FotisRousogiannis/Master-s-Thesis/README.md

# Master-s-Thesis
DEVELOPMENT OF ROBOTIC ARM AND INDEGRATION OF COMPUTER VISION METHODS
