FotisRousogiannis/Master-s-Thesis/docs/decisions/0015-power-architecture-v1.md

# ADR-0015: Αρχιτεκτονική τροφοδοσίας v1 — δύο εξωτερικές γραμμές (7.4 V servo, 5.1 V λογική)

- **Κατάσταση:** Αποδεκτή
- **Ημερομηνία:** 2026-11-08

## Πλαίσιο
Κάθε πλακέτα τμήματος (ADR-0013) τροφοδοτεί έως 9 servo (0.4–0.8 A το καθένα, 2–3 A σε κόλλημα), το Raspberry Pi
(έως 3 A στα 5.1 V), το ESP32 και τους αισθητήρες. Διαθέσιμα: τροφοδοτικό 30 V / 10 A και δύο buck XY5008E (5 A).
Η λογική δεν πρέπει να επηρεάζεται από τις πτώσεις τάσης των servo.

## Εναλλακτικές
1. **Δύο εξωτερικές γραμμές** (7.4 V servo + 5.1 V λογική) προς κάθε πλακέτα· 3.3 V με buck πάνω στην πλακέτα.
2. **Μία γραμμή 7.4 V**, με 5.1 V / 3.3 V στην πλακέτα — λιγότερα καλώδια, αλλά το Pi/ESP32 κινδυνεύουν με reset
   όταν τα servo ρίχνουν την τάση.
3. **Μία γραμμή 24 V** με όλες τις τάσεις στην πλακέτα (buck ~10 A) — η πρακτική των βιομηχανικών βραχιόνων:
   ~3× μικρότερο ρεύμα στα καλώδια, ανεξάρτητα τμήματα· αλλά δύσκολο και θερμό κύκλωμα σε πλακέτα 10 × 10 cm.

## Απόφαση
**Επιλογή 1 για το v1.** Η επιλογή 3 καταγράφεται ως κατεύθυνση για το v2.

## Αιτιολόγηση
Πλήρης διαχωρισμός ισχύος servo και λογικής (καμία επίδραση των servo στο Pi/ESP32/αισθητήρες)· το θερμό,
υψηλού ρεύματος κύκλωμα μένει εκτός της πυκνής πλακέτας· αξιοποιούνται τα υπάρχοντα buck. Πτώση τάσης στο καλώδιο
προς τον καρπό (18 AWG, ~1 m, 5 A): ~0.2 V — αποδεκτή.

## Συνέπειες
- Buck servo ρυθμισμένο στα **7.2–7.4 V** (προδιαγραφή servo: 5.0–7.4 V)· όχι 7.8 V.
- Καλώδια 7.4 V **≥ 18 AWG** μέχρι τον καρπό.
- **E-stop κεντρικά** στη γραμμή 7.4 V (στη βάση, πριν από τις πλακέτες) + E-stop σε κάθε πλακέτα ως δεύτερο επίπεδο.
- Το USB-C του ESP32 τροφοδοτεί μόνο το ESP32 (προγραμματισμός), με δίοδο ώστε να μην τροφοδοτεί την υπόλοιπη πλακέτα.
- Οι connectors τροφοδοσίας πρέπει να **μην ταιριάζουν** με τους connectors σημάτων (αποφυγή λάθους σύνδεσης).

## Συμπλήρωμα (2026-11-08): προστασίες εισόδων
- **eFuse** σε κάθε είσοδο: **TPS259827** στα 7.4 V (όριο ~10 A, soft-start για την αιχμή φόρτισης των πυκνωτών,
  pin EN ώστε το ESP32/Pi να κόβει με υλικό την τροφοδοσία των servo σε σφάλμα ή απώλεια επικοινωνίας) και **TPS25947**
  στα 5.1 V (όριο ~4 A, αποκλεισμός ανάστροφου ρεύματος — αντικαθιστά ασφάλεια + ιδανική δίοδο για το Pi).
- Παραμένουν: P-MOSFET προστασίας πολικότητας (το eFuse δεν την καλύπτει), TVS (ταχύτερο για στιγμιαίες αιχμές),
  εφεδρική ασφάλεια 15 A στα 7.4 V, E-stop υλικού σε σειρά που απενεργοποιεί και το eFuse.
- eFuse ανά κανάλι: εκτός v1.

## Συμπλήρωμα (2026-11-08): έξοδος τροφοδοσίας προς την επόμενη πλακέτα
- Κάθε πλακέτα έχει **έξοδο 7.4 V** (XT30UPB-F, θηλυκό, κάθετο) και **έξοδο 5.1 V** (MSTB 2 pins) για την επόμενη
  πλακέτα (πλάτη → καρπός), ώστε να αρκεί ένα ζεύγος τροφοδοτικών για όλο τον βραχίονα.
- Σημείο λήψης: **πριν από το eFuse** της πλακέτας (μετά την ασφάλεια 15 A, την προστασία πολικότητας και το TVS στα
  7.4 V· μετά το TVS στα 5.1 V). Επιλογή του Φώτη (εναλλακτική: μετά το eFuse, με κοινό όριο ρεύματος για όλα).
  - Κάθε πλακέτα κρατά **δικό της** όριο ρεύματος (10 A servo / 4.4 A λογική) και δική της αποκοπή servo (EN).
  - Η ασφάλεια 15 A, το XT30 και το P-MOSFET της πρώτης πλακέτας φέρουν το ρεύμα **όλου** του βραχίονα (στόχος ≤ 8 A
    συνεχώς)· οι διαδρομές `VS_*` στο PCB διαστασιολογούνται για 15 A.
  - **E-stop:** κουμπί με **2 επαφές NC** (μία στο connector E-STOP κάθε πλακέτας) ή γέφυρα (jumper) σε πλακέτα χωρίς
    E-stop· το κεντρικό E-stop στη γραμμή 7.4 V (παραπάνω) παραμένει.
