FotisRousogiannis/Master-s-Thesis/docs/decisions/0009-provisional-kinematic-model.md

# ADR-0009: Προσωρινό κινηματικό μοντέλο μέχρι το export από Fusion 360

- **Κατάσταση:** Αποδεκτή
- **Ημερομηνία:** 2026-10-20

## Πλαίσιο
Το CAD του βραχίονα βρίσκεται στο Fusion 360 και δεν έχει εξαχθεί ακόμα. Για να
προχωρήσει η ανάπτυξη (URDF, RViz, Gazebo, ros2_control, CI) χρειάζεται ένα μοντέλο τώρα.

## Απόφαση
- Προσωρινό URDF (`arm_description/urdf/arm.urdf.xacro`) με 6 περιστροφικές
  **λογικές** αρθρώσεις `joint_1` … `joint_6`, κυλινδρικούς συνδέσμους και
  ενδεικτικές διαστάσεις/μάζες (σύνολο ~4.6 kg, ύψος ~1.1 m).
- Όρια ταχύτητας από το BOM: 300°/s ÷ 36 ≈ 8.3°/s ≈ 0.145 rad/s.
- Όλες οι προσωρινές τιμές συγκεντρώνονται ως `xacro:property` στην αρχή του αρχείου.
- Το URDF περιγράφει **λογικές** αρθρώσεις· η μίξη των διαφορικών γίνεται στο firmware (ADR-0005).

## Συνέπειες
- Όταν έρθει το export (URDF + STL ανά σύνδεσμο), αντικαθίστανται γεωμετρία,
  μάζες, αδράνειες και η διάταξη/ονόματα αρθρώσεων· το ADR αυτό σημειώνεται ως αντικατασταθέν.
- Τα tests του `arm_description` ελέγχουν δομή (6 αρθρώσεις, ενιαία αλυσίδα,
  έγκυρα όρια, θετικές μάζες) και πρέπει να συνεχίσουν να περνούν.
