FotisRousogiannis/Master-s-Thesis/hardware/pcb/segment_board/SPEC.md

# Πλακέτα τμήματος (segment board) — προδιαγραφή v1

Μία κοινή πλακέτα για **κάθε τμήμα** του βραχίονα (link 1, καρπός). Ίδιο PCB παντού·
διαφορετικά εξαρτήματα κουμπώνονται ανάλογα με τη θέση. Απόφαση: ADR-0013.
Κατάσταση: **εγκεκριμένη** (2026-11-07) — 4 στρώσεις, 5 τεμάχια, SMD με συναρμολόγηση από το εργοστάσιο.

## 1. Βασικές απαιτήσεις
| # | Απαίτηση |
|---|---|
| R1 | Διαστάσεις **100 × 100 mm**, **4 στρώσεις** (Σήμα / GND / Τροφοδοσία / Σήμα), **4 οπές M3 περιμετρικά (γωνίες)** — η θήκη σχεδιάζεται από τον φοιτητή γύρω από την πλακέτα. Παραγγελία **5 τεμαχίων**. |
| R2 | **ESP32-S3-WROOM-1** (SMD module με πιστοποιημένη κεραία) πάνω στην πλακέτα — ο τοπικός ελεγκτής κάθε τμήματος· **USB-C** για προγραμματισμό/debug. |
| R3 | **Υποδοχή για Raspberry Pi 4 από πάνω, ανάποδα (εξαρτήματα προς την πλακέτα):** ψηλό female header 2×20 στην πάνω πλευρά + 4 οπές M2.5 (58 × 49 mm) για αποστάτες ~20 mm. Η πλακέτα βιδώνει πρώτα στα mounts· το Pi μπαίνει/βγαίνει από πάνω. Επειδή το Pi είναι ανάποδα, η διάταξη του header είναι **κατοπτρική** ως προς το πρότυπο HAT. Κάτω από το περίγραμμα του Pi μόνο χαμηλά SMD (ελεύθερο ύψος ≥ 18 mm για USB/Ethernet του Pi). |
| R3α | **Τροφοδοσία του Pi από τα pins 5V του GPIO** (pins 2, 4· GND 6, 9, 14, 20, 25, 30, 34, 39), από τη γραμμή λογικής 5.1 V της πλακέτας, με ασφάλεια, TVS και **ιδανική δίοδο** ώστε να μην υπάρχει σύγκρουση αν συνδεθεί ταυτόχρονα και το USB-C του Pi. |
| R4 | **Κάθε πλακέτα αυτόνομα λειτουργική για ολόκληρο τον βραχίονα:** υποδοχές για **9 servo, 6 AS5600, 2 ZD10**, ανεξάρτητα από το πόσα χρησιμοποιούνται σε κάθε θέση. Τα επιπλέον κανάλια (PCA9685 9–15, mux 6–7, ADS A2–A3) σε header επέκτασης. |
| R5 | Λειτουργία **ESP32 ως master I²C** (στόχος) ή **Pi ως master I²C** (σημερινός πάγκος, χωρίς ESP32), με jumpers. Ποτέ και οι δύο μαζί. |
| R6 | **Pi ↔ ESP32** ίδιας πλακέτας: UART0 (GPIO14/15) + έλεγχος EN/BOOT από 2 GPIO του Pi. **Προς την άλλη πλακέτα:** RS-485 full-duplex στο connector LINK, που συνδέεται με jumper στο UART5 του Pi (GPIO12/13) ή στο UART του ESP32 (ADR-0014). |
| R7 | Τροφοδοσία servo έως **~8 A** συνεχώς. **eFuse** στις εισόδους 7.4 V (TPS259827: όριο ~10 A, soft-start, **αποκοπή τροφοδοσίας servo από ESP32/Pi**) και 5.1 V (TPS25947: όριο ~4 A, αποκλεισμός ανάστροφου ρεύματος). E-stop υλικού σε σειρά (ανεξάρτητο από ηλεκτρονικά), προστασία πολικότητας, TVS, εφεδρική ασφάλεια 15 A, μεγάλοι πυκνωτές. **Έξοδοι 7.4 V (XT30) και 5.1 V (MSTB) προς την επόμενη πλακέτα**, πριν από το eFuse (ADR-0015). |
| R8 | **SMD** εξαρτήματα, συναρμολόγηση από το εργοστάσιο (JLCPCB PCBA, μία πλευρά). Διαμπερή (THT) μόνο για connectors, κλέμες, header HAT και ηλεκτρολυτικούς. |

## 2. Μπλοκ διάγραμμα
```
 7.4 V servo (XT30) ─► [ασφάλεια 15 A] ─► [P-MOSFET πολικότητας] ─► [TVS] ─► [E-STOP] ─► [eFuse TPS259827, ~10 A,
                       soft-start, EN ← ESP32/Pi] ─► [πυκνωτές] ─► [INA219 shunt] ─► servo (σήματα από PCA9685)
 5.1 V λογική (MSTB) ─► [TVS] ─► [eFuse TPS25947, ~4 A, αποκλεισμός ανάστροφου ρεύματος] ─┬─► 5V pins Pi (GPIO)
                                                                                         └─► buck 3.3 V ─► ESP32, PCA9685,
                                                                                             TCA9548A, ADS1115, INA219, TCA9535, AS5600, ZD10
 USB-C ESP32 ─► [ιδανική δίοδος LM66100] ─► (τροφοδοσία μόνο για προγραμματισμό)

          ESP32 SDA/SCL ──┐  jumper «I²C master»
          Pi GPIO2/3   ───┴──► κύριο bus I²C ─┬─ PCA9685 (0x40)
                                              ├─ ADS1115 (0x48)
                                              ├─ INA219  (0x44)
                                              └─ TCA9548A (0x70) ─► AS5600 ×6 (κανάλια 0–5),
                                                                     κανάλια 6–7: εφεδρικά
          ESP32 UART ◄── jumpers ──► Pi UART (GPIO14/15)
          ESP32 UART2 ◄────────────► connector «LINK» (UART / RS-485) προς την άλλη πλακέτα
```

## 3. Υποδοχές (connectors)
| Λειτουργία | Πλήθος | Τύπος (πρόταση) | Σημείωση |
|---|---|---|---|
| Servo | 9 | MCV 1,5/3-G-3,5 — **1 GND · 2 V+ · 3 σήμα** (ίδια σειρά με το καλώδιο servo: καφέ, κόκκινο, πορτοκαλί) | V+ και GND από επιφάνειες χαλκού· κανάλια 9–15 σε header επέκτασης |
| AS5600 | 6 | MCV 1,5/4-G-3,5 — **1 GND · 2 VCC (3.3 V) · 3 SCL · 4 SDA** (όπως η υπάρχουσα καλωδίωση) | κανάλια 0–5 του TCA9548A· 6–7 σε header επέκτασης |
| Αισθητήρες αφής ZD10 | 2 | MCV 1,5/2-G-3,5 (3.3 V, σήμα) | διαιρέτης 6.8 kΩ πάνω στην πλακέτα (A0, A1) |
| Αναλογικές εφεδρικές | 2 | pin header | A2, A3 του ADS1115 |
| Τροφοδοσία servo 7.4 V | 1 | MCV 1,5/4-G-3,5 (2 × V+, 2 × GND) | 2 pins παράλληλα ανά πόλο (8 A/pin) |
| Τροφοδοσία λογικής 5.1 V | 1 | MCV 1,5/2-G-3,5 | Pi έως 3 A + ESP32 + λογική |
| E-STOP | 1 | MCV 1,5/2-G-3,5 — επαφή NC **σε σειρά με τη γραμμή EN του eFuse servo** (χαμηλό ρεύμα· η κεντρική E-stop κόβει τα 7.4 V στη βάση) | jumper γέφυρας όταν δεν συνδέεται κουμπί |
| LINK προς άλλη πλακέτα | 1 | MCV 1,5/5-G-3,5 (Y, Z, A, B, GND) — RS-485 full-duplex | καλώδιο 2 συνεστραμμένων ζευγών (π.χ. Ethernet) |
| Θύρα I²C επέκτασης | 1 | JST-SH 4 pin (Qwiic) | για μελλοντικούς αισθητήρες |

## 3α. Κύρια εξαρτήματα (SMD) — πρόταση
| Λειτουργία | Εξάρτημα | Συσκευασία | Σημείωση |
|---|---|---|---|
| Ελεγκτής | **ESP32-S3-WROOM-1-N8R8** | module SMD | ενσωματωμένη κεραία, στην άκρη της πλακέτας με keep-out χαλκού (ADR-0014) |
| RS-485 | **THVD1451** full-duplex 3.3 V, χωρίς pins ενεργοποίησης | VSON-8 | + 120 Ω τερματισμός με jumper |
| USB | USB-C 16-pin + USBLC6-2SC6 (ESD) + 2 × 5.1 kΩ (CC) | SMD | εγγενές USB του S3: προγραμματισμός χωρίς επιπλέον chip |
| Οδηγός servo | **PCA9685PW** | TSSOP-28 | |
| Mux I²C | **TCA9548APWR** | TSSOP-24 | + pull-ups σε κάθε κανάλι |
| ADC αφής | **ADS1115IDGS** | VSSOP-10 | |
| Ρεύμα servo | **INA219AIDCN** + shunt **5 mΩ, 2512, ≥ 1 W** | SOT-23-8 | εύρος έως ~±64 A, ανάλυση ~0.2 mA· 8 A → 0.32 W στο shunt |
| 3.3 V | buck 2 A από τα 5.1 V (π.χ. AP63203) | SOT-23-6 | το ESP32 τραβά αιχμές ~0.5 A στο WiFi· γραμμικός θα ζεσταινόταν |
| Προστασία πολικότητας 7.4 V | P-MOSFET ≥ 12 A (π.χ. AO4407A) | SO-8 | χαμηλές απώλειες σε σύγκριση με δίοδο |
| eFuse 7.4 V | **TPS259827** | VQFN-24 | όριο ~10 A, soft-start, EN |
| eFuse 5.1 V | **TPS25947** | VQFN-10 | όριο ~4 A, αποκλεισμός ανάστροφου ρεύματος |
| Εφεδρική ασφάλεια 7.4 V | 15 A (blade ή SMD 2410) | — | τελευταία γραμμή άμυνας |
| TVS εισόδων | SMBJ9.0A (7.4 V), SMBJ5.0A (5.1 V) | SMB | προστασία από υπερτάσεις |
| Πυκνωτές servo | 2 × 1000 µF / 16 V + κεραμικοί | THT + SMD | αιχμές ρεύματος |
| Κουμπιά | BOOT, RESET | SMD | |
| Ενδείξεις τροφοδοσίας | 4 LED: 7.4 V (μετά από ασφάλεια/E-stop), 5.1 V, 3.3 V, «Pi αναμμένο» (από τα 3V3 του Pi) | 0603 | χωρίς λογισμικό |
| LED σύνδεσης | 17 LED + 5 × **LM339** + αντιστάσεις μέτρησης | 0603 + SOIC-14 | βλ. §3γ |
| LED κατάστασης ESP32 | 1 LED σε GPIO (κόκκινο) | 0603 | |
| Χρώματα LED | κιτρινοπράσινο AlInGaP (Everlight 19-217/G7C, C2986030) για τροφοδοσία + σύνδεση, κίτρινο για «Pi αναμμένο», κόκκινο για κατάσταση — όλα Vf ≈ 2 V, ώστε να φωτίζουν από 3.3 V (μπλε/πράσινο InGaN ≈ 3 V θα ήταν σχεδόν σβηστά· `sim/`) | 0603 | |

## 3γ. LED σύνδεσης ανά connector (v1: με υλικό)
Ένα LED δίπλα σε **κάθε** connector (9 servo + 6 encoders + 2 αφής = **17 LED**): **αναμμένο = συνδεδεμένο**,
**σβηστό = όχι**, χωρίς λογισμικό και χωρίς επιπλέον pins. Ανίχνευση ρεύματος στην **επιστροφή γείωσης** κάθε connector
και συγκριτής **LM339** (open collector → LED):
- **Encoder:** αντίσταση μέτρησης 10 Ω (6.5 mA → 65 mV), αναφορά ~33 mV.
- **Αισθητήρας αφής:** σύγκριση της τάσης του διαιρέτη (0 V χωρίς αισθητήρα, ~0.9 V με αισθητήρα) με 0.3 V.
- **Servo:** αντίσταση μέτρησης **10 Ω** + Schottky **SS54** (5 A, SMA, basic C22452) παράλληλα (περιορισμός πτώσης ~0.33 V στα 0.8 A, ~0.45 V στο μπλοκάρισμα 4 A), αναφορά ~10 mV
  → ανίχνευση στα 0.5–1.5 mA (με το offset του LM339). QY3240MG: ρεύμα ηρεμίας ~5–10 mA, μπλοκάρισμα ~2.5–4 A (στοιχεία από το διαδίκτυο,
  όχι datasheet· παρόμοια servo 4–20 mA) → περιθώριο ≥ ×3. Το SS34 (3 A) δεν άντεχε το μπλοκάρισμα → SS54.
  Παρατεταμένο μπλοκάρισμα (1.8 W στη δίοδο) πρέπει να κόβεται από το firmware (INA219 / encoder). Επιβεβαίωση με μέτρηση.
  Ίδια τιμή με τον encoder (λιγότερες γραμμές BOM). Προσομοίωση: `sim/`.
5 × LM339 (20 συγκριτές, 17 σε χρήση).

## 3β. Οικογένεια connectors
Ο υπόλοιπος βραχίονας χρησιμοποιεί **Phoenix Contact MC 1,5/n-ST-3,5** (φις κλέμας, βήμα 3.5 mm, έως 8 A/pin).
Στην πλακέτα: υποδοχές **MC 1,5/n-G-3,5** (οριζόντιες) ή **MCV 1,5/n-G-3,5** (κάθετες) — footprints
`Connector_Phoenix_MC:PhoenixContact_MC(V)_1,5_n-G-3.5_1x0n_P3.50mm_*`. Τα ρεύματα > 4 A περνούν από
δύο pins παράλληλα.

Υπάρχουσα καλωδίωση βραχίονα (φωτογραφίες 2026-11-07):
- **Servo:** ένα φις 3 pins ανά servo, σειρά **1 GND · 2 V+ · 3 σήμα** (πρόταση, ίδια με το καλώδιο servo).
- **Encoder AS5600:** ένα φις 4 pins ανά encoder, σειρά **1 GND · 2 VCC (3.3 V) · 3 SCL · 4 SDA**.
- **Βάση:** connector 8 pins = 2 encoders (4 + 4).
- **Πάνελ πλάτης (link):** 4 φις servo (3 pins) + 2 φις encoder (4 pins).

Θέσεις πλακετών: **μία στην πλάτη** (κάτω μέρος, με το Pi) και **μία στον καρπό**. Τα πάνελ του βραχίονα
συνδέονται με τις πλακέτες με καλώδια ένα-προς-ένα (ίδια σειρά pins). Connectors πλακέτας **κάθετοι (MCV)**.
Καλώδια I²C (encoders) πάνελ → πλακέτα: < ~30 cm.

## 4. Jumpers
| Jumper | Θέσεις | Χρήση |
|---|---|---|
| JP_I2C | ESP32 / Pi | ποιος οδηγεί το κύριο bus I²C |
| JP_UART | ανοιχτό / κλειστό | σύνδεση UART0 Pi ↔ ESP32 της ίδιας πλακέτας (+ EN/BOOT) |
| JP_LINK | Pi / ESP32 | το RS-485 του LINK πάει στο UART5 του Pi (link 1) ή στο ESP32 (καρπός) |
| JP_TERM | ανοιχτό / κλειστό | τερματισμός 120 Ω στο άκρο λήψης του RS-485 |
| JP_ESTOP | γέφυρα | όταν δεν υπάρχει κουμπί E-stop |

## 5. Διευθύνσεις I²C (κάθε πλακέτα έχει δικό της bus)
| Συσκευή | Διεύθυνση | Ρύθμιση |
|---|---|---|
| PCA9685 | 0x40 | προεπιλογή |
| INA219 | **0x44** | A1 → VS (η 0x40 συγκρούεται με τον PCA9685) |
| ADS1115 | 0x48 | ADDR → GND· A0/A1 = ZD10, A2 εφεδρική, **A3 = μέτρηση 3.3 V** (διόρθωση ratiometric) |
| TCA9548A | 0x70 | προεπιλογή |
| AS5600 | 0x36 | πίσω από τον mux, ένας ανά κανάλι |

## 6. Χρήση ανά θέση
| | Κάτω μέρος (link 1) | Πάνω μέρος (καρπός) |
|---|---|---|
| ESP32 | ✅ | ✅ |
| Raspberry Pi (HAT) | ✅ | — |
| Servo | **4** | **5** |
| AS5600 | **3** | **3** |
| ZD10 | — | **2** |
| LINK | προς καρπό | προς link 1 |

Σύνολο: 9 servo, 6 encoders, 2 αισθητήρες αφής. **Κάθε πλακέτα** έχει υποδοχές για **όλα** (9 / 6 / 2) και μπορεί να οδηγήσει μόνη της ολόκληρο τον βραχίονα· επέκταση έως 16 servo / 8 encoders μέσω header.

## 7. Ανοιχτά σημεία
- Διαθεσιμότητα εξαρτημάτων στη βιβλιοθήκη της JLCPCB (basic/extended) — οριστικοποίηση στο BOM.
- Τροφοδοσία Pi μέσω των 5V pins του HAT (παρακάμπτει την ασφάλεια του Pi) — απαιτεί ασφάλεια στην πλακέτα.

## 8. Εκτός v1 — ιδέες για επόμενη έκδοση
- Ανίχνευση σύνδεσης **με υλικό** (συγκριτές ρεύματος ανά connector).
- **Επαναφερόμενη ασφάλεια (PTC) ανά κανάλι** servo/encoder.
- **«Έξυπνοι διακόπτες»** τροφοδοσίας ανά servo (open-load, προστασία, ανοιγοκλείσιμο ανά servo).
- **Οθόνη OLED** 0.96" (I²C) για κατάσταση/διάγνωση.
- Υποδοχή **USB-C** για τροφοδοσία του Pi (εναλλακτικά των pins του GPIO).

## 9. Σχηματικό
Παράγεται από κώδικα: `gen/build.py` (μοναδική πηγή του κυκλώματος) → `segment_board.kicad_sch` + 5 φύλλα,
`lib/segment_board.kicad_sym` (σύμβολα που λείπουν από το KiCad: TPS259827, TPS259472A, LM66100, AO4407A, από τα datasheets).
PDF: `output/segment_board_schematic.pdf`. Έλεγχος: `gen/check_netlist.py` (+ ERC στο KiCad 9).
Εκκρεμότητες: footprints των eFuse (TI RGE0024 με 2 EP, RPW0010A) και κατοπτρικό footprint του header του Pi — στο layout.
