FotisRousogiannis/Master-s-Thesis/NOTES.md

# Σημειώσεις εργασίας — Διπλωματική

Αυτό το αρχείο κρατά τις αποφάσεις και την κατάσταση της διπλωματικής, ώστε
κάθε νέα συνεδρία να συνεχίζει από εκεί που μείναμε. **Διάβασέ το πρώτο και
ενημέρωσέ το** όταν αλλάζει κάτι (δομή, αποφάσεις, πρόοδος).

## Στοιχεία εργασίας
- **Τίτλος (EL):** ΑΝΑΠΤΥΞΗ ΚΑΙ ΣΧΕΔΙΑΣΜΟΣ ΡΟΜΠΟΤΙΚΟΥ ΒΡΑΧΙΟΝΑ 6 ΑΞΟΝΩΝ ΕΛΕΥΘΕΡΙΑΣ ΚΑΙ ΕΦΑΡΜΟΓΗ ΜΕΘΟΔΩΝ ΤΕΧΝΗΤΗΣ ΟΡΑΣΗΣ
- **Τίτλος (EN):** DESIGN AND DEVELOPMENT OF A 6-DOF ROBOTIC ARM AND IMPLEMENTATION OF COMPUTER VISION METHODS
- **Φοιτητής:** Φώτης Ρουσογιάννης
- **Επιβλέποντες:** Γεράσιμος Ποταμιάνος – Κατερίνα Παπαδημητρίου
- **Τμήμα:** Ηλεκτρολόγων Μηχανικών και Μηχανικών Υπολογιστών, Πανεπιστήμιο Θεσσαλίας
- **Ημερομηνία (εξώφυλλο):** 10/2026

## Δομή repository (ADR-0003)
- `thesis/Syggrafi_Diplomatikis_Ergasias_Word_PPS_Ypodeigma_July_2021.docx` — **το
  κείμενο της διπλωματικής** (υπόδειγμα ΠΠΣ).
- `software/` — `docker/` (περιβάλλον), `ros2_ws/` (ROS 2 packages), `firmware/` (ESP32),
  `cad_export/` (export από Fusion 360).
- `docs/architecture.md` — η τρέχουσα αρχιτεκτονική με μια ματιά.
- `docs/decisions/` — ADR: κάθε απόφαση με εναλλακτικές και αιτιολόγηση.
- `docs/devlog.md` — ημερολόγιο ανάπτυξης.
- `docs/testing/` — πρωτόκολλα και αποτελέσματα δοκιμών στον βραχίονα.
- `test.txt` — παλιό αρχείο δοκιμής, άσχετο με την εργασία.

## Branches
`draft` (ανάπτυξη) → `testing` (επαληθευμένο σε sim, προς δοκιμή στο υλικό)
→ `main` (μόνο εγκεκριμένα). Προώθηση με Pull Request. Commits στο όνομα του
Φώτη, χωρίς αναφορές σε εργαλεία AI.

## Αρχιτεκτονική λογισμικού (σύνοψη — λεπτομέρειες στο docs/architecture.md)
- Λογισμικό από την αρχή (fresh start)· ο παλιός κώδικας του Robotic-Arm/software δεν χρησιμοποιείται.
- Υπολογιστής = μοναδικός ROS 2 host (ROS 2 Jazzy σε Docker): ros2_control,
  micro-ROS Agent, MoveIt 2, όραση, RViz/Gazebo. **Χωρίς Raspberry Pi.**
- 2 PCB με ESP32 (link 1, wrist): τοπικός βρόχος θέσης στα AS5600, μίξη
  διαφορικών, watchdog. Ένα node ανά ESP32, ίδιο firmware, micro-ROS.
- I²C μόνο μέσα στην πλακέτα· WiFi (micro-ROS/UDP) προς υπολογιστή· USB για debugging.
- RealSense D435if σταθερή (eye-to-hand), USB 3 στον υπολογιστή.

## Πηγή τεχνικής τεκμηρίωσης
Repo `FotisRousogiannis/Robotic-Arm`, branch `claude/connected-repository-d8u6hw`
(δημόσιο, μόνο ανάγνωση από εδώ — clone στο `/home/user/fotisrousogiannis/robotic-arm`):
- `docs/BOM.md` — εξαρτήματα, servo QY3240MG + πλανητικός 1:36, έδρανα, επιδόσεις
- `docs/MECHANICAL_STANDARDS.md` — κοχλίες, ανοχές, γρανάζια, DIN 5480, I²C map
- `docs/MECHANICAL_ANALYSIS.md` — ροπές, φόρτιση δοντιών, διαφορικά (5 kg)
- `docs/ARCHITECTURE.md`, `docs/SYSTEM_ARCHITECTURE.md` — διαφορικοί σύνδεσμοι,
  ESP32 ανά τμήμα + micro-ROS, κατανεμημένο ROS 2 + UI
- `docs/BENCH_TESTING.md` — δοκιμές ταχύτητας/ρεύματος (Pi + PCA9685)
- Επίσης: `Papers/`, `Reports/`, και οι επίσημες οδηγίες ΠΠΣ
  (`ΟΔΗΓΙΕΣ ΕΚΠΟΝΗΣΗΣ ΔΙΠΛΩΜΑΤΙΚΩΝ ΕΡΓΑΣΙΩΝ (ΠΠΣ) July 30 2021.pdf`).

Τα τεχνικά στοιχεία (αριθμοί, εξαρτήματα) **παίρνονται από εκεί** — δεν
επινοούνται. Αν κάτι λείπει ή είναι ❓ στα docs, ρωτάμε τον Φώτη.

## Δομή κεφαλαίων (συμφωνημένη, όπως στην §1.2)
1. **Εισαγωγή** — πλαίσιο, αντικείμενο, συνεισφορά, οργάνωση τόμου
2. **Θεωρητικό υπόβαθρο** — βασικές έννοιες ρομποτικής (κινηματική κ.λπ.), τεχνητή όραση
3. **Μηχανικός σχεδιασμός** — κινηματική διαμόρφωση, αρθρώσεις, μηχανισμοί μετάδοσης
4. **Ηλεκτρονική σχεδίαση** — τροφοδοσία, έλεγχος ενεργοποιητών, αισθητήρες
5. **Λογισμικό & αρχιτεκτονική ελέγχου (ROS 2)**
6. **Τεχνητή όραση & τρισδιάστατη αντίληψη** — κάμερα RGB-D, εκτίμηση θέσης/προσανατολισμού
7. **Ολοκλήρωση υποσυστημάτων** — αυτόνομος χειρισμός αντικειμένων
8. **Πειραματική αξιολόγηση & συμπεράσματα** — αποτελέσματα, περιορισμοί, μελλοντικές επεκτάσεις

## Κατάσταση
- [x] Εξώφυλλα (EL/EN) — τίτλος, όνομα, επιβλέποντες, ημερομηνία
- [x] Κεφ. 1: Εισαγωγή, 1.1 Αντικείμενο, 1.1.1 Συνεισφορά, 1.2 Οργάνωση τόμου
- [ ] Καθάρισμα Κεφ. 1: διπλή ενότητα «Οργάνωση του τόμου» (η πρώτη είναι του
      υποδείγματος, με σπασμένη παραπομπή), οδηγίες υποδείγματος σε [...]
- [ ] Επιτροπή εξέτασης, υπεύθυνες δηλώσεις (ονόματα), ευχαριστίες
- [ ] Περίληψη / Abstract + λέξεις-κλειδιά (τώρα είναι του υποδείγματος)
- [ ] Κεφ. 2–8 (τα Κεφ. 2–6 του αρχείου είναι ακόμα περιεχόμενο υποδείγματος)
- [ ] Βιβλιογραφία, Συντομογραφίες, Παραρτήματα
- [ ] Ενημέρωση πινάκων περιεχομένων / εικόνων / πινάκων (στο Word: F9)

## Κατάσταση λογισμικού / υλικού (2026-11-08)
- **Περιβάλλον ανάπτυξης** λειτουργικό (Docker, ROS 2 Jazzy) — `docs/setup/ubuntu.md`, tag `v0.1-dev-env` στο `testing`.
- **URDF:** προσωρινό (ADR-0009). Export από Fusion: δικό μας script `software/tools/fusion_export/` (ADR-0011) — δεν έχει τρέξει ακόμα στον βραχίονα.
- **Πάγκος καρπού** (Raspberry Pi, ADR-0012): `software/tools/wrist_bench/` + πρωτόκολλο `docs/testing/wrist_bench.md`.
  PCA9685 στο mux κανάλι 0, AS5600 στα κανάλια 1/6/7, servo νεκρό σημείο 1600 µs (500–2500),
  διαφορικό στα κανάλια 9/10 με ανεστραμμένο Β. Τα servo κινούνται με `jog`· εκκρεμεί πλήρης αντιστοίχιση καναλιών (T3/T4) και T5.
- **Αισθητήρες αφής:** 2 × ZD10 + ADS1115 (0x48, mux κανάλι 2), διαιρέτης με **6.8 kΩ** — επαληθευμένο (2.5 V σε μέγιστη πίεση). `docs/hardware/wiring.md`.
- **PCB segment board** (`hardware/pcb/segment_board/`, ADR-0013/14/15): σχηματικό από κώδικα (`gen/build.py`),
  ERC KiCad 9 χωρίς σφάλματα, προσομοίωση SPICE των αναλογικών (`sim/`), footprints project (eFuse, Pi ανάποδα, πηνίο),
  LCSC για όλα τα SMD, **αρχικό PCB** (`gen/pcb.py`, μία φορά) με κανόνες JLC/net classes (`gen/rules.py`).
- **Επόμενο:** layout στο KiCad από τον Φώτη με καθοδήγηση (τοποθέτηση → τροφοδοσίες → σήματα → DRC στο CI).
  Εκκρεμεί: μέτρηση ρεύματος ηρεμίας servo (επιβεβαίωση 10 Ω), ρύθμιση buck servo στα 7.2–7.4 V.

## Συνέχεια σε νέα συνεδρία
Πρώτα: ανάγνωση αυτού του αρχείου, του `docs/decisions/README.md`, του `docs/architecture.md` και του `docs/devlog.md`.
Commits στο όνομα του Φώτη, **χωρίς** `Co-Authored-By` ή άλλες αναφορές σε εργαλεία AI.

## Κανόνες γραφής
- Γλώσσα: ελληνικά, ακαδημαϊκό ύφος, απρόσωπη σύνταξη / παθητική φωνή
  («σχεδιάστηκε», «παρουσιάζεται»). Αγγλικοί όροι σε παρένθεση στην πρώτη
  εμφάνιση, π.χ. «βαθμοί ελευθερίας (Degrees of Freedom, DOF)».
- Συντομογραφίες που εμφανίζονται μπαίνουν και στη λίστα «Συντομογραφίες».
- Χρήση των styles του υποδείγματος: `Heading 1/2/3` για τίτλους, `Normal` για
  κείμενο, `Caption` για λεζάντες, `List Paragraph` για λίστες. Όχι χειροκίνητη μορφοποίηση.
- Λεζάντες: «Εικόνα X.Y:», «Σχήμα X.Y:», «Πίνακας X.Y:» όπως στο υπόδειγμα.
- Βιβλιογραφικές αναφορές με αριθμό σε αγκύλες [n], με τη μορφή της λίστας
  «Βιβλιογραφία» του υποδείγματος.
- Για οτιδήποτε δεν έχει ακόμα υλοποιηθεί/μετρηθεί: διατύπωση σε μέλλοντα
  ή «προβλέπεται», ποτέ ψευδή αποτελέσματα.

## Τρόπος δουλειάς
- Η επεξεργασία γίνεται και εκτός του τοπικού υπολογιστή.
  Αν ο Φώτης αλλάξει το .docx τοπικά, κάνει push πριν ζητήσει νέα αλλαγή
  (και γίνεται `git pull` πριν από κάθε αλλαγή), αλλιώς οι αλλαγές συγκρούονται.
- Επεξεργασία του .docx με `python-docx`, διατηρώντας styles και μορφοποίηση.
  Μετά από κάθε αλλαγή: commit + push στο `main`.
- Ενημέρωση της ενότητας «Κατάσταση» και «Αποφάσεις» σε αυτό το αρχείο.

## Αποφάσεις / σημειώσεις
- 2026-10-20: Αυτό το chat ορίζεται ως το επίσημο chat για τη διπλωματική.
- 2026-10-20: Κλείδωσε η αρχιτεκτονική συστήματος (ADR-0001 έως 0009).
- 2026-10-20: Περιβάλλον ανάπτυξης λειτουργικό στον υπολογιστή (Ubuntu 26.04, repo στο
  `~/Desktop/Master-s-Thesis`) — οδηγός: `docs/setup/ubuntu.md`, ADR-0010.
- Το LaTeX template εγκαταλείφθηκε — η εργασία γράφεται σε Word (υπόδειγμα ΠΠΣ).
