FotisRousogiannis/Master-s-Thesis/docs/decisions/0013-segment-board-esp32-with-pi-hat.md

# ADR-0013: Κοινή πλακέτα τμήματος με ESP32 και υποδοχή HAT για Raspberry Pi

- **Κατάσταση:** Αποδεκτή
- **Ημερομηνία:** 2026-11-07
- **Τροποποιεί:** ADR-0004 (ρόλος του Raspberry Pi)

## Πλαίσιο
- Υπάρχει διαθέσιμος χώρος **10 × 10 cm** τόσο στο link 1 όσο και στον καρπό.
- Ο βραχίονας έχει **9 servo, 6 encoders AS5600, 2 αισθητήρες αφής ZD10**.
- Διαθέσιμο σήμερα: Raspberry Pi 4 (ο πάγκος δοκιμών λειτουργεί με αυτό)· ESP32 δεν υπάρχει ακόμα.
- ADR-0005: κάθε τμήμα χρειάζεται τοπικό ελεγκτή ώστε το I²C να μη διασχίζει αρθρώσεις.
- Ο φοιτητής θέλει το Pi να μπορεί να τοποθετείται στο link 1 και να αφαιρείται.

## Εναλλακτικές
1. **Δύο διαφορετικά PCB** (ένα με Pi, ένα με ESP32) — δύο σχεδιάσεις, δύο παραγγελίες.
2. **Ένα PCB για όλο τον βραχίονα με το Pi** — I²C σε καλώδιο μέσα από τις αρθρώσεις (απορρίφθηκε στο ADR-0005).
3. **Κοινό PCB τμήματος με ESP32 και υποδοχή HAT**, ίδιο σε κάθε τμήμα, με υποδοχές για όλα τα εξαρτήματα.

## Απόφαση
**Επιλογή 3** (προδιαγραφή: `hardware/pcb/segment_board/SPEC.md`).
- Κάθε πλακέτα: ESP32-S3-WROOM-1, PCA9685, TCA9548A (6 AS5600), ADS1115 (2 ZD10 + 2 εφεδρικές), INA219, τροφοδοσία με ασφάλειες και E-stop.
- **SMD με συναρμολόγηση από το εργοστάσιο** (αντί για πλακέτα-φορέα με modules): μικρότερη, πιο αξιόπιστη
  (χωρίς headers/καλώδια ανάμεσα σε modules), επαναλήψιμη κατασκευή· κόστος: μεγαλύτερο χρόνο
  παράδοσης και δυσκολότερη διόρθωση λαθών στο υλικό.
- Υποδοχή για το Pi **από πάνω, ανάποδα**, με ψηλό header 2×20 και αποστάτες (~20 mm): η πλακέτα βιδώνει στα mounts και το Pi
  προστίθεται/αφαιρείται από πάνω. Εναλλακτικές που εξετάστηκαν: Pi από κάτω (κλασικό HAT — δεν βολεύει, η πλακέτα βιδώνει πρώτη),
  Pi κανονικά από πάνω με καλωδιοταινία (καλύτερη ψύξη, ένα καλώδιο επιπλέον). Επιλέχθηκε η απευθείας σύνδεση· η ψύξη του Pi
  δεν είναι κρίσιμη για τη χρήση του.
- Το Pi τροφοδοτείται **από τα pins 5V του GPIO** μέσω της πλακέτας (ασφάλεια, TVS, ιδανική δίοδος).
- Jumper επιλογής master I²C: **ESP32** (στόχος) ή **Pi** (σημερινός πάγκος).
- Pi ↔ ESP32 με UART· πλακέτα ↔ πλακέτα με σειριακό καλώδιο (UART, προαιρετικά RS-485).

- **4 στρώσεις**, **5 τεμάχια**. Κατανομή: κάτω μέρος (link 1) 4 servo + 3 AS5600 + Pi·
  πάνω μέρος (καρπός) 5 servo + 3 AS5600 + 2 ZD10.

## Αιτιολόγηση
Μία σχεδίαση, μία παραγγελία, εναλλάξιμες πλακέτες (και ανταλλακτικό)· συμβατή με τον σημερινό
πάγκο (Pi ως master) και με την αρχιτεκτονική-στόχο (ESP32 ανά τμήμα)· το I²C μένει τοπικό σε κάθε τμήμα.

## Συνέπειες
- Ο ρόλος του Pi γίνεται **προαιρετικός ενσωματωμένος υπολογιστής** στο link 1 (π.χ. micro-ROS Agent,
  επικοινωνία με τα ESP32), ενώ ο υπολογιστής παραμένει για MoveIt/όραση — τροποποίηση του ADR-0004.
- Ποτέ δύο masters στο ίδιο I²C: ο jumper και το firmware/λογισμικό πρέπει να το εξασφαλίζουν.
- Η διεύθυνση του INA219 μετακινείται στο 0x44 (σύγκρουση με PCA9685 στο 0x40).
- Το ESP32 ενσωματώνεται στην πλακέτα (WROOM-1)· δεν χρειάζεται ξεχωριστό DevKit.
- Ο σημερινός πάγκος (modules + Pi) παραμένει για δοκιμές μέχρι να έρθουν οι πλακέτες.
