FotisRousogiannis/Master-s-Thesis/docs/decisions/0004-compute-distribution-no-pi.md

# ADR-0004: Κατανομή υπολογισμού — υπολογιστής + ESP32, χωρίς Raspberry Pi

- **Κατάσταση:** Αποδεκτή — **τροποποιήθηκε από ADR-0013**
- **Ημερομηνία:** 2026-10-20

## Πλαίσιο
Τα ESP32 (~520 KB RAM, χωρίς Linux) δεν μπορούν να τρέξουν ros2_control,
MoveIt, όραση ή τον micro-ROS Agent. Χρειάζεται τουλάχιστον ένας υπολογιστής
με Linux/ROS 2. Το ερώτημα είναι αν αυτός θα είναι ο υπολογιστής ανάπτυξης ή
ένα ενσωματωμένο μηχάνημα πάνω στον βραχίονα.

## Εναλλακτικές
1. **Υπολογιστής ως μοναδικός host** — όλα τα «βαριά» (ros2_control, Agent,
   MoveIt, όραση, UI, Gazebo) στον υπολογιστή· τα ESP32 συνδέονται απευθείας.
2. **Raspberry Pi 4 πάνω στον βραχίονα** — ros2_control + Agent στο Pi,
   MoveIt/όραση στον υπολογιστή. Υπέρ: ενσύρματη σύνδεση με τα ESP32,
   ελεγχόμενη στάση αν χαθεί ο υπολογιστής, δρόμος προς αυτονομία. Κατά: ένα
   μηχάνημα και ένα δίκτυο ακόμα, ρύθμιση, πιθανές βλάβες· το Pi 4 δεν σηκώνει όραση.
3. **Jetson Orin onboard** — πλήρης αυτονομία με όραση onboard· κόστος και
   πολυπλοκότητα εκτός εύρους της εργασίας.

## Απόφαση
**Επιλογή 1.** Ο υπολογιστής είναι ο μοναδικός ROS 2 host. Το Raspberry Pi
αφαιρείται από την αρχιτεκτονική.

## Αιτιολόγηση
- Ο υπολογιστής βρίσκεται δίπλα στον βραχίονα στο εργαστήριο· τα πλεονεκτήματα
  του Pi (ενσύρματη σύνδεση σε απόσταση) δεν ισχύουν.
- Η όραση και το MoveIt χρειάζονται τον υπολογιστή ούτως ή άλλως, άρα το Pi
  δεν δίνει αυτονομία.
- Η ασφαλής στάση σε απώλεια σύνδεσης εξασφαλίζεται από watchdog στα ESP32 (ADR-0005).
- Λιγότερα μηχανήματα → λιγότερη ρύθμιση και λιγότερα σημεία αποτυχίας.

## Συνέπειες
- Το PCB του link 1 **δεν χρειάζεται** να είναι HAT του Pi.
- Το λογισμικό δεν αλλάζει αν αργότερα προστεθεί Pi/Jetson: μεταφέρεται εκεί
  το ros2_control και ο Agent. Καταγράφεται στις «Μελλοντικές επεκτάσεις».
