FotisRousogiannis/Master-s-Thesis/docs/decisions/0006-communication-buses.md

# ADR-0006: Δίαυλοι επικοινωνίας — I²C τοπικά, WiFi προς τον υπολογιστή

- **Κατάσταση:** Αποδεκτή — **τροποποιήθηκε από ADR-0014**
- **Ημερομηνία:** 2026-10-20

## Πλαίσιο
Χρειάζονται τρεις συνδέσεις: (α) ESP32 ↔ αισθητήρες/οδηγός servo στην ίδια
πλακέτα, (β) ESP32 ↔ υπολογιστής (στόχοι προς, θέσεις από), (γ) υπολογιστής ↔ δίκτυο.

Σύγκριση διαθέσιμων πρωτοκόλλων:

| | I²C | UART | RS-485 | CAN | WiFi |
|---|---|---|---|---|---|
| Συσκευές | πολλές (διευθύνσεις) | 2 | πολλές | πολλές | πολλές |
| Απόσταση | cm (≤ ~30 cm) | ~1–2 m | έως 1200 m | 40 m+ | δεκάδες m |
| Θόρυβος | ευαίσθητο | μέτριο | ανθεκτικό (διαφορικό) | ανθεκτικό (διαφορικό) | παρεμβολές 2.4 GHz |
| Έλεγχος λαθών | σχεδόν κανένας | λογισμικό | λογισμικό | υλικό (CRC, ACK, retry) | πρωτόκολλο |
| Καθυστέρηση | σταθερή | σταθερή | σταθερή | σταθερή, με προτεραιότητες | **μεταβλητή** (ms–100+ ms) |
| Καλώδια στις αρθρώσεις | — | 2–3 | 2 | 2 | **κανένα** |
| micro-ROS transport | όχι | ναι (serial) | ναι (serial) | όχι επίσημα | ναι (UDP) |

## Εναλλακτικές για τη σύνδεση (β) ESP32 ↔ υπολογιστής
1. **I²C ανάμεσα στις πλακέτες** — απορρίπτεται: σχεδιασμένο για εκατοστά πάνω
   σε μία πλακέτα· σε καλώδιο ~1 m δίπλα σε servo δίνει λάθη και «κολλήματα»·
   δεν υποστηρίζεται από το micro-ROS.
2. **UART / USB** — απλό και επίσημο micro-ROS transport, αλλά μόνο 2 συσκευές
   και καλώδιο μέσα από τις αρθρώσεις μέχρι τον καρπό.
3. **RS-485** — ανθεκτικό σε θόρυβο, αλλά καλώδιο στις αρθρώσεις και επιπλέον transceiver.
4. **CAN** — η βιομηχανική λύση (ενσωματωμένο TWAI στο ESP32 + transceiver),
   αλλά χωρίς επίσημο micro-ROS transport → θα απαιτούσε δικό μας πρωτόκολλο (βλ. ADR-0007).
5. **EtherCAT** — απορρίπτεται: βιομηχανικό fieldbus που απαιτεί ειδικά chip (ESC)
   σε κάθε κόμβο· δεν αφορά αυτή την κλίμακα.
6. **WiFi (micro-ROS over UDP)** — κανένα καλώδιο δεδομένων στις αρθρώσεις,
   επίσημο transport, αλλά μεταβλητή καθυστέρηση και πιθανές απώλειες.

## Απόφαση

| Σύνδεση | Πρωτόκολλο |
|---|---|
| ESP32 ↔ PCA9685, TCA9548A, AS5600 (ίδιο τμήμα) | **I²C** |
| ESP32 ↔ υπολογιστής — κανονική λειτουργία | **WiFi**, micro-ROS over UDP |
| ESP32 ↔ υπολογιστής — bring-up / debugging | **USB σειριακό** (micro-ROS serial) |
| Υπολογιστής ↔ router | **Ethernet** |

Το transport του micro-ROS (UDP ή serial) επιλέγεται με ρύθμιση στο ίδιο firmware.

## Αιτιολόγηση
- Το I²C χρησιμοποιείται μόνο για ό,τι σχεδιάστηκε: chips στην ίδια πλακέτα.
- Ο βρόχος θέσης τρέχει τοπικά (ADR-0005), άρα το WiFi μεταφέρει μόνο στόχους
  και μετρήσεις (~50–100 Hz)· μια καθυστέρηση 20 ms ισοδυναμεί με ~0.16° στα ~8°/s του βραχίονα.
- Το WiFi εξαλείφει τα καλώδια δεδομένων μέσα από τις αρθρώσεις και κάνει τα δύο PCB ανεξάρτητα.

## Συνέπειες / μέτρα
- **Χρονοσφραγίδες και ομαλή παρεμβολή** στόχων στο ESP32, ώστε οι αιχμές καθυστέρησης να μη φαίνονται στην κίνηση.
- **Watchdog** στο ESP32: χωρίς εντολή για ~200 ms → κράτημα θέσης.
- **Δικό μας router 2.4 GHz** δίπλα στον βραχίονα (όχι eduroam), υπολογιστής σε αυτό με Ethernet.
- **Χωριστή τροφοδοσία λογικής** και πυκνωτές κοντά στο ESP32 (αιχμές ρεύματος WiFi + servo).
- **E-stop υλικού** που κόβει την τροφοδοσία των servo ανεξάρτητα από το λογισμικό.
- Η καθυστέρηση και οι απώλειες του WiFi θα **μετρηθούν** στο κεφάλαιο αξιολόγησης.
- Αν το WiFi αποδειχθεί ανεπαρκές, η εναλλακτική είναι CAN (επιλογή 4) με νέο ADR.
