FotisRousogiannis/Master-s-Thesis/docs/decisions/0014-controller-links-uart-rs485.md

# ADR-0014: Σύνδεση ελεγκτών — UART στην πλακέτα, RS-485 ανάμεσα στις πλακέτες

- **Κατάσταση:** Αποδεκτή
- **Ημερομηνία:** 2026-11-07
- **Τροποποιεί:** ADR-0006 (κύρια σύνδεση ESP32 ↔ host)

## Πλαίσιο
Με την πλακέτα τμήματος (ADR-0013) το Raspberry Pi βρίσκεται πάνω στον βραχίονα (link 1).
Πρέπει να επικοινωνεί με το ESP32 της ίδιας πλακέτας και με το ESP32 του καρπού, μέσα από
αρθρώσεις και δίπλα σε servo. Επίσης πρέπει να επιλεγεί μοντέλο ESP32 και μορφή (module ή chip).

## Εναλλακτικές
**Pi ↔ ESP32 ίδιας πλακέτας:** UART (απλό, 3.3 V και τα δύο, transport του micro-ROS) · USB (θέλει καλώδιο) · I²C/SPI (το I²C ανήκει ήδη στα περιφερειακά, master μόνο ένας).
**Pi ↔ ESP32 καρπού:** WiFi (ADR-0006· μεταβλητή καθυστέρηση) · UART σε καλώδιο (ευαίσθητο σε θόρυβο) · **RS-485** (διαφορικό, ανθεκτικό, μεγάλες αποστάσεις) · CAN (χωρίς επίσημο transport micro-ROS).
**Μοντέλο ESP32:** ESP32-S3 (2 πυρήνες, εγγενές USB) · ESP32 κλασικό (χωρίς εγγενές USB) · ESP32-C3/C6 (1 πυρήνας).
**Μορφή:** module (πιστοποιημένο, με κεραία) · γυμνό chip (απαιτεί σχεδίαση RF, κεραίας, κρυστάλλου, flash).

## Απόφαση
- **Pi ↔ ESP32 ίδιας πλακέτας:** UART0 του Pi (GPIO14/15) ↔ UART του ESP32, με αντιστάσεις σειράς·
  επιπλέον 2 GPIO του Pi → **EN** και **BOOT (IO0)** του ESP32, ώστε το Pi να επανεκκινεί και να προγραμματίζει το ESP32.
- **Pi ↔ ESP32 καρπού:** δεύτερο UART του Pi (UART5, GPIO12/13) → **RS-485 full-duplex** (χωρίς εναλλαγή κατεύθυνσης)
  → connector **LINK** → καλώδιο 2 συνεστραμμένων ζευγών + GND → RS-485 → UART του ESP32 του καρπού.
  Jumper στην πλακέτα: το LINK συνδέεται στο **Pi** (link 1) ή στο **ESP32** (καρπός). Τερματισμός 120 Ω με jumper.
- **ESP32-S3-WROOM-1-N8R8** (module, ενσωματωμένη κεραία), στην **άκρη** της πλακέτας με keep-out χαλκού κάτω από την κεραία.
- Το **WiFi παραμένει** για ενημέρωση firmware χωρίς καλώδιο (OTA), debugging και ως εφεδρική σύνδεση.

## Αιτιολόγηση
Ενσύρματη, ντετερμινιστική επικοινωνία στον έλεγχο· το RS-485 είναι ανθεκτικό στον θόρυβο των servo
και στις αποστάσεις μέσα από τις αρθρώσεις· το full-duplex αποφεύγει τον έλεγχο κατεύθυνσης στο
σειριακό transport του micro-ROS. Το module απαλλάσσει από σχεδίαση RF και πιστοποίηση.

## Συνέπειες
- Το καλώδιο LINK μεταφέρει 5 σύρματα (2 ζεύγη + GND)· κατάλληλο ένα καλώδιο τύπου Ethernet.
- Στο Pi ενεργοποιείται το UART5 (`dtoverlay=uart5`) και απενεργοποιείται η κονσόλα στο UART0.
- micro-ROS στα ESP32 με **serial transport**· ο micro-ROS Agent τρέχει στο Pi.
- Η αρχική λύση WiFi του ADR-0006 μένει διαθέσιμη ως εναλλακτική.
