FotisRousogiannis/Master-s-Thesis/docs/decisions/0012-bench-rig-raspberry-pi.md

# ADR-0012: Πάγκος δοκιμών καρπού με Raspberry Pi (προσωρινός)

- **Κατάσταση:** Αποδεκτή
- **Ημερομηνία:** 2026-11-01

## Πλαίσιο
Το PCB με ESP32 δεν είναι έτοιμο. Διαθέσιμο είναι ένα Raspberry Pi συνδεδεμένο με
TCA9548A και PCA9685. Ο καρπός (4 servo, 3 AS5600) πρέπει να ελεγχθεί πριν από την
ανάπτυξη firmware και ROS: συνδέσεις, encoders, νεκρά σημεία, φορές, διαφορικό.

## Εναλλακτικές
1. **Αναμονή για το PCB/ESP32** — καθυστέρηση, και τα σφάλματα υλικού ανακαλύπτονται αργότερα.
2. **ESP32 dev board σε breadboard** — πιο κοντά στον τελικό στόχο, αλλά δεν είναι διαθέσιμο τώρα.
3. **Raspberry Pi ως πάγκος δοκιμών** με εργαλείο Python, χωρίς ROS.

## Απόφαση
**Επιλογή 3**, με το `software/tools/wrist_bench/` (Python, `smbus2`, δικοί μας οδηγοί
PCA9685/TCA9548A/AS5600) και το πρωτόκολλο `docs/testing/wrist_bench.md` (T0–T5).

## Αιτιολόγηση
Άμεση επαλήθευση του υλικού με ό,τι υπάρχει· ελάχιστες εξαρτήσεις· οι οδηγοί
ελέγχονται με προσομοιωμένο bus. Τα αποτελέσματα (κανάλια, νεκρά σημεία, πρόσημα,
μίξη διαφορικού) μεταφέρονται αυτούσια στη ρύθμιση του firmware του ESP32.

## Συνέπειες
- **Δεν αλλάζει η τελική αρχιτεκτονική** (ADR-0004): το Pi είναι εργαλείο δοκιμών.
- Ασφάλεια σε κάθε κίνηση: όριο απόκλισης παλμού, όριο διάρκειας, όριο διαδρομής
  από τους encoders, έξοδοι off στο τέλος και σε κάθε διακοπή.
- Οι δοκιμές κλειστού βρόχου (T6–T7) θα γίνουν στο ESP32, όπου θα τρέχει ο τελικός βρόχος.
