FotisRousogiannis/Master-s-Thesis/ΔΙΠΛΩΜΑΤΙΚΗ_ΕΡΓΑΣΙΑ_ΣΥΓΓΡΑΦΗ/chapter1.tex

\chapter{Εισαγωγή}
\label{chap1}

Εδώ αυτή κάνουμε μια γενική περιγραφή του χώρου εφαρμογής της διπλωματικής. Αναφέρουμε τα χαρακτηριστικά του χώρου και καταλήγουμε στα γενικότερα προβλήματα που αντιμετωπίζει ο χώρος. Η συζήτηση των προβλημάτων θα πρέπει να προϊδεάζει τον αναγνώστη για το τι θα προσπαθήσει να αντιμετωπίσει η διπλωματική, χωρίς ακόμα να αναφερόμαστε συγκεκριμένα στο αντικείμενο της διπλωματικής.

\section{Αντικείμενο της διπλωματικής}

Εδώ αναφερόμαστε συγκεκριμένα στο τί θα κάνει η διπλωματική. Αναφέρουμε λεπτομερώς α) τα προβλήματα που θα λύσει (και που ήδη έχουν περιγραφεί γενικά στην προηγούμενη ενότητα), και β) πώς σκοπεύει να τα λύσει. 
Είναι σημαντικό κάποιος που θα διαβάσει την ενότητα αυτή να καταλάβει σε σημαντικό βαθμό τον σκοπό της διπλωματικής σας και τις τεχνικές δυσκολίες της, χωρίς να είναι αναγκαίο να δει όλα τα άλλα κεφάλαια. Η ενότητα αυτή θέλει πολύ προσοχή και καλύτερα να τη γράψετε αφού έχετε γράψει όλα τα υπόλοιπα κεφάλαια.

\subsection{Συνεισφορά}
Εδώ παραθέτουμε αριθμητικά συγκεκριμένες ενέργειες/λύσεις/μεθοδολογίες που παρουσιάζει η διπλωματική και λύνουν τα προβλήματα που υποσχεθήκαμε στην προηγούμενη ενότητα ότι θα λύσει η διπλωματική. Συνήθως η υποενότητα αυτή έχει την παρακάτω μορφή:

Η συνεισφορά της διπλωματικής συνοψίζεται ως εξής:
\begin{enumerate}
\item Μελετήθηκαν συστήματα κ.λ.π.
\item Υλοποιήθηκαν τρεις αλγόριθμοι υπολογισμού κ.λ.π.
\item Αξιολογήθηκε η επίδοση των αλγορίθμων και βρέθηκε ότι κ.λ.π.
\item Ενσωματώθηκαν οι αλγόριθμοι σε πρότυπο σύστημα κ.λ.π.
\item ...
\end{enumerate}

\section{Οργάνωση του τόμου}

Εδώ περιγράφουμε τα κεφάλαια της διπλωματικής: μία πρόταση για το τί θα έχει  κάθε κεφάλαιο.Συνήθως η ενότητα αυτή έχει την παρακάτω μορφή (δεν θα σας πάρει πάνω από μία μεγάλη παράγραφο):

Εργασίες σχετικές με το αντικείμενο της διπλωματικής παρουσιάζονται στο Κεφάλαιο \ref{chap2}. Το Κεφάλαιο ... συζητά θέματα μοντελοποίησης. Στο Κεφάλαιο ... αναπτύσσουμε κ.λ.π. 

Για την τελική οργάνωση του κειμένου σας, συμβουλευθείτε τον επιβλέποντα της εργασίας.
