FotisRousogiannis/Master-s-Thesis/ΔΙΠΛΩΜΑΤΙΚΗ_ΕΡΓΑΣΙΑ_ΣΥΓΓΡΑΦΗ/main.tex

%%
% Είδος: διπλωματική στα αγγλικά
\documentclass{uthece-thesis} 

% Πακέτα και ορισμοί που τυχόν χρειάζονται, ανάλογα με το κείμενο της διπλωματικής
\usepackage{algorithm}
\usepackage{algorithmic}

\usepackage[hyphens]{url}
\usepackage{multicol}
\usepackage{multirow}
\usepackage[table]{xcolor}
\usepackage{caption} 
\captionsetup[table]{skip=10pt}
\usepackage{tikz}
\usepackage{datetime}
\usepackage{ifthen}
\usepackage{hyperref} % Για ενεργά URLs

% Πρόσθετοι ορισμοί, ανάλογα με το κείμενο της διπλωματικής
% typeset source code
\newcommand{\src}[1]{{\tt#1}}

% typeset a backslash
\newcommand{\bkslash}{\symbol{92}}

% Κύρια γλώσσα της διπλωματικής
% μην την τροποποιείτε
\ifgrthesisoption 
    \setlanguage{greek}
\else
    \setlanguage{american} 
\fi

%%%%%%%%%%%%%%%%%%%%%%%%%%%%%%%%%%%%%%%%%%%%%%%%%%%%%
%% THESIS INFO / ΠΛΗΡΟΦΟΡΙΕΣ ΔΙΠΛΩΜΑΤΙΚΗΣ
%%
% Τίτλος Διπλωματικής Εργασίας στα ελληνικά
	\title{ΣΧΕΔΙΑΣΗ ΚΑΙ ΑΝΑΠΤΥΞΗ ΡΟΜΠΟΤΙΚΟΥ ΒΡΑΧΙΟΝΑ ΚΑΙ ΕΝΤΑΞΗ ΜΕΘΟΔΩΝ ΤΕΧΝΙΤΗΣ ΟΡΑΣΗΣ ΥΠΟΛΟΓΙΣΤΩΝ }
% Τίτλος Διπλωματικής Εργασίας στα αγγλικά
	\titleEng{ΤITLE OF THESIS IN SMALL OR CAPITAL LETTERS, CENTERED}
% Ονοματεπώνυμο φοιτητή στα ελληνικά
	\edef\authorname{Ον/μο Φοιτητή}
	\edef\secauthorname{Ον/μο 2ου Φοιτητή} % κενό αν η εργασία έγινε από έναν φοιτητή
% Ονοματεπώνυμο φοιτητή στα αγγλικά 
	\edef\authornameEng{Name Surname of student}
	\edef\secauthornameEng{Name Surname of 2nd student} % κενό αν η εργασία έγινε από έναν φοιτητή
% Ονοματεπώνυμο Επιβλέποντα Καθηγητή στα ελληνικά
	\supervisor{Ονοματεπώνυμο Επιβλέποντα}
% Ονοματεπώνυμο Επιβλέποντα Καθηγητή στα αγγλικά
	\supervisorEng{Name Surname of Supervisor}
% Φύλλο επιβλέποντα στα ελληνικά 
% Μην το τροποποιείτε για διπλωματική στα αγγλικά
	\edef\supervisorMaleFemale{Επιβλέπων/πουσα}
% Στοιχεία επιτροπής στα αγγλικά
    \edef\supervisortitle{Rank/position of Supervisor}
    \edef\supervisoraffiliation{Department of Electrical and Computer Engineering, University of Thessaly}
    \edef\memberonename{Name Surname of Member 1}
    \edef\memberonetitle{Rank/position of Member 1}
    \edef\memberoneaffiation{Department/Institution of Member 1}
    \edef\membertwoname{Name Surname of Member 2}
    \edef\membertwotitle{Rank/position of Member 2}
    \edef\membertwoaffiation{Department/Institution of Member 2}    
% Ημερομηνία υποβολής διπλωματικής
    \newdate{docdate}{04}{02}{2022}
% Ημερομηνία έγκρισης διπλωματικής
    \newdate{docapprovedate}{24}{02}{2022}
% format ημερομηνίας - μην το τροποποιείτε
    \newdateformat{mydate}{\THEDAY-\THEMONTH-\THEYEAR} \mydate
% Τόπος και έτος διπλωματικής στα ελληνικά
	\edef\thesisPlaceDate{Μήνας \getdateyear{docdate}}
% Τόπος και έτος διπλωματικής στα αγγλικά
	\edef\thesisPlaceDateEng{Month \getdateyear{docdate}}
%
%%%%%%%%%%%%%%%%%%%%%%%%%%%%%%%%%%%%%%%%%%%%%%%%%%%%

\begin{document}

\frontmatter
\maketitle

%%%%%%%%%%%%%%%%%%%%%%%%%%%%%%%%%%%%%%%%%%%%%%%%%%%%%
%% OPTIONAL MATERIAL / ΠΡΟΑΙΡΕΤΙΚΕΣ ΕΝΟΤΗΤΕΣ
%%
% Κατάλογος Σχημάτων προαιρετικά
	\listoffigures % σε σχόλια για μη εμφάνιση
% Κατάλογος Πινάκων προαιρετικά
	\listoftables % σε σχόλια για μη εμφάνιση
% Συντομογραφίες - Αρκτικόλεξα - Ακρωνύμια προαιρετικά
	\include{abbreviations} % σε σχόλια για μη εμφάνιση 
%
%%%%%%%%%%%%%%%%%%%%%%%%%%%%%%%%%%%%%%%%%%%%%%%%%%%%

\mainmatter
%%%%%%%%%%%%%%%%%%%%%%%%%%%%%%%%%%%%%%%%%%%%%%%%%%%%%
%% CHAPTERS / ΚΕΦΑΛΑΙΑ 
%%
    \include{chapter1}
    \include{chapter2}
    %\include{chapter...} % προσθέστε όσα χρειάζεται
    \include{chapter_last}
%
%%%%%%%%%%%%%%%%%%%%%%%%%%%%%%%%%%%%%%%%%%%%%%%%%%%%

%\backmatter % μην ενεργοποιείτε την εντολή
% Βιβλιογραφία - Αναφορές
	\bibliography{references}

%%%%%%%%%%%%%%%%%%%%%%%%%%%%%%%%%%%%%%%%%%%%%%%%%%%%%
%% APPENDICES (optional) / ΠΑΡΑΡΤΗΜΑΤΑ (ΠΡΟΑΙΡΕΤΙΚΑ)
%%

% Εάν υπάρχουν περισσότερα από ένα Παραρτήματα
% είναι ενεργή η ακόλουθη εντολή
% και ανενεργή για μεμονωμένο Παράρτημα
    \include{appendices}

% Μην τροποποιήσετε τις ακόλουθες εντολές
\ifgrthesisoption
    \renewcommand{\chaptername}{Παράρτημα}
\else
    \renewcommand{\chaptername}{Appendix}
\fi

% Πριν το κάθε Παράρτημα (για περισσότερα από ένα), 
% ρυθμίζεται η κατάλληλη αλφαβητική αρίθμηση
    \renewcommand{\thechapter}{A} 
  	\include{appA}	
% %	
    \renewcommand{\thechapter}{B}
    \include{appB}

% Εάν υπάρχει μόνο ένα Παράρτημα,
% μπαίνουν σε σχόλια οι παραπάνω γραμμές 
% και ρυθμίζεται αρίθμηση χωρίς γράμμα
%   \renewcommand{\thechapter}{} 
%   \renewcommand{\thesection}{\arabic{section}}
%
% Ακολουθεί αρχείο μεμονωμένου Παραρτήματος
% (διαφορετική δομή από appA/appΒ)
%   \include{single_app} 

%
%%%%%%%%%%%%%%%%%%%%%%%%%%%%%%%%%%%%%%%%%%%%%%%%%%%%

\end{document}
