FotisRousogiannis/Master-s-Thesis/docs/decisions/0003-repo-structure-and-branching.md

# ADR-0003: Δομή repository και ροή branches

- **Κατάσταση:** Αποδεκτή
- **Ημερομηνία:** 2026-10-20

## Πλαίσιο
Κείμενο διπλωματικής, λογισμικό, firmware και τεκμηρίωση πρέπει να
οργανωθούν ώστε να υπάρχει ιχνηλασιμότητα και καθαρός διαχωρισμός ανάμεσα
σε δουλειά σε εξέλιξη, δοκιμή και οριστικό αποτέλεσμα.

## Εναλλακτικές
1. **Ένα repo** (`master-s-thesis`) για κείμενο + λογισμικό + τεκμηρίωση.
2. Χωριστά repos για κείμενο και λογισμικό — καθαρότερος διαχωρισμός, αλλά
   διπλή διαχείριση και κατακερματισμένη τεκμηρίωση.

## Απόφαση
Ένα repo με δομή `thesis/`, `software/` (docker, ros2_ws, firmware,
cad_export), `docs/` (decisions, devlog, testing).

Ροή branches: **`draft` → `testing` → `main`**
- `draft`: ανάπτυξη· κάθε αλλαγή πρέπει να χτίζεται και να περνά τα tests.
- `testing`: επαληθευμένο σε προσομοίωση, προς δοκιμή στον πραγματικό βραχίονα.
- `main`: μόνο εγκεκριμένα αποτελέσματα.
- Η προώθηση γίνεται **μόνο με ρητή έγκριση του φοιτητή**, με merge commit
  (`git merge --no-ff`), ώστε κάθε προώθηση να φαίνεται ως ξεχωριστό σημείο στο ιστορικό.
- Τα ορόσημα σημαίνονται με **annotated tags** στο commit της προώθησης
  (π.χ. `v0.1-dev-env`, `v0.2-sim-control`).

Συμβάσεις: commits στα αγγλικά (Conventional Commits: `feat`, `fix`, `docs`,
`test`, `chore`), ADR και devlog στα ελληνικά.

## Αιτιολόγηση
Ενιαία ιστορία εργασίας, εύκολη αναφορά του κώδικα από το κείμενο, και
ελεγχόμενη προώθηση από ανάπτυξη σε οριστικό.

## Συνέπειες
- Το CI τρέχει σε κάθε push στα τρία branches και σε κάθε PR.
