FotisRousogiannis/Master-s-Thesis/Syggrafi_Diplomatikis_Ergasias_Word_PPS_Ypodeigma_July_2021.docx

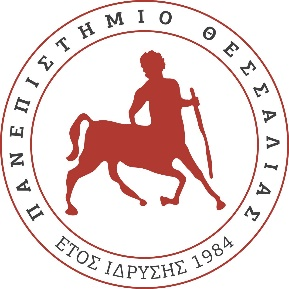
[picture p1: figure]

# ΠΑΝΕΠΙΣΤΗΜΙΟ ΘΕΣΣΑΛΙΑΣ

# ΠΟΛΥΤΕΧΝΙΚΗ ΣΧΟΛΗ

# ΤΜΗΜΑ ΗΛΕΚΤΡΟΛΟΓΩΝ ΜΗΧΑΝΙΚΩΝ ΚΑΙ ΜΗΧΑΝΙΚΩΝ ΥΠΟΛΟΓΙΣΤΩΝ

# Τίτλος διπλωματικής εργασίας στα Ελληνικά

# στοιχισμένος στο κέντρο

# Διπλωματική Εργασία

# Ονοματεπώνυμο φοιτητή

# Επιβλέπων: Ονοματεπώνυμο επιβλέποντος

# Μήνας έτος

# ΠΑΝΕΠΙΣΤΗΜΙΟ ΘΕΣΣΑΛΙΑΣ

# ΠΟΛΥΤΕΧΝΙΚΗ ΣΧΟΛΗ

# ΤΜΗΜΑ ΗΛΕΚΤΡΟΛΟΓΩΝ ΜΗΧΑΝΙΚΩΝ ΚΑΙ ΜΗΧΑΝΙΚΩΝ ΥΠΟΛΟΓΙΣΤΩΝ

# ΑΝΑΠΤΥΞΗ ΚΑΙ ΣΧΕΔΙΑΣΜΟΣ ΡΟΜΠΟΤΙΚΟΥ ΒΡΑΧΙΟΝΑ 6 ΑΞΟΝΩΝ ΕΛΕΥΘΕΡΙΑΣ ΚΑΙ ΕΦΑΡΜΟΓΗ ΜΕΘΟΔΩΝ ΤΕΧΝΙΤΗΣ ΟΡΑΣΗΣ

# Διπλωματική Εργασία

# ΦΩΤΗΣ ΡΟΥΣΟΓΙΑΝΝΗΣ

# Επιβλέπων: ΠΟΤΑΜΙΑΝΟΣ ΓΕΡΑΣΙΜΟΣ – ΚΑΤΕΡΙΝΑ ΠΑΠΑΔΗΜΗΤΡΙΟΥ

# Μήνας έτος: 10/2026

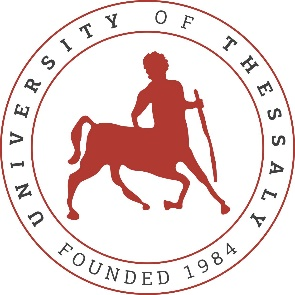
[picture p2: figure]

# UNIVERSITY OF THESSALY

# SCHOOL OF ENGINEERING

# DEPARTMENT OF ELECTRICAL AND COMPUTER ENGINEERING

# Title of the Diploma Thesis in English

# centered

# DESIGN AND DEVELOPMENT OF A 6-DOF ROBOTIC ARM AND IMPLEMENTATION OF COMPUTER VISION METHODS

# FOTIS ROUSOGIANNIS

# Supervisor: POTAMIANOS GERASIMOS – KATERINA PAPADIMITRIOU

Month year: 10/2026

Εγκρίνεται από την Επιτροπή Εξέτασης:

Επιβλέπων/πουσα Ονοματεπώνυμο Επιβλέποντα

Βαθμίδα/ιδιότητα επιβλέποντα, Τμήμα Ηλεκτρολόγων Μηχανικών και Μηχανικών Υπολογιστών, Πανεπιστήμιο Θεσσαλίας

Μέλος Ονοματεπώνυμο Μέλους 1

Βαθμίδα/ιδιότητα μέλους 1, Τμήμα/Ίδρυμα μέλους 1

Μέλος Ονοματεπώνυμο Μέλους 2

Βαθμίδα/ιδιότητα μέλους 2, Τμήμα/Ίδρυμα μέλους 2

ΥΠΕΥΘΥΝΗ ΔΗΛΩΣΗ ΠΕΡΙ ΑΚΑΔΗΜΑΪΚΗΣ ΔΕΟΝΤΟΛΟΓΙΑΣ ΚΑΙ ΠΝΕΥΜΑΤΙΚΩΝ ΔΙΚΑΙΩΜΑΤΩΝ

Με πλήρη επίγνωση των συνεπειών του νόμου περί πνευματικών δικαιωμάτων, δηλώνω ρητά ότι η παρούσα διπλωματική εργασία, καθώς και τα ηλεκτρονικά αρχεία και πηγαίοι κώδικες που αναπτύχθηκαν ή τροποποιήθηκαν στα πλαίσια αυτής της εργασίας, αποτελούν αποκλειστικά προϊόν προσωπικής μου εργασίας, δεν προσβάλλουν οποιασδήποτε μορφής δικαιώματα διανοητικής ιδιοκτησίας, προσωπικότητας και προσωπικών δεδομένων τρίτων, δεν περιέχουν έργα/εισφορές τρίτων για τα οποία απαιτείται άδεια των δημιουργών/δικαιούχων και δεν είναι προϊόν μερικής ή ολικής αντιγραφής, οι πηγές δε που χρησιμοποιήθηκαν περιορίζονται στις βιβλιογραφικές αναφορές και μόνον και πληρούν τους κανόνες της επιστημονικής παράθεσης. Τα σημεία όπου έχω χρησιμοποιήσει ιδέες, κείμενο, αρχεία ή/και πηγές άλλων συγγραφέων αναφέρονται ευδιάκριτα στο κείμενο με την κατάλληλη παραπομπή και η σχετική αναφορά περιλαμβάνεται στο τμήμα των βιβλιογραφικών αναφορών με πλήρη περιγραφή. Δηλώνω επίσης ότι τα αποτελέσματα της εργασίας δεν έχουν χρησιμοποιηθεί για την απόκτηση άλλου πτυχίου. Αναλαμβάνω πλήρως, ατομικά και προσωπικά, όλες τις νομικές και διοικητικές συνέπειες που δύναται να προκύψουν στην περίπτωση κατά την οποία αποδειχθεί, διαχρονικά, ότι η εργασία αυτή ή τμήμα της δεν μου ανήκει διότι είναι προϊόν λογοκλοπής.

Ο/Η Δηλών/ούσα

Ονοματεπώνυμο Φοιτητή/ήτριας

DISCLAIMER ON ACADEMIC ETHICS AND INTELLECTUAL PROPERTY RIGHTS

Being fully aware of the implications of copyright laws, I expressly state that this diploma thesis, as well as the electronic files and source codes developed or modified in the course of this thesis, are solely the product of my personal work and do not infringe any rights of intellectual property, personality and personal data of third parties, do not contain work / contributions of third parties for which the permission of the authors / beneficiaries is required and are not a product of partial or complete plagiarism, while the sources used are limited to the bibliographic references only and meet the rules of scientific citing. The points where I have used ideas, text, files and / or sources of other authors are clearly mentioned in the text with the appropriate citation and the relevant complete reference is included in the bibliographic references section. I also declare that the results of the work have not been used to obtain another degree. I fully, individually and personally undertake all legal and administrative consequences that may arise in the event that it is proven, in the course of time, that this thesis or part of it does not belong to me because it is a product of plagiarism.

The Declarant

Name of Student

# Ευχαριστίες ή Σχόλια

Σελίδα με ευχαριστίες ή σχόλια του συγγραφέα (προαιρετικό)

# Διπλωματική Εργασία

# Τίτλος διπλωματικής εργασίας

# (όπως στο εξώφυλλο)

# Ονοματεπώνυμο φοιτητή

# Περίληψη

# Εδώ ξεκινάει η περίληψη ……………. (Συνήθως μικρότερη μίας σελίδας)

Λέξεις-κλειδιά:

# Ευελιξία ηλεκτροπαραγωγικού συστήματος, χονδρεμπορικές αγορές ηλεκτρισμού, σύζευξη αγορών, διείσδυση των ΑΠΕ, μοντέλο προσομοίωσης των αγορών ηλεκτρισμού, μοντέλο επέκτασης του ηλεκτροπαραγωγικού συστήματος, μονάδες αποθήκευσης

# Diploma Thesis

# Title of Diploma thesis

# (as in cover page)

# Name of student

# Abstract

(Usually less than a page)

Keywords:

Stand-alone hybrid system; HOMER Pro; simulation-optimization; techno-economic

analysis; excess electricity percentage; Net Present Cost (NPC); Levelizez Cost of Energy (LCoE)

# Πίνακας περιεχομένων

# Κατάλογος εικόνων

# Κατάλογος σχημάτων

# Κατάλογος πινάκων

# Συντομογραφίες

βλπ βλέπε

κ.λπ. και λοιπά

κ.ο.κ και ούτω καθεξής

ΤΕΙ Τεχνολογικό Εκπαιδευτικό Ίδρυμα

BPF Band Pass Filter

# Κεφάλαιο 1 Εισαγωγή

# Κεφάλαιο 1 Κεφάλαιο 1: Εισαγωγή

[Εδώ αυτή κάνουμε μια γενική περιγραφή του χώρου εφαρμογής της διπλωματικής. Αναφέρουμε τα χαρακτηριστικά του χώρου και καταλήγουμε στα γενικότερα προβλήματα που αντιμετωπίζει ο χώρος. Η συζήτηση των προβλημάτων θα πρέπει να προϊδεάζει τον αναγνώστη για το τι θα προσπαθήσει να αντιμετωπίσει η διπλωματική, χωρίς ακόμα να αναφερόμαστε συγκεκριμένα στο αντικείμενο της διπλωματικής.]

Η ρομποτική αποτελεί ένα από τα σημαντικότερα πεδία της σύγχρονης μηχανικής, καθώς συνδυάζει γνώσεις από την ηλεκτρολογία, τη μηχανολογία, την επιστήμη των υπολογιστών και τα συστήματα αυτομάτου ελέγχου. Η εξέλιξή της έχει συμβάλει στην ανάπτυξη συστημάτων που μπορούν να εκτελούν επαναλαμβανόμενες, απαιτητικές ή σύνθετες εργασίες με περιορισμένη ανθρώπινη παρέμβαση. Οι εφαρμογές της εκτείνονται από τη βιομηχανική παραγωγή και τη συναρμολόγηση έως την ιατρική, την εφοδιαστική αλυσίδα, την έρευνα και την εκπαίδευση.

Ιδιαίτερο ενδιαφέρον παρουσιάζουν οι ρομποτικοί βραχίονες, οι οποίοι αποτελούν μηχανικά συστήματα σχεδιασμένα για την εκτέλεση κινήσεων και τον χειρισμό αντικειμένων στον τρισδιάστατο χώρο. Μέσω της κίνησης των αρθρώσεών τους, μπορούν να μεταβάλλουν τη θέση και τον προσανατολισμό του τελικού τους εργαλείου, επιτρέποντας την εκτέλεση εργασιών όπως η μεταφορά, η τοποθέτηση και η σύλληψη αντικειμένων. Οι δυνατότητες ενός ρομποτικού βραχίονα εξαρτώνται από τη μηχανική του διαμόρφωση, τον αριθμό των βαθμών ελευθερίας, τα χαρακτηριστικά των ενεργοποιητών, την ακρίβεια του συστήματος ελέγχου και τις μεθόδους που χρησιμοποιούνται για τον υπολογισμό και την εκτέλεση των κινήσεών του.

Παρά την πρόοδο στον σχεδιασμό και την κατασκευή ρομποτικών συστημάτων, η ανάπτυξη μιας ολοκληρωμένης λύσης που να συνδυάζει χαμηλό κόστος, επαρκή ακρίβεια, ευελιξία και δυνατότητα επέκτασης εξακολουθεί να παρουσιάζει σημαντικές τεχνικές προκλήσεις. Η κατασκευή ενός μηχανισμού ικανού να εκτελεί ελεγχόμενες κινήσεις αποτελεί μόνο ένα μέρος του συνολικού προβλήματος. Για να μπορέσει ένα ρομποτικό σύστημα να λειτουργήσει αυτόνομα, απαιτείται επίσης να αντιλαμβάνεται το περιβάλλον του, να επεξεργάζεται τις πληροφορίες που λαμβάνει από τους αισθητήρες του, να υπολογίζει τις κατάλληλες κινήσεις και να προσαρμόζει τη συμπεριφορά του ανάλογα με τις συνθήκες εκτέλεσης.

Στο πλαίσιο αυτό, η τεχνητή όραση διαδραματίζει καθοριστικό ρόλο στην ανάπτυξη αυτόνομων ρομποτικών εφαρμογών. Μέσω της επεξεργασίας εικόνων και δεδομένων βάθους, ένα ρομποτικό σύστημα μπορεί να αποκτήσει πληροφορίες σχετικά με τη γεωμετρία και τη χωρική διάταξη των αντικειμένων που βρίσκονται στο περιβάλλον του. Ωστόσο, η αναγνώριση ενός αντικειμένου δεν αρκεί από μόνη της για την επιτυχή σύλληψή του. Απαιτείται επιπλέον η εκτίμηση της θέσης και, ανάλογα με την εφαρμογή, του προσανατολισμού του στον τρισδιάστατο χώρο, ώστε να προσδιοριστεί μια κατάλληλη στάση προσέγγισης και σύλληψης.

Η αξιοποίηση των παραπάνω πληροφοριών προϋποθέτει τη συνεργασία επιμέρους υποσυστημάτων, όπως οι αισθητήρες, οι ενεργοποιητές, οι μονάδες υπολογισμού και το λογισμικό ελέγχου. Ειδικότερα, η εκτίμηση της θέσης ενός αντικειμένου από μια κάμερα πρέπει να συνδυάζεται με τη γνώση της κινηματικής του βραχίονα και με τους μετασχηματισμούς μεταξύ των διαφορετικών συστημάτων συντεταγμένων. Στη συνέχεια, πρέπει να υπολογίζεται μια εφικτή τροχιά, η οποία επιτρέπει στο τελικό εργαλείο να προσεγγίσει το αντικείμενο και να εκτελέσει τη σύλληψη, λαμβάνοντας υπόψη τους μηχανικούς περιορισμούς του συστήματος.

Μία ακόμη σημαντική πρόκληση είναι η ολοκλήρωση όλων αυτών των λειτουργιών σε μια ενιαία και επεκτάσιμη αρχιτεκτονική λογισμικού. Η ανάπτυξη ξεχωριστών προγραμμάτων για την ανάγνωση των αισθητήρων, τον έλεγχο των κινητήρων, την επεξεργασία των δεδομένων όρασης και τον σχεδιασμό κίνησης δεν εξασφαλίζει από μόνη της την ομαλή συνεργασία τους. Αντίθετα, απαιτείται ένας οργανωμένος τρόπος επικοινωνίας και συντονισμού των επιμέρους λειτουργιών, ώστε το σύστημα να μπορεί να εκτελεί σύνθετες εργασίες με συνεπή και ελεγχόμενο τρόπο.

Οι παραπάνω απαιτήσεις αναδεικνύουν την ανάγκη ανάπτυξης ολοκληρωμένων ρομποτικών συστημάτων στα οποία ο μηχανικός σχεδιασμός, τα ηλεκτρονικά, η αισθητηριακή ανάδραση, η τεχνητή όραση και ο σχεδιασμός κίνησης αντιμετωπίζονται ως αλληλένδετα μέρη του ίδιου προβλήματος. Η διερεύνηση αυτής της ολοκλήρωσης αποτελεί το γενικό πλαίσιο της παρούσας διπλωματικής εργασίας.

## 1.1 Αντικείμενο της διπλωματικής

[Εδώ αναφερόμαστε συγκεκριμένα στο τί θα κάνει η διπλωματική. Αναφέρουμε λεπτομερώς α) τα προβλήματα που θα λύσει (και που ήδη έχουν περιγραφεί γενικά στην προηγούμενη ενότητα), και β) πώς σκοπεύει να τα λύσει. Είναι σημαντικό κάποιος που θα διαβάσει την ενότητα αυτή να καταλάβει σε σημαντικό βαθμό τον σκοπό της διπλωματικής σας και τις τεχνικές δυσκολίες της, χωρίς να είναι αναγκαίο να δει όλα τα άλλα κεφάλαια. Η ενότητα αυτή θέλει πολύ προσοχή και καλύτερα να τη γράψετε αφού έχετε γράψει όλα τα υπόλοιπα κεφάλαια.]

Αντικείμενο της παρούσας διπλωματικής εργασίας είναι ο σχεδιασμός και η ανάπτυξη ενός ολοκληρωμένου ρομποτικού συστήματος έξι βαθμών ελευθερίας (6-DOF), με κύριο στόχο τη διερεύνηση μεθόδων τεχνητής όρασης και αυτόνομου χειρισμού αντικειμένων. Η εργασία περιλαμβάνει τη μηχανική σχεδίαση και κατασκευή του ρομποτικού βραχίονα, την ανάπτυξη της ηλεκτρονικής υποδομής του, καθώς και την υλοποίηση λογισμικού που θα επιτρέπει τη συνεργασία των επιμέρους υποσυστημάτων.

Ο ρομποτικός βραχίονας σχεδιάζεται ως μια οικονομική, αρθρωτή και επεκτάσιμη πειραματική πλατφόρμα, με αξιοποίηση τεχνολογιών τρισδιάστατης εκτύπωσης και εμπορικά διαθέσιμων ηλεκτρονικών εξαρτημάτων. Η μηχανική του διαμόρφωση αποσκοπεί στην επίτευξη κίνησης στον τρισδιάστατο χώρο, παρέχοντας τη δυνατότητα ελέγχου τόσο της θέσης όσο και του προσανατολισμού του τελικού εργαλείου. Παράλληλα, η ενσωμάτωση αισθητήρων θέσης στις αρθρώσεις αποσκοπεί στην παροχή πληροφοριών ανάδρασης, οι οποίες μπορούν να αξιοποιηθούν για τη βελτίωση του ελέγχου της κίνησης.

Ιδιαίτερη έμφαση δίνεται στην ανάπτυξη του λογισμικού και στην αξιοποίηση τεχνικών τεχνητής όρασης. Για τον σκοπό αυτό, προβλέπεται η ενσωμάτωση κάμερας RGB-D, η οποία παρέχει πληροφορίες τόσο για την οπτική εμφάνιση των αντικειμένων όσο και για την απόστασή τους από την κάμερα. Μέσω της επεξεργασίας αυτών των δεδομένων επιδιώκεται η αναγνώριση αντικειμένων και η εκτίμηση της χωρικής τους κατάστασης, συμπεριλαμβανομένης της θέσης και του προσανατολισμού τους, όταν αυτό είναι εφικτό με τις επιλεγμένες μεθόδους.

Η εκτίμηση της χωρικής κατάστασης των αντικειμένων αποτελεί βασικό στάδιο για την εκτέλεση εργασιών αυτόνομου χειρισμού. Οι πληροφορίες που προκύπτουν από την κάμερα πρέπει να μετασχηματίζονται στο σύστημα συντεταγμένων της βάσης του ρομποτικού βραχίονα, ώστε να μπορούν να χρησιμοποιηθούν για τον υπολογισμό κατάλληλων κινήσεων. Στη συνέχεια, επιδιώκεται ο προσδιορισμός κατάλληλης στάσης σύλληψης και ο σχεδιασμός τροχιάς που επιτρέπει στο τελικό εργαλείο να προσεγγίσει το επιθυμητό σημείο, λαμβάνοντας υπόψη τους κινηματικούς περιορισμούς του μηχανισμού.

Για την οργάνωση και τον συντονισμό των παραπάνω λειτουργιών προβλέπεται η αξιοποίηση του Robot Operating System 2 (ROS 2), ενός πλαισίου λογισμικού που υποστηρίζει την ανάπτυξη αρθρωτών ρομποτικών εφαρμογών. Μέσω της κατάλληλης αρχιτεκτονικής λογισμικού επιδιώκεται η επικοινωνία μεταξύ των μονάδων αντίληψης, υπολογισμού κίνησης και ελέγχου των αρθρώσεων, με τρόπο που να διευκολύνει τη συντήρηση, τη δοκιμή και τη μελλοντική επέκταση του συστήματος.

Τελικός στόχος της εργασίας είναι η ανάπτυξη και πειραματική αξιολόγηση μιας διαδικασίας κατά την οποία ο ρομποτικός βραχίονας θα μπορεί να εντοπίζει αντικείμενα στο περιβάλλον του, να εκτιμά τη χωρική τους κατάσταση και να εκτελεί τις απαραίτητες κινήσεις για τη σύλληψή τους με όσο το δυνατόν μικρότερη ανθρώπινη παρέμβαση. Ιδιαίτερο ενδιαφέρον παρουσιάζει η διερεύνηση της δυνατότητας εκτέλεσης σύλληψης για διαφορετικές θέσεις και προσανατολισμούς αντικειμένων, καθώς και η αξιολόγηση των περιορισμών που προκύπτουν από την ακρίβεια των αισθητήρων, τη μηχανική κατασκευή, την εκτίμηση της στάσης και τον σχεδιασμό κίνησης.

Η αξιολόγηση θα βασιστεί σε κατάλληλα πειράματα, τα οποία θα επιτρέψουν την εξέταση παραμέτρων όπως η ακρίβεια εκτίμησης της θέσης, η επιτυχία της σύλληψης, η επαναληψιμότητα των κινήσεων και η αξιοπιστία της συνολικής διαδικασίας. Με αυτόν τον τρόπο, η εργασία αποσκοπεί όχι μόνο στην κατασκευή ενός λειτουργικού ρομποτικού συστήματος, αλλά και στη μελέτη της πρακτικής εφαρμογής και της συνεργασίας των τεχνολογιών που απαιτούνται για τον αυτόνομο ρομποτικό χειρισμό αντικειμένων.

### 1.1.1 Συνεισφορά

[Εδώ παραθέτουμε αριθμητικά συγκεκριμένες ενέργειες/λύσεις/μεθοδολογίες που παρουσιάζει η διπλωματική και λύνουν τα προβλήματα που υποσχεθήκαμε στην προηγούμενη ενότητα ότι θα λύσει η διπλωματική. Συνήθως η υποενότητα αυτή έχει την παρακάτω μορφή:

1. Μελετήθηκαν συστήματα κ.λπ..
2. Υλοποιήθηκαν τρεις αλγόριθμοι υπολογισμού κ.λπ..
3. Αξιολογήθηκε η επίδοση των αλγορίθμων και βρέθηκε ότι κ.λπ..
4. Ενσωματώθηκαν οι αλγόριθμοι σε πρότυπο σύστημα κ.λπ..
5. …]

Η συνεισφορά της παρούσας διπλωματικής εργασίας αφορά τον σχεδιασμό, την ανάπτυξη και τη διερεύνηση μιας ολοκληρωμένης πειραματικής πλατφόρμας για αυτόνομο ρομποτικό χειρισμό αντικειμένων. Ειδικότερα, οι επιδιωκόμενες συνεισφορές της εργασίας συνοψίζονται στα ακόλουθα:

1. Μηχανικός σχεδιασμός και κατασκευή: Σχεδιασμός και κατασκευή ενός αρθρωτού ρομποτικού βραχίονα έξι βαθμών ελευθερίας, με αξιοποίηση τεχνολογιών τρισδιάστατης εκτύπωσης και οικονομικά προσιτών εξαρτημάτων.
2. Ηλεκτρονική ολοκλήρωση και αισθητηριακή ανάδραση: Ανάπτυξη της ηλεκτρονικής υποδομής για τον έλεγχο των ενεργοποιητών και την ενσωμάτωση αισθητήρων, με στόχο την απόκτηση πληροφοριών σχετικά με την κατάσταση των αρθρώσεων και τη λειτουργία της αρπάγης.
3. Ανάπτυξη λογισμικού ρομποτικού ελέγχου: Σχεδιασμός αρθρωτής αρχιτεκτονικής λογισμικού με χρήση του ROS 2, για την επικοινωνία και τον συντονισμό των επιμέρους λειτουργιών του συστήματος.
4. Εφαρμογή τεχνικών τεχνητής όρασης: Διερεύνηση και υλοποίηση μεθόδων αξιοποίησης δεδομένων εικόνας και βάθους για την αναγνώριση αντικειμένων και την εκτίμηση της θέσης και του προσανατολισμού τους στον τρισδιάστατο χώρο.
5. Ολοκλήρωση αντίληψης και κίνησης: Ανάπτυξη διαδικασίας που συνδέει την εκτίμηση της κατάστασης των αντικειμένων με τον υπολογισμό κατάλληλων στάσεων σύλληψης και τον σχεδιασμό κίνησης του ρομποτικού βραχίονα.
6. Πειραματική αξιολόγηση: Αξιολόγηση της λειτουργίας του συστήματος μέσω δοκιμών, με κριτήρια που περιλαμβάνουν την ακρίβεια, την επαναληψιμότητα και την επιτυχία εκτέλεσης εργασιών σύλληψης.

Οι παραπάνω συνεισφορές θα οριστικοποιηθούν με βάση τις τελικές επιλογές σχεδιασμού, τις μεθόδους που θα υλοποιηθούν και τα αποτελέσματα που θα προκύψουν από την πειραματική αξιολόγηση.

## 1.2 Οργάνωση του τόμου

Εδώ περιγράφουμε τα κεφάλαια της διπλωματικής: μία πρόταση για το τί θα έχει κάθε κεφάλαιο. Συνήθως η ενότητα αυτή έχει την παρακάτω μορφή:

Στο Σφάλμα! Το αρχείο προέλευσης της αναφοράς δεν βρέθηκε.γίνεται μια εισαγωγή στα συστήματα ηλεκτρικής ενέργειας και παρουσιάζονται οι λόγοι που οδηγούν στην ραγδαία ανάπτυξη της κατανεμημένης παραγωγής.

Στο Κεφάλαιο 3 αναφέρονται οι μονάδες παραγωγής και αποθήκευσης ηλεκτρικής ενέργειας που θα μπορούσαν να χρησιμοποιηθούν σε ένα μικροδίκτυο δίνοντας περισσότερη έμφαση στις πιο αποδοτικές (φωτοβολταϊκά, ανεμογεννήτριες, μπαταρίες).

Στο Κεφάλαιο 4 παρουσιάζεται η αρχιτεκτονική ελέγχου της τάσης και συχνότητας που απαιτείται για την ομαλή λειτουργία κάθε μικροδικτύου. Επίσης γίνεται διάκριση του ελέγχου σε κεντρικό (MGCC) και αποκεντρωμένο (ευφυείς πράκτορες).

Τέλος, στο Κεφάλαιο 6 παρουσιάζονται συγκεντρωτικά τα κυριότερα αποτελέσματα της παρούσας εργασίας, οι λόγοι πρωτοτυπίας της έρευνας και της προσέγγισης, η συμβολή της στη διερεύνηση του θέματος, οι δυσκολίες που υπήρξαν στην ανάπτυξή του και πιθανές προτάσεις για περαιτέρω διερεύνηση του θέματος στο μέλλον.

## 1.3 1.2 Οργάνωση του τόμου

Η παρούσα διπλωματική εργασία οργανώνεται σε οκτώ κεφάλαια, τα οποία παρουσιάζουν διαδοχικά το θεωρητικό υπόβαθρο, τον σχεδιασμό και την υλοποίηση του ρομποτικού συστήματος, καθώς και την αξιολόγηση των επιμέρους λειτουργιών του.

Στο Κεφάλαιο 1 παρουσιάζεται το γενικό πλαίσιο της εργασίας, προσδιορίζεται το αντικείμενό της, περιγράφονται οι επιδιωκόμενες συνεισφορές και συνοψίζεται η δομή του τόμου.

Στο Κεφάλαιο 2 παρουσιάζεται το θεωρητικό υπόβαθρο που απαιτείται για την κατανόηση του συστήματος. Εξετάζονται βασικές έννοιες της ρομποτικής, όπως οι βαθμοί ελευθερίας, η κινηματική των ρομποτικών βραχιόνων, ο έλεγχος κίνησης και οι βασικές αρχές της τεχνητής όρασης και της τρισδιάστατης αντίληψης.

Στο Κεφάλαιο 3 αναλύεται ο μηχανικός σχεδιασμός του ρομποτικού βραχίονα. Παρουσιάζονται η κινηματική διαμόρφωση, ο σχεδιασμός των αρθρώσεων και των μηχανισμών μετάδοσης κίνησης, η επιλογή των υλικών και των εξαρτημάτων, καθώς και οι διαδικασίες κατασκευής και συναρμολόγησης.

Στο Κεφάλαιο 4 περιγράφεται η ηλεκτρονική σχεδίαση και η ενσωμάτωση των επιμέρους εξαρτημάτων. Αναλύονται η αρχιτεκτονική τροφοδοσίας, ο έλεγχος των ενεργοποιητών, η διασύνδεση των αισθητήρων και οι επικοινωνιακές διεπαφές που χρησιμοποιούνται για τη συνεργασία των ηλεκτρονικών υποσυστημάτων.

Στο Κεφάλαιο 5 παρουσιάζεται η ανάπτυξη του λογισμικού και της αρχιτεκτονικής ελέγχου με χρήση του ROS 2. Περιγράφονται η οργάνωση των λειτουργιών σε επιμέρους μονάδες λογισμικού, η επικοινωνία μεταξύ τους, η ανάγνωση των αισθητήρων, ο έλεγχος των αρθρώσεων και οι μέθοδοι υπολογισμού και εκτέλεσης της κίνησης του βραχίονα.

Στο Κεφάλαιο 6 εξετάζεται το σύστημα τεχνητής όρασης και τρισδιάστατης αντίληψης. Παρουσιάζονται η αξιοποίηση της κάμερας βάθους, η επεξεργασία των δεδομένων εικόνας, η αναγνώριση αντικειμένων και οι μέθοδοι εκτίμησης της θέσης και του προσανατολισμού τους στον χώρο.

Στο Κεφάλαιο 7 παρουσιάζεται η ολοκλήρωση των επιμέρους υποσυστημάτων σε μια ενιαία διαδικασία αυτόνομου χειρισμού αντικειμένων. Αναλύεται η σύνδεση της οπτικής αντίληψης με την κινηματική του βραχίονα, ο προσδιορισμός κατάλληλων στάσεων σύλληψης, ο σχεδιασμός της κίνησης και η εκτέλεση των αντίστοιχων εργασιών.

Τέλος, στο Κεφάλαιο 8 παρουσιάζονται η πειραματική αξιολόγηση του συνολικού συστήματος, τα αποτελέσματα που προκύπτουν από τις δοκιμές, οι περιορισμοί της υλοποίησης και τα βασικά συμπεράσματα της εργασίας. Επιπλέον, προτείνονται κατευθύνσεις για μελλοντική βελτίωση και επέκταση του ρομποτικού συστήματος.

# Κεφάλαιο 2 Τίτλος κεφαλαίου

## 2.1 Εισαγωγή

Τα δυναμικά προγράμματα τιμολόγησης παρουσιάζουν όλο και μεγαλύτερο ενδιαφέρον από δημόσιες κρατικές επιτροπές και επιχειρήσεις κοινής ωφέλειας ενώ οι βιομηχανίες συνεχίζουν το σχεδιασμό για τη δημιουργία των έξυπνων δικτύων. Αυτό συμβαίνει γιατί οι επιχειρήσεις κοινής ωφέλειας ανά τον κόσμο δεν επιτρέπουν την αμφίδρομη σχέση με τον καταναλωτή ώστε να μπορεί να είναι ο ίδιος ρυθμιστής της κατανάλωσης ενέργειας ανάλογα με τις ανάγκες του.

Μελέτες διαφόρων ερευνητικών ομάδων έδειξαν ότι το κόστος δεν κατανέμεται ισομερώς. Οι καταναλωτές οι οποίοι βρίσκονται υπό καθεστώς <<επίπεδης>> τιμολόγησης κατανάλωσαν περισσότερη ενέργεια κατά τις ώρες αιχμής. Με τα δυναμικά προγράμματα τιμολόγησης υπάρχει η δυνατότητα να επιλυθεί αυτό το πρόβλημα με την ενίσχυση της οικονομικής αποδοτικότητας έχοντας σαν αποτέλεσμα την μείωση της ζήτησης σε ώρες αιχμής.

## 2.2 Ορισμός Δυναμικής Τιμολόγησης

Με τον όρο Δυναμική Τιμολόγηση (dynamic pricing) εννοούμε την δυνατότητα που δίνει ο πάροχος στον πελάτη του, να τιμολογείται με μία τιμή που διαφέρει από ώρα σε ώρα, ενώ για κάθε 24ωρο οι τιμές ανακοινώνονται, οι τιμές ανακοινώνονται από μια μέρα έως και λίγες ώρες πριν (Σχήμα 2.1). Για τον υπολογισμό αυτής λαμβάνεται υπόψη η τιμή στη χονδρική αγορά, το κόστος για την χρήση των δικτύων, το κέρδος του παρόχου και άλλες χρεώσεις. Με αυτό τον τρόπο οι καταναλωτές εκτίθενται στο ρίσκο της τιμής που διαμορφώνεται ανά ώρα αλλά γλιτώνουν τη χρέωση που θα τους επέβαλε ο πάροχός τους, εάν αναλάμβανε εκείνος να διαχειριστεί το ρίσκο αυτό. Με την μετάβαση σε δυναμικά τιμολόγια αναμένεται ότι κάποιοι καταναλωτές θα ωφεληθούν ενώ κάποιοι άλλοι θα χάσουν. Εκείνοι οι οποίοι θα χάσουν είναι αυτοί που πραγματοποιούν τη μεγαλύτερη κατανάλωση ενέργειας σε ώρες αιχμής. Αντίθετα, εκείνοι οι οποίοι θα κερδίσουν είναι αυτοί που παρουσιάζουν τη λεγόμενη "επίπεδη" κατανάλωση δηλαδή δεν καταναλώνουν μεγάλη ποσότητα ενέργειας σε ώρες αιχμής. Υπάρχουν και αυτοί οι οποίοι δεν έχουν ούτε όφελος ούτε ζημία γιατί το προφίλ κατανάλωσης ταυτίζεται με τη καμπύλη φορτίου (και κόστους) του συστήματος (υποθέτουμε ανασχεδιασμό τιμολογίων ουδέτερο ως προς τα συνολικά έσοδα του προμηθευτή) [1].

## 2.3 Μεταβαλλόμενη τιμή της ενέργειας

Επειδή υπάρχει μεγάλη αδυναμία των πελατών της λιανικής αγοράς και των φορτίων τους να συμμετέχουν στις αγορές, οι σύγχρονες ηλεκτρικής ενέργειας δεν είναι αρκετά αποτελεσματικές όσον αφορά τον ανταγωνισμό. Η τιμή της ηλεκτρικής ενέργειας στην αγορά μεταβάλλεται από ώρα σε ώρα συχνά ακόμα και κατά 30-50% μέσα σε μια μέρα. Οι λόγοι για τους οποίους η τιμή της ηλεκτρικής ενέργειας παρουσιάζει αυτή τη συμπεριφορά είναι οι εξής [2],[3]:

1. Το κόστος της ηλεκτρικής ενέργειας διαφέρει πολλές φορές ανάλογα με την τεχνολογία που χρησιμοποιείται.(Για παράδειγμα οι υδροηλεκτρικές μονάδες και εκείνες που χρησιμοποιούν την πυρηνική ενέργεια έχουν κόστος κάτω των 10$/ΜWh, ενώ το κόστος για μια συμβατική μονάδα ορυκτών καυσίμων ανέρχεται περίπου στα 100$/MWh).
2. Το φορτίο του συστήματος μεταβάλλεται από ώρα σε ώρα.
3. Η ηλεκτρική ενέργεια δεν μπορεί να αποθηκευτεί με οικονομικό τρόπο γι αυτό το λόγο πρέπει να καταναλώνεται τη στιγμή που παράγεται.
4. Πολύ συχνά προκαλούνται ανισορροπίες μεταξύ της προσφοράς και της ζήτησης εξαιτίας συμβάντων όπως ξαφνική απώλεια μονάδων, του δικτύου ή ακραία φαινόμενα.
5. Η λειτουργία των μονάδων διέπεται από τεχνικούς περιορισμούς. Κάποιες φορές όταν το φορτίο είναι πολύ χαμηλό, η τιμή στην αγορά μηδενίζεται ή γίνεται ακόμα και αρνητική. Αυτό συμβαίνει διότι είναι οικονομικότερο να μείνει μια μονάδα σε λειτουργία παρά να κλείσει και να επαναλειτουργήσει αργότερα.

Επειδή υπάρχει μεγάλη αδυναμία των πελατών της λιανικής αγοράς και των φορτίων τους να συμμετέχουν στις αγορές, οι σύγχρονες ηλεκτρικής ενέργειας δεν είναι αρκετά αποτελεσματικές όσον αφορά τον ανταγωνισμό. Η τιμή της ηλεκτρικής ενέργειας στην αγορά μεταβάλλεται από ώρα σε ώρα συχνά ακόμα και κατά 30-50% μέσα σε μια μέρα. Επειδή υπάρχει μεγάλη αδυναμία των πελατών της λιανικής αγοράς και των φορτίων τους να συμμετέχουν στις αγορές, οι σύγχρονες ηλεκτρικής ενέργειας δεν είναι αρκετά αποτελεσματικές όσον αφορά τον ανταγωνισμό. Η τιμή της ηλεκτρικής ενέργειας στην αγορά μεταβάλλεται από ώρα σε ώρα συχνά ακόμα και κατά 30-50% μέσα σε μια μέρα (Σχήμα 2.1) Στο που παρουσιάζεται η διακύμανση τις τιμής της ηλεκτρικής ενέργειας σε ένα σύστημα που διαχειρίζεται η εταιρεία PJM interconnection για λογαριασμό κάποιων πολιτειών των ΗΠΑ για μία βδομάδα του Ιουλίου ενώ o περιλαμβάνει τις τιμές της ηλεκτρικής ενέργειας ημερησίως (Πίνακας 2.1) [1],[3],[4],[5].

Σχήμα 2.1: Διακύμανση της τιμής της ηλεκτρικής ενέργειας

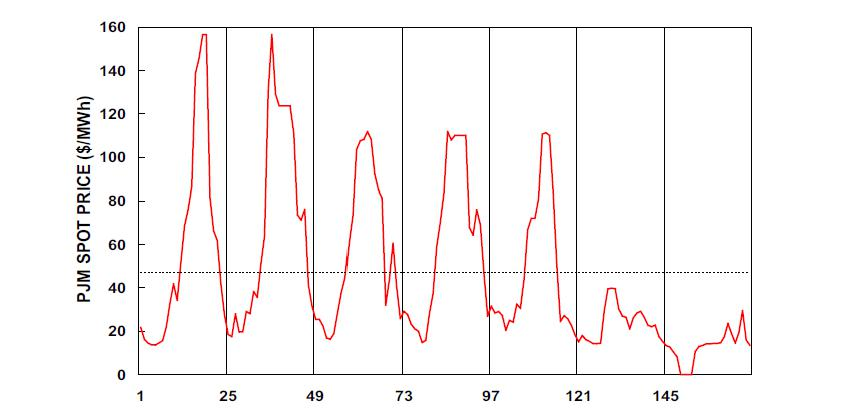
[picture p3: figure]

Πίνακας 2.1: Ημερήσιες τιμές ηλεκτρικής ενέργειας σε KW της εταιρείας PJM

Πελάτης | Δευτέρα | Τρίτη | Τετάρτη | Πέμπτη | Παρασκευή | Σάββατο | Κυριακή
1 | 23 | 3 | 23 | 7 | 3 | 56 | 7
2 | 25 | 6 | 5 | 9 | 5 | 34 | 45
3 | 12 | 26 | 7 | 12 | 8 | 5 | 34

### 2.3.1 Τίτλος Υπο-ενότητας

### 2.3.2 Τίτλος Υπο-ενότητας

### 2.3.3 Τίτλος Υπο-ενότητας

Κ.ΛΠ.

# Κεφάλαιο 3 Τίτλος κεφαλαίου

## 3.1 This us test

………………………………………

## 3.2 Τίτλος ενότητας

Άν θέλουμε να προσσεγγίσουμε περισσότερο τη μέθοδο του Εικονικού προπολογισμού θα δούμε ότι ο VB είναι στην ουσία το εσωτερικό γινόμενο μεταξύ μορφοποιημένου φορτίου και προβλεπόμενης τιμής, το άθροισμα δηλαδή από σημείο σε σημείο του πολλαπλασιασμού μεταξύ του προβλεπόμενου φορτίου και της προβλεπόμενης τιμή. Άν θέλουμε να προσσεγγίσουμε περισσότερο τη μέθοδο του Εικονικού προπολογισμού θα δούμε ότι ο VB είναι στην ουσία το εσωτερικό γινόμενο μεταξύ μορφοποιημένου φορτίου και προβλεπόμενης τιμής, το άθροισμα δηλαδή από σημείο σε σημείο του πολλαπλασιασμού μεταξύ του προβλεπόμενου φορτίου και της προβλεπόμενης τιμή

??????????????????????????????????

# Κεφάλαιο 4 Τίτλος κεφαλαίου

## 4.1 Λειτουργία του Virtual Budget

Στο δίκτυο της ηλεκτρικής ενέργειας η διαθεσιμότητα της ισχύς είναι προγραμματισμένη ώστε να ικανοποιείται η μέγιστη ζήτηση. Οι τιμές της ηλεκτρικής ενέργειας ποικίλλουν δυναμικά και με σημαντική μεταβλητότητα, με τρόπο που οι τιμές έχουν ανέβει καθώς η απόσταση μεταξύ διαθέσιμης ισχύς και μέγιστης ζήτησης έχουν μειωθεί. Η τιμή της ηλεκτρικής ενέργειας μπορεί να είναι ένας σημαντικός παράγοντας στη μορφοποίηση του φορτίου (Εικόνα 4.1). Έτσι η πρόβλεψη του φορτίου και πιο πρόσφατα η πρόβλεψη των τιμών είναι βασικές τεχνολογίες για τους συμμετέχοντες στην αγορά, καθώς βελτιστοποιεί τις αποφάσεις τους σχετικά με την απόκριση στη ζήτηση και συνεπώς μεγιστοποιεί τα κέρδη τους [2],[4].

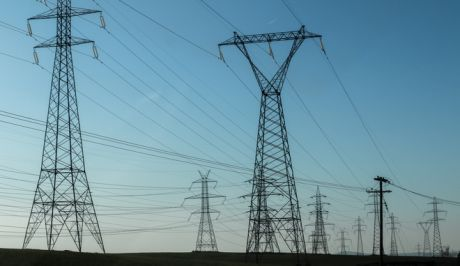
[picture p4: figure]
ΔΕΗ | News 24/7

Εικόνα 4.1: Γραμμές μεταφοράς

Για το λόγο αυτό έχει αναπτυχθεί μια προσέγγιση που ονομάζεται εικονικός προϋπολογισμός (Virtual Budget). H μέθοδος αυτή ταιριάζει την πρόβλεψη του φορτίου και την πρόβλεψη της τιμής και έτσι επιτρέπει μια αυτοματοποιημένη μορφοποίηση στην κατανάλωση της ηλεκτρικής ενέργειας του χρήστη. Αυτό το επιτυγχάνει μέσω έξυπνων προγραμματιστικών αλγορίθμων.

Πιο συγκεκριμένα η μέθοδος του εικονικού προϋπολογισμού ενσωματώνει το φορτίο και την τιμή της πρόβλεψης με τη δυναμική βελτιστοποίηση προκειμένου να τροποποιήσει το αρχικό σχέδιο του φορτίου [1],[5],[6],[7]. Το αναμενόμενο φορτίο ενσωματώνεται στο προγραμματισμένο φορτίο μέσω δύο παραμέτρων. Η μία παράμετρος είναι ουσιαστικά για το συνολικό φορτίο που ο χρήστης είναι πρόθυμος να ακυρώσει και η άλλη για την ομοιότητα του βελτιστοποιημένου φορτίου με την αναμενόμενη τιμή. Το φορτίο βελτιστοποιείται με βάση έναν προϋπολογισμό κατανάλωσης που ορίζεται από τον χρήστη με μια τρίτη παράμετρο.

Το Virtual Budget (Σχήμα 4.1) ενσωματώνεται σε έξυπνους μετρητές και στοχεύει κυρίως στην ελαχιστοποίηση της ανθρώπινης παρέμβασης στην αγορά ηλεκτρικής ενέργειας. Αυτόν το στόχο τον επιτυγχάνει καθώς επιτρέπει στους καταναλωτές να εισάγουν τρεις μεταβλητές που εκφράζουν τη στρατηγική της συναλλαγής και τη ζώνη της οικονομικής τους άνεσης και ακολουθεί έναν ανθρώπινο τρόπο σκέψης για να φτάσει όσο το δυνατόν πιο κοντά στο μέγιστο κόστος που ο καταναλωτής έχει εισάγει στην είσοδό του.

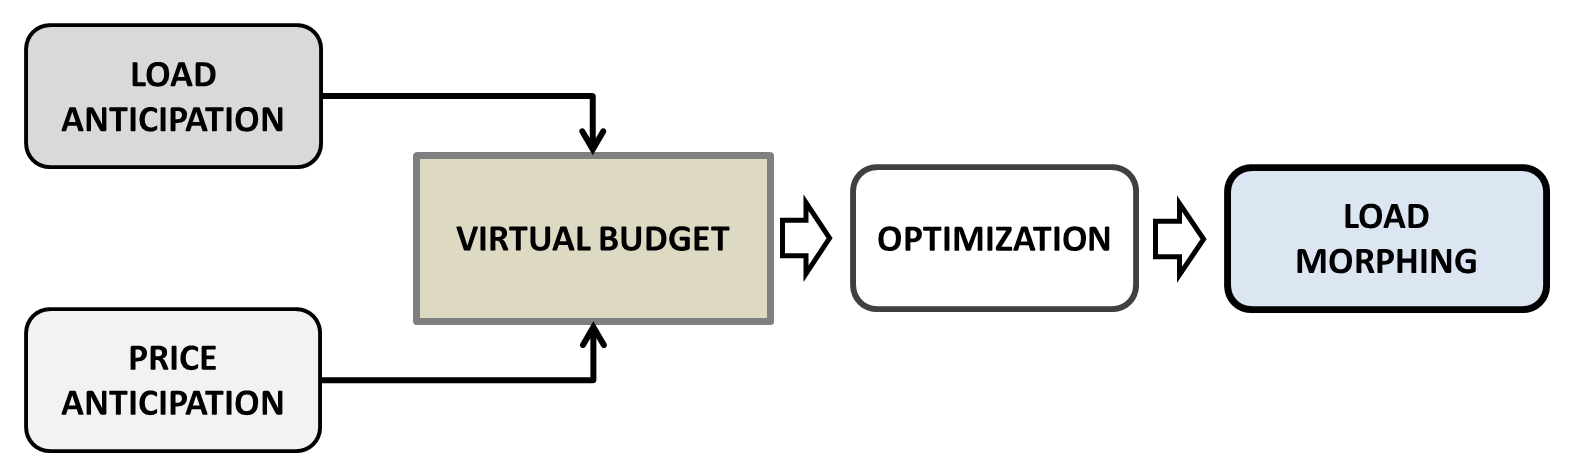
[picture p5: figure]

Σχήμα 4.1:-Απεικόνιση λειτουργίας του Virtual Budget [7]

### 4.1.1 Πρόβλεψη Φορτίου

Έχει εντοπιστεί ότι υπάρχουν τέσσερις τύποι πρόβλεψης φορτίου σε σχέση με τον ορίζοντα πρόβλεψης του χρόνου, δηλαδή πολύ-βραχυπρόθεσμα, βραχυπρόθεσμα, μεσοπρόθεσμα και μακροπρόθεσμα πρόβλεψη φορτίου. Σε ένα δίκτυο ηλεκτρικής ενέργειας οι συμμετέχοντες σε αυτό έχουν τη δυνατότητα να προβλέψουν το φορτίο για ένα συγκεκριμένο χρονικό διάστημα και συνεπώς να σχεδιάσουν μια συγκεκριμένη στρατηγική αγοράς ή πώλησης της ηλεκτρικής ενέργειας. Ο συμμετέχον σε ένα δίκτυο καλείται να προβλέψει την κατανάλωση του φορτίου του όταν ανακοινωθεί η λιανική τιμή αγοράς της ηλεκτρικής ενέργειας. Μορφοποίηση του αρχικού φορτίου θα γίνει ( αναλόγως περιστολή η μετατόπισή του) εάν η ανακοινωθείσα τιμή της ηλεκτρικής ενέργειας είναι έξω από τη ζώνη άνεσης που ο ίδιος ο συμμετέχον έχει ορίσει.

Η μέθοδος του εικονικού προϋπολογισμού είναι εφαρμόσιμη σε οποιοδήποτε μήκος ορίζοντα πρόβλεψης(πολύ-βραχυπρόθεσμα, βραχυπρόθεσμα, μεσοπρόθεσμα, μακροπρόθεσμα). Εδώ, θα χρησιμοποιηθεί περισσότερο η βραχυπρόθεσμη πρόβλεψη, καθώς οι τιμές ανακοινώνονται κάθε μία ώρα. Η έξοδος της μονάδας πρόβλεψης του φορτίου είναι ουσιαστικά η αναμενόμενη κατανάλωση ηλεκτρικής ενέργειας για την ώρα i. Άρα το συνολικό ποσό των αναμενόμενων κατά τη διάρκεια της μέρας είναι η άθροιση

TL=∑_(i=1)^I AL_i .

### 4.1.2 Πρόβλεψη της τιμής

Σε ένα δίκτυο ηλεκτρικής ενέργειας είναι ιδιαίτερα σημαντικό οι συμμετέχοντες σε αυτό να μπορούν να προβλέψουν εκτός από το φορτίο που αναφέραμε προηγουμένως και την τιμή. Χρησιμοποιώντας την πρόβλεψη της τιμής οι συμμετέχοντες μπορούν να ελαχιστοποιήσουν περισσότερο τα έξοδά τους στην αγορά της ηλεκτρικής ενέργειας. Η πρόβλεψη των τιμών της ηλεκτρικής ενέργειας παρέχει είκοσι τέσσερις τιμές, οι οποίες εκφράζονται ως APi, i = 1,. .., 24, με το APi να αντιπροσωπεύει την αναμενόμενη τιμή ηλεκτρικής ενέργειας την ώρα i της ημέρας. Από την άλλη, η ανακοίνωση της τιμής του ηλεκτρικού ρεύματος γίνεται στην αρχή και η τιμή παραμένει σταθερή για την επόμενη ώρα άρα συνολικά σε όλη την ημέρα υπάρχουν 24 ανακοινώσεις τιμών (Πίνακας 4.1).

Πίνακας 4.1: Τιμές ηλεκτρικής ενέργειας σε KW

Πελάτης | Δευτέρα | Τρίτη | Τετάρτη | Πέμπτη | Παρασκευή | Σάββατο | Κυριακή
1 | 23 | 3 | 23 | 7 | 3 | 56 | 7
2 | 25 | 6 | 5 | 9 | 5 | 34 | 45
3 | 12 | 26 | 7 | 12 | 8 | 5 | 34

## 4.2 Αναλυτική Προσέγγιση της Μεθόδου (VB)

Άν θέλουμε να προσσεγγίσουμε περισσότερο τη μέθοδο του Εικονικού προπολογισμού θα δούμε ότι ο VB είναι στην ουσία το εσωτερικό γινόμενο μεταξύ μορφοποιημένου φορτίου και προβλεπόμενης τιμής, το άθροισμα δηλαδή από σημείο σε σημείο του πολλαπλασιασμού μεταξύ του προβλεπόμενου φορτίου και της προβλεπόμενης τιμής.

Δηλαδή: AL_i =NR_i +AE_i .

Στη παραπάνω τώρα σχέση το προβλεπόμενο φορτίο μπορεί να αναλυθεί σε δύο συνιστώσες σε μια ανελαστική συνιστώσα NR_i και σε μια ελαστική συνιστώσα AE_i . Αξίζει να σημειωθεί ότι το ελαστικό τμήμα του φορτίου είναι δυνατόν να επαναπρογραμματιστεί με σκοπό τη μείωση του λογαριασμού του χρήστη. Αντίθετα, το ανελαστικό τμήμα αναφέρεται στην ελάχιστη υποχρεωτική κατανάλωση η οποία δεν μπορεί να ακυρωθεί ή να μεταβληθεί.

Η συνολική ποσότητα του ελαστικού φορτίου δίνεται από τη σχέση:

TE=∑_(i=1)^I AE_i =∑_(i=1)^I (AL_i -NR_i ).

Η ποσότητα E_i εισάγεται για να δεξει την ελαστική ποσότητα του φορτίου που έχει προγραμματιστεί.

Έιναι σημαντικό να τονιστεί οτι δύο είναι οι στόχοι της βελτιστοποίησης του ελαστικού φορτίου:

1. Ένα μεγάλο μέρος του ελαστικού φορτίου είναι προγραμματισμένο
2. Το βελτιστοποιημένο ελαστικό φορτίο διατηρεί την κατανομή του προβλεπόμενου ελαστικού φορτίου κατα τη διάρκεια του χρόνου.

Ειδικά για την επίτευξη του δεύτερου στόχου η σχέση που συνδέει τις παραμέτρους {AE_i }_(i=1)^I και {E_i }_(i=1)^I είναι η εξής ρ=(∑_(i=1)^I AE_i ⋅E_i)/(√(∑_(i=1)^I AE_i^2)⋅√(∑_(i=1)^I E_i^2))

Στη μέθοδο του εικονικού προυπολογισμού εισάγονται δύο νέες παράμετροι η β η οποία ορίζει το ποσό του φορτίου που θα ακυρωθεί και η γ η οποία χαρακτηρίζει την ομοιότητα του προγραμματισμένου φορτίου με το αναμενόμενο φορτίο, και με αυτό τον τρόπο επηρεάζει το ποσοστό του φορτίου που μπορεί να μετατοπιστεί……………………….

Ο VB επιβάλλει ένα ανώτατο όριο U_i για το συνολικό φορτίο σε κάθε θυρίδα χρόνου NR_i +E_i ≤U_i .

Στο Σχήμα 4.2 παρουσιάζονται τα επίπεδα της μορφοποίησης του φορτίου με τη μέθοδο VB και χρήση των παραμέτρων β,γ

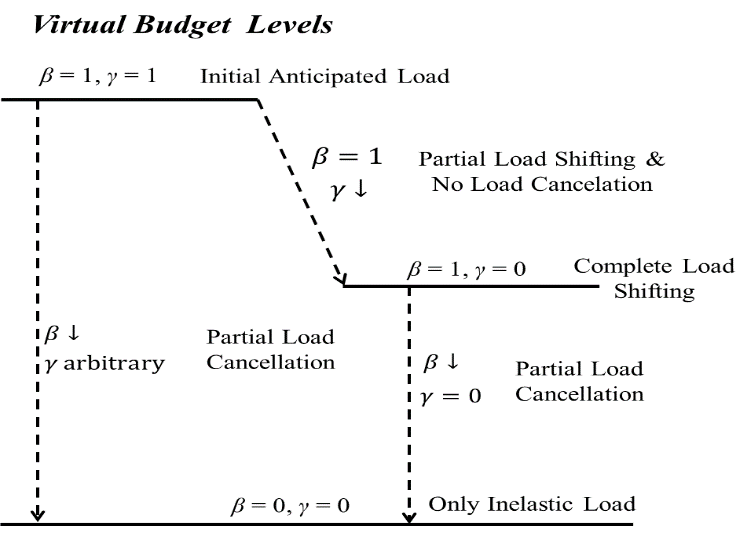
[picture p6: figure]
pic4

Σχήμα 4.2: Επίπεδα της μορφοποίησης του φορτίου με τη μέθοδο VB και χρήση των παραμέτρων β,γ

Είναι σημαντικό να τονίσουμε ότι στη μέθοδο του εικονικού προυπολογισμού ο χρήστης μαζί με τις μεταβλητές β και γ που εισάγει,είναι αυτός που θέτει ένα όριο της ημερήσιας κατανάλωσης που προτίθεται να έχει. Δηλαδή το πόσα χρήματα είναι διατεθειμένος να ξοδέψει την ημέρα. Αυτό το ανώτατο όριο τίθεται σαν περιορισμός στη μέθοδο του

## 4.3 Τίτλος ενότητας

Άν θέλουμε να προσσεγγίσουμε περισσότερο τη μέθοδο του Εικονικού προπολογισμού θα δούμε ότι ο VB είναι στην ουσία το εσωτερικό γινόμενο μεταξύ μορφοποιημένου φορτίου και προβλεπόμενης τιμής, το άθροισμα δηλαδή από σημείο σε σημείο του πολλαπλασιασμού μεταξύ του προβλεπόμενου φορτίου και της προβλεπόμενης τιμή. Άν θέλουμε να προσσεγγίσουμε περισσότερο τη μέθοδο του Εικονικού προπολογισμού θα δούμε ότι ο VB είναι στην ουσία το εσωτερικό γινόμενο μεταξύ μορφοποιημένου φορτίου και προβλεπόμενης τιμής, το άθροισμα δηλαδή από σημείο σε σημείο του πολλαπλασιασμού μεταξύ του προβλεπόμενου φορτίου και της προβλεπόμενης τιμή

# Κεφάλαιο 5 Κ.λπ.

## 5.1 Τίτλος ενότητας

Άν θέλουμε να προσσεγγίσουμε περισσότερο τη μέθοδο του Εικονικού προπολογισμού θα δούμε ότι ο VB είναι στην ουσία το εσωτερικό γινόμενο μεταξύ μορφοποιημένου φορτίου και προβλεπόμενης τιμής, το άθροισμα δηλαδή από σημείο σε σημείο του πολλαπλασιασμού μεταξύ του προβλεπόμενου φορτίου και της προβλεπόμενης τιμή. Άν θέλουμε να προσσεγγίσουμε περισσότερο τη μέθοδο του Εικονικού προπολογισμού θα δούμε ότι ο VB είναι στην ουσία το εσωτερικό γινόμενο μεταξύ μορφοποιημένου φορτίου και προβλεπόμενης τιμής, το άθροισμα δηλαδή από σημείο σε σημείο του πολλαπλασιασμού μεταξύ του προβλεπόμενου φορτίου και της προβλεπόμενης τιμή

# Κεφάλαιο 6 - Συμπεράσματα (ή κάτι παρόμοιο)

Εδώ εξηγούμε ότι θα συνοψίσουμε την μελέτη που εκπονήθηκε στα πλαίσια της διπλωματικής.

## 6.1 Σύνοψη και συμπεράσματα

Εδώ συνοψίζουμε τα αποτελέσματα της διπλωματικής και περιγράφουμε τα συμπεράσματα που προέκυψαν, αρνητικά και θετικά. Επιβεβαιώνουμε την συνεισφορά της διπλωματικής στα προβλήματα που αναφέραμε στην εισαγωγή.

## 6.2 Μελλοντικές επεκτάσεις

Εδώ μπορούμε (προαιρετικά) να δώσουμε ιδέες για μελλοντικές κατευθύνσεις επέκτασης της διπλωματικής.

# Βιβλιογραφία

[1] D.C. Mikulecky, R. Rosen. Why are organisms different from machines?”. In Proc. 1996 Artificial Neural Networks in Engineering, St. Louis, MO, 1996, pp. 193-198.
[2] R. Rosen. Anticipatory Systems Philosophical, Mathematical & Methodological Foundations. New York, NY: Pergamon Press, 1985.
[3] Gentry T.W. A comparison of traditional forecasting techniques and neural networks. In Proc. 1995 Artificial Neural Networks in Engineering, St. Louis, MO, 1995, pp. 765-770.
[4] L.H. Tsoukalas. Neurofuzzy Approaches to Anticipation: A New Paradigm for Intelligent Systems. In IEEE Transactions on Systems, Man, and Cybernetics – Part B, v 28, n 4, p 573-582, Aug 1998.
[5] D.C. Park, M.A. El-Sharkawi, R.J. Marks, L.E. Atlas, and M.J. Damborg. Electric Load Forecasting Using an Artificial Neural Network. In IEEE Trans. on Power Systems, vol. 6, no. 2, pp. 442-449, 1991.
[6] A. Ordys, A.W. Pike, M.A. Johnson, R.M. Katebi, and M.J. Grimble. Modeling and Simulation of Power Generation Plants, New York, NY: Springer-Verlag, 1994.
[7] X. Sun, Q. Wang, and D. Zhu. Function approximation and prediction: A comparative study with neural networks and regression models. In Proc. 1997 Artificial Neural Networks in Engineering, St. Louis, MO, 1997, pp. 79-84.
[8] L.H Tsoukalas and R. Uhrig. Fuzzy and Neural Approaches in Engineering, New York, NY: Wiley, 1997.
[9] H. Demircioglu. and E. Karau. Generalized predictive control. In IEEE Control Systems Magazine, October 2000, pp. 36-47.
[10] B.E. James. Analyzing time series data: A comparison of backpropagation and classical winters’ methods. In Proc. 1994 Artificial Neural Networks in Engineering, St. Louis, MO, 1994, pp. 213-218.

# ΠΑΡΑΡΤΗΜΑΤΑ

(Εάν υπάρχει μόνο ένα παράρτημα αυτή η σελίδα παραλείπεται και εμφανίζεται μόνο η επόμενη σελίδα με το παράρτημα χωρίς αλφαβητική αρίθμηση. Δηλ. απλά ως ΠΑΡΑΡΤΗΜΑ)

# Παράρτημα Α

# Τίτλος παραρτήματος

Τα παραρτήματα περιλαμβάνουν συνοδευτικό, υποστηρικτικό υλικό (πίνακες, φωτογραφίες, ερωτηματολόγια, στατιστικά στοιχεία, αποδείξεις, περιγραφές λογισμικών προγραμμάτων, παραδείγματα, περιγραφές πολύπλοκων διαδικασιών, λίστα με πρωτογενή στοιχεία, λεπτομερή περιγραφή και προδιαγραφές εξοπλισμού, οδηγίες εγκατάστασης λογισμικού, κ.λπ.), ή αλλιώς ό,τι θεωρείται χρήσιμο να περιγραφεί, αλλά δεν συνηθίζεται να εντάσσεται μέσα στο κυρίως κείμενο της Εργασίας. Στο κυρίως κείμενο της Εργασίας πρέπει να γίνονται οι κατάλληλες παραπομπές προς τα παραρτήματα, όπου το κείμενο σχετίζεται με υλικό που περιλαμβάνεται σε αυτά. Ένα παράρτημα, αναλόγως με το περιεχόμενό του, μπορεί να είναι ενιαίο, ή να χωρίζεται σε ενότητες.

## 1.1 Βασικές αρχές

Lorem ipsum dolor sit amet, consectetur adipiscing elit. Sed consectetur pellentesque quam nec ultricies. Pellentesque sollicitudin ultrices vehicula. Vivamus luctus nunc nec nibh laoreet fermentum. Vestibulum sit amet faucibus nulla, eu pulvinar magna. Donec vel metus ex. Praesent tempus nisl id rhoncus vulputate. Curabitur arcu lorem, volutpat nec placerat eu, elementum a felis. Cras non dapibus arcu. Duis vel quam lacinia, tempor nisl vel, volutpat purus. Duis id risus vitae erat venenatis lobortis sed a tellus. Mauris ex neque, euismod et cursus nec, porttitor id metus. Aliquam malesuada tortor id ipsum placerat accumsan.

## 1.2 Επιπλέον παρατηρήσεις

Sed eget lacus augue. Maecenas placerat sodales lectus, et aliquet turpis. Sed eget enim mollis, auctor risus ac, dignissim orci. Curabitur vitae viverra nibh, ut tristique nibh. Phasellus rhoncus dignissim eleifend. Aenean rhoncus consequat ipsum, at tristique tellus. Integer tortor est, faucibus eget consequat in, facilisis et nisi. Phasellus pellentesque fringilla turpis sed ultrices. Nullam porttitor, nisl sit amet consequat vulputate, purus dui laoreet justo, id ultrices arcu lacus a nisi. Fusce maximus orci ut velit eleifend, sed vestibulum nibh viverra. Phasellus id turpis aliquet, fermentum neque nec, rutrum massa. Integer a quam nulla. Sed porta, orci ullamcorper rhoncus pellentesque, ipsum nulla pellentesque tortor, eget mattis magna nisl sed dui. Curabitur et gravida sem. Nulla nisl turpis, vehicula in sapien id, tincidunt sodales libero. Donec nec dignissim eros, rutrum facilisis nibh.

## 1.3 Παραδοχές

Aenean sodales vehicula nisl eu finibus. Quisque id neque a odio tempor dignissim ut sed odio. Maecenas at nunc vestibulum, laoreet tortor quis, tincidunt ex. In in velit ut nibh luctus egestas. Cras aliquet sem felis, nec aliquet purus convallis sit amet. Ut non elit eget metus porttitor elementum ut vel nunc. Pellentesque leo neque, sollicitudin at libero ac, scelerisque finibus nibh. Aenean mollis scelerisque dui eget tincidunt. Vestibulum aliquam et ante nec consequat. Quisque mauris urna, ultricies eget erat eu, porttitor venenatis est. Sed mollis diam quam, nec maximus purus varius at. In condimentum tellus sed hendrerit iaculis. Duis in dui sit amet nulla aliquam dignissim. Lorem ipsum dolor sit amet, consectetur adipiscing elit.

Suspendisse quis egestas massa, quis vulputate ipsum. Maecenas in pellentesque justo, vitae vehicula enim. Sed eget dolor nec nisi euismod ultrices ut nec velit. Aliquam consectetur non est vitae eleifend. Nam vulputate odio sed erat tempor ultricies. Curabitur sodales fermentum dui, a tincidunt odio egestas vitae. Aenean ac ultrices nibh. Nulla sit amet finibus purus. Phasellus at sodales erat. Suspendisse nulla mauris, feugiat posuere convallis in, auctor vitae lacus. Donec dignissim arcu quis fermentum feugiat. Praesent varius semper est a vehicula. Phasellus dignissim ante ut quam fermentum ornare. Fusce nec neque nec tellus vestibulum blandit at in tellus. Ut fermentum tincidunt orci nec consectetur.

## 1.4 Θεωρητικό υπόβαθρο

Quisque ut condimentum leo. Etiam pharetra nisl purus, eget porta ex consectetur aliquet. Vestibulum consequat viverra faucibus. Integer fermentum, eros vel tincidunt aliquet, enim sem bibendum urna, a ullamcorper mauris eros vitae neque. Suspendisse sed neque ac augue efficitur congue. Integer commodo varius pretium. Quisque non nisl vitae libero vulputate commodo aliquet vel justo. Duis iaculis, purus vulputate ultricies pharetra, lacus nisl cursus tortor, eget faucibus eros nunc sed massa. Integer luctus malesuada iaculis. Mauris et imperdiet quam. Class aptent taciti sociosqu ad litora torquent per conubia nostra, per inceptos himenaeos. Quisque ut condimentum leo. Etiam pharetra nisl purus, eget porta ex consectetur aliquet. Vestibulum consequat viverra faucibus. Integer fermentum, eros vel tincidunt aliquet, enim sem bibendum urna, a ullamcorper mauris eros vitae neque. Suspendisse sed neque ac augue efficitur congue. Integer commodo varius pretium. Quisque non nisl vitae libero vulputate commodo aliquet vel justo. Duis iaculis, purus vulputate ultricies pharetra, lacus nisl cursus tortor, eget faucibus eros nunc sed massa. Integer luctus malesuada iaculis. Mauris et imperdiet quam. Class aptent taciti sociosqu ad litora torquent per conubia nostra, per inceptos himenaeos.

# Παράρτημα Β

# Τίτλος παραρτήματος

Τα παραρτήματα περιλαμβάνουν συνοδευτικό, υποστηρικτικό υλικό (πίνακες, φωτογραφίες, ερωτηματολόγια, στατιστικά στοιχεία, αποδείξεις, περιγραφές λογισμικών προγραμμάτων, παραδείγματα, περιγραφές πολύπλοκων διαδικασιών, λίστα με πρωτογενή στοιχεία, λεπτομερή περιγραφή και προδιαγραφές εξοπλισμού, οδηγίες εγκατάστασης λογισμικού, κ.λπ.), ή αλλιώς ό,τι θεωρείται χρήσιμο να περιγραφεί, αλλά δεν συνηθίζεται να εντάσσεται μέσα στο κυρίως κείμενο της Εργασίας. Στο κυρίως κείμενο της Εργασίας πρέπει να γίνονται οι κατάλληλες παραπομπές προς τα παραρτήματα, όπου το κείμενο σχετίζεται με υλικό που περιλαμβάνεται σε αυτά. Ένα παράρτημα, αναλόγως με το περιεχόμενό του, μπορεί να είναι ενιαίο, ή να χωρίζεται σε ενότητες.

xi Σφάλμα! Χρησιμοποιήστε την καρτέλα "Κεντρική σελίδα", για να εφαρμόσετε το Heading 1 στο κείμενο που θέλετε να εμφανίζεται εδώ.

xi Σφάλμα! Χρησιμοποιήστε την καρτέλα "Κεντρική σελίδα", για να εφαρμόσετε το Heading 1 στο κείμενο που θέλετε να εμφανίζεται εδώ.Σφάλμα! Χρησιμοποιήστε την καρτέλα "Κεντρική σελίδα", για να εφαρμόσετε το Heading 1 στο κείμενο που θέλετε να εμφανίζεται εδώ.
