FotisRousogiannis/Master-s-Thesis/hardware/pcb/segment_board/bom/README.md

# BOM — διαθεσιμότητα στη JLCPCB

Τα εξαρτήματα επιλέγονται **πρώτα από τη διαθεσιμότητα** της JLCPCB (κατάλογος LCSC) και μετά μπαίνουν στο σχηματικό.

- `parts.csv` — εξάρτημα, συσκευασία, κωδικός LCSC, κατηγορία (basic/extended), ποιος το κολλά (JLC / με το χέρι).
- `jlc_check.py` — ελέγχει απόθεμα και τιμή όλων των κωδικών (`python3 jlc_check.py`). **Ξανατρέχει πριν από την παραγγελία.**

## Κανόνες
- **Basic** εξαρτήματα: είναι μόνιμα στις μηχανές της JLCPCB, χωρίς επιπλέον χρέωση. Προτιμώνται για αντιστάσεις, πυκνωτές, LED, διόδους.
- **Extended** εξαρτήματα: **~3 $ χρέωση φόρτωσης ανά διαφορετικό εξάρτημα** ανά παραγγελία (όχι ανά τεμάχιο). Τα chips μας είναι όλα extended — αναμενόμενο.
- **Απόθεμα ≥ 5 πλακέτες × ποσότητα ανά πλακέτα**, με περιθώριο.
- **Διαμπερή (THT) connectors** (MCV, XT30, MSTB, header 2×20, ηλεκτρολυτικοί): κολλιούνται **με το χέρι**· αγοράζονται από διανομέα αν η JLCPCB δεν έχει αρκετό απόθεμα.

## Έλεγχος 2026-11-08
Όλα τα SMD chips διαθέσιμα με επαρκές απόθεμα. Το MCV 1,5/4 (encoders) έχει μόνο 81 τεμ. (χρειάζονται 30)· τα XT30, MSTB 5.08
και το ψηλό header 2×20 δεν υπάρχουν στη JLCPCB → αγορά από διανομέα, κόλληση με το χέρι.
