FotisRousogiannis/Master-s-Thesis/hardware/pcb/segment_board/bom/parts.csv

function | part | package | lcsc | jlc_type | assembly | notes
Controller | ESP32-S3-WROOM-1-N8R8 | module 25.5x18 mm | C2913201 | extended | JLC | integrated antenna at board edge
Servo PWM driver | PCA9685PW | TSSOP-28 | C2678753 | extended | JLC
I2C mux (encoders) | TCA9548APWR | TSSOP-24 | C130026 | extended | JLC
ADC (touch sensors) | ADS1115IDGSR | VSSOP-10 | C37593 | extended | JLC
Servo current monitor | INA219AIDCNR | SOT-23-8 | C87469 | extended | JLC
3.3 V buck (from 5.1 V) | AP63203WU-7 | TSOT-23-6 | C780769 | extended | JLC
USB ESD protection | USBLC6-2SC6 | SOT-23-6 | C7519 | extended | JLC
USB-C receptacle (ESP32) | TYPE-C-31-M-12 | SMD | C165948 | extended | JLC
RS-485 full-duplex transceiver | THVD1451DRBR | VSON-8 | C2671344 | extended | JLC | no enable pins; MAX3490 pinout
Reverse-polarity P-MOSFET (7.4 V) | AO4407A | SOIC-8 | C16072 | extended | JLC
eFuse 5.1 V input (logic + Pi) | TPS259472ARPWR | VQFN-10 | C3662789 | extended | JLC | limit ~4 A; reverse-current blocking; replaces fuse + ideal diode
eFuse 7.4 V input (servos) | TPS259827ONRGER | VQFN-24 4x4 | C2155761 | extended | JLC | limit ~10 A; soft-start; EN from ESP32/Pi + E-stop
Backup fuse 7.4 V | 15 A fuse (blade or 2410 SMD) | - | tbd | tbd | tbd | last line of defence behind the eFuse
Ideal diode (ESP32 USB 5 V OR-ing) | LM66100DCKR | SC-70-6 | C2869734 | extended | JLC
TVS 7.4 V input | SMBJ9.0A | SMB | C152088 | extended | JLC
TVS 5.1 V input | SMBJ6.0A | SMB | C19077560 | extended | JLC | standoff 6.0 V above the 5.1 V rail
Schottky servo ground clamp (5 A; stall up to ~4 A) | SS54 | SMA | C22452 | basic | JLC | 9 per board
Comparator quad (hardware connection LEDs) | LM339DR | SOIC-14 | C7948 | extended | JLC | 5 per board
Servo connector 3-pin | Phoenix MCV 1.5/3-G-3.5 (1843606) | THT P3.5 | C3019639 | extended | hand | 9 per board
Encoder connector 4-pin | Phoenix MCV 1.5/4-G-3.5 (1843619) | THT P3.5 | C3019620 | extended | hand | 6 per board - low JLC stock; buy from distributor
7.4 V servo input | XT30PW-M | THT | - | not stocked | hand | buy separately
5.1 V logic input | Phoenix MSTB 2.5/2-G-5.08 | THT P5.08 | - | not stocked | hand | buy separately
Pi header 2x20 (tall female) | 2x20 female stacking header | THT P2.54 | - | tbd | hand | height chosen for ~20 mm Pi clearance
