FotisRousogiannis/Master-s-Thesis/hardware/pcb/segment_board/sim/results/encoder_detect.png

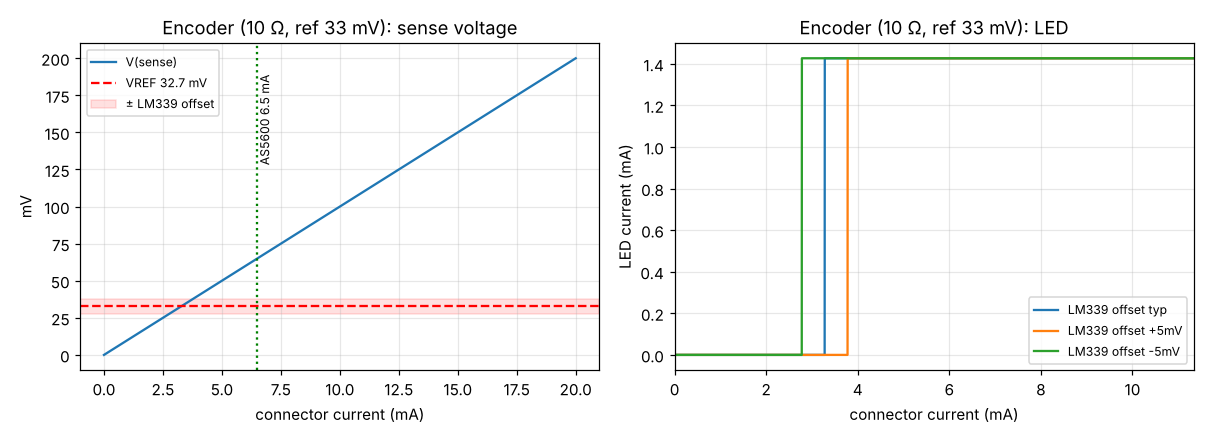
hardware/pcb/segment_board/sim/results/encoder_detect.png
