FotisRousogiannis/Master-s-Thesis/hardware/pcb/segment_board/sim/results/servo_detect.png

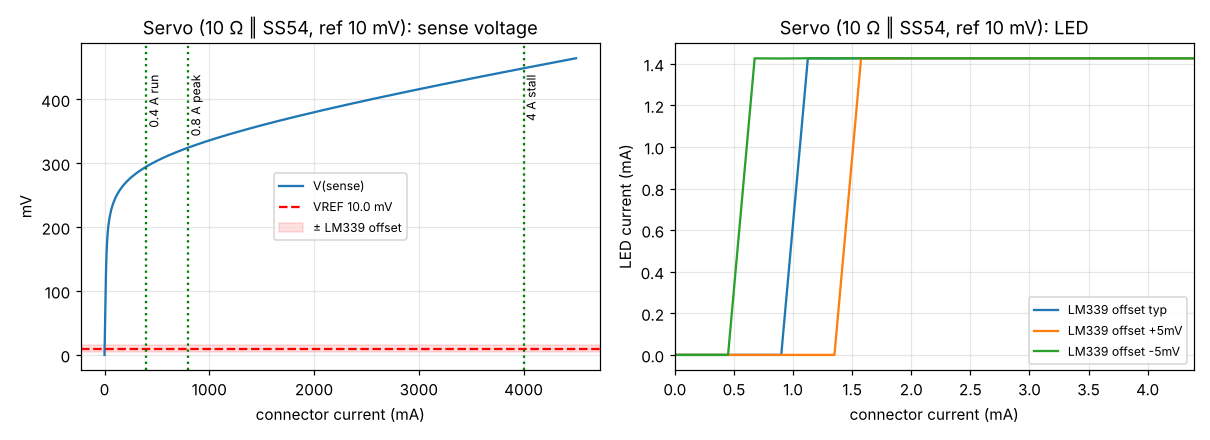
hardware/pcb/segment_board/sim/results/servo_detect.png
