FotisRousogiannis/Master-s-Thesis/hardware/pcb/segment_board/sim/results/touch.png

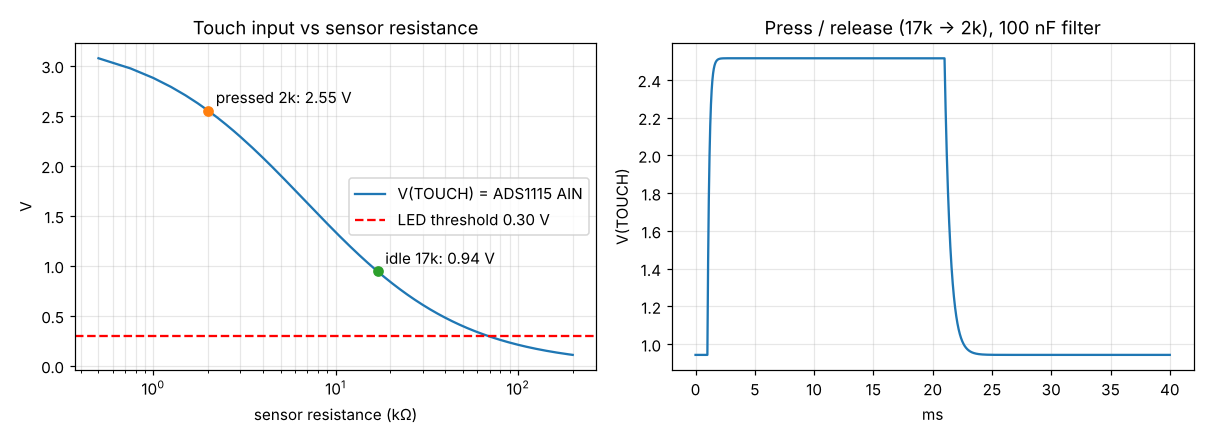
hardware/pcb/segment_board/sim/results/touch.png
