FotisRousogiannis/Master-s-Thesis/docs/devlog.md

# Ημερολόγιο ανάπτυξης

Χρονολογική καταγραφή εργασιών. Οι αποφάσεις με αιτιολόγηση βρίσκονται στο
[`decisions/`](decisions/README.md)· εδώ σημειώνεται τι έγινε και τι ακολουθεί.

## 2026-10-20
**Έγινε**
- Ορίστηκε η δομή του repo και η ροή branches `draft` → `testing` → `main` (ADR-0003).
- Επιλέχθηκε ROS 2 Jazzy + Gazebo Harmonic + ros2_control + MoveIt 2 (ADR-0001)
  και περιβάλλον ανάπτυξης σε Docker / Dev Container (ADR-0002).
- Συζητήθηκε και κλείδωσε η αρχιτεκτονική συστήματος (ADR-0004 έως 0008):
  υπολογιστής ως μοναδικός host χωρίς Raspberry Pi, δύο PCB με ESP32 και
  τοπικό βρόχο θέσης, I²C μόνο μέσα στην πλακέτα, WiFi (micro-ROS/UDP) προς
  τον υπολογιστή, κάμερα D435if σταθερή.
- Δημιουργήθηκε το package `arm_description` με προσωρινό URDF 6 αρθρώσεων,
  launch για RViz και tests δομής (ADR-0009). Τα tests περνούν εκτός ROS· δεν
  έχει δοκιμαστεί ακόμα μέσα στο Docker.

- Εγκατάσταση στον υπολογιστή ανάπτυξης (Ubuntu 26.04, Lenovo Legion Y530) κατά
  τον οδηγό `docs/setup/ubuntu.md`: αντικατάσταση snap Docker με `docker.io`
  (ADR-0010), χτίσιμο image (6.66 GB), `colcon build` + 5/5 tests, το μοντέλο
  εμφανίζεται στο RViz και κινείται. **Ορόσημο: περιβάλλον ανάπτυξης λειτουργικό.**

- Προώθηση `draft` → `testing`, tag **`v0.1-dev-env`** (πρώτο ορόσημο).

**Επόμενα**
- CI στο GitHub (αυτόματο build + tests σε κάθε push).
- `arm_bringup`: ros2_control με mock hardware, μετά Gazebo.
- Export του CAD από το Fusion 360 (URDF + STL ανά σύνδεσμο).
- Κατανομή αρθρώσεων ανά PCB όταν ολοκληρωθούν τα PCB.

## 2026-10-21
**Έγινε**
- Προσπάθεια εξαγωγής του CAD με το add-in ACDC4Robot: σφάλμα με As-built joints
  (λύθηκε με κανονικά joints), σφάλμα στην εξαγωγή STL, και crash του Fusion
  ακόμα και με 2 συνδέσμους, χωρίς διαγνωστικά.
- Συμφωνήθηκαν κανόνες μοντελοποίησης: ένα component ανά σύνδεσμο με πολλά solid
  bodies, επίπεδη δομή, δάχτυλα αρπάγης ως ξεχωριστά components (mimic στο xacro),
  ενεργά όρια min/max, πρόχειρα υλικά με διόρθωση μαζών από μετρήσεις.
- Γράφτηκε δικό μας script εξαγωγής για το Fusion (`software/tools/fusion_export/`, ADR-0011).

**Επόμενα**
- Εκτέλεση του script στον βραχίονα· αν κρασάρει, η τελευταία γραμμή του log δείχνει πού.
- Generator JSON → xacro και αντικατάσταση του προσωρινού URDF (ADR-0009).

## 2026-11-01
**Έγινε**
- Πάγκος δοκιμών καρπού με Raspberry Pi + TCA9548A + PCA9685 (ADR-0012): εργαλείο
  `software/tools/wrist_bench/` (scan, encoders, servo, διαφορικό, νεκρή ζώνη) με
  όρια ασφαλείας και 11 tests σε προσομοιωμένο bus· πρωτόκολλο T0–T5 στο
  `docs/testing/wrist_bench.md`.

**Επόμενα**
- Εκτέλεση T0–T2 (χωρίς κίνηση) στον καρπό.

## 2026-11-05 έως 2026-11-07
**Έγινε**
- Πάγκος καρπού: σάρωση I²C (PCA9685 στο κανάλι 0, AS5600 στα 1/6/7), encoders επαληθευμένοι με το χέρι,
  εντολές `probe` και `jog` (πληκτρολόγιο, ελληνική διάταξη, χωρίς/με encoders), όρια παλμού κατά την
  προδιαγραφή του servo (500–2500 µs, νεκρό 1600)· τα servo κινούνται.
- Αισθητήρες αφής ZD10 + ADS1115: συνδεσμολογία, επιλογή αντίστασης διαιρέτη από μετρήσεις
  (17 kΩ → 2 kΩ ⇒ 6.8 kΩ), επαλήθευση 2.5 V σε μέγιστη πίεση (`docs/hardware/wiring.md`).
- Απόφαση να σχεδιαστεί PCB καρπού στο KiCad 9.

**Επόμενα**
- Αποφάσεις PCB (modules/SMD, ESP32, χώρος, servo/encoders, τάση εισόδου) και σχηματικό.
- T3–T5 στον πάγκο, εντολή `touch` για τον ADS1115.

## 2026-11-08
**Έγινε**
- Αποφάσεις PCB: SMD, 4 στρώσεις, 5 τεμάχια, κοινή πλακέτα για όλο τον βραχίονα (9 servo, 6 encoders, 2 αφής),
  Pi ανάποδα από πάνω με τροφοδοσία από τα GPIO, UART/RS-485 (ADR-0013/0014), τροφοδοσία v1 με 2 γραμμές και eFuse
  (ADR-0015), LED σύνδεσης με υλικό (συγκριτές), connectors MCV 3.5 mm + XT30 + MSTB 5.08.
- Έλεγχος διαθεσιμότητας στη JLCPCB (`bom/jlc_check.py`).
- **Σχηματικό v1** παραγόμενο από κώδικα (`gen/build.py`): 5 φύλλα, 233 εξαρτήματα, 185 σήματα· έλεγχος netlist χωρίς προβλήματα.

**Επόμενα**
- ERC στο KiCad 9 (GitHub Actions), έλεγχος του σχηματικού από τον Φώτη.
- Footprints eFuse / κατοπτρικό header Pi, μέτρηση ρεύματος ηρεμίας servo, layout.
- ERC KiCad 9 (CI): **0 errors**, 25 warnings (footprint βιβλιοθήκης eFuse που λείπει ακόμα, παλιά αντίγραφα συμβόλων LED/ESP32).
- **Προσομοίωση SPICE** (ngspice) των αναλογικών κυκλωμάτων (`hardware/pcb/segment_board/sim/`): διαιρέτης αφής,
  ανίχνευση σύνδεσης encoder/servo/αφής με LM339, ανύψωση γείωσης servo, ρεύμα LED. Όλα εντός ορίων· ευρήματα:
  το servo ανιχνεύεται μόνο αν το ρεύμα ηρεμίας > 3.2 mA (μέτρηση), τα LED σύνδεσης θέλουν χαμηλή Vf (AlInGaP).
- Αντίσταση μέτρησης servo **4.7 Ω → 10 Ω**: το QY3240MG δεν έχει δημοσιευμένο ρεύμα ηρεμίας, παρόμοια servo 4–20 mA·
  με 10 Ω η ανίχνευση γίνεται στα 0.5–1.5 mA (περιθώριο ≥ ×2.6). Επιβεβαίωση με μέτρηση στο εργαστήριο.
- Στοιχεία QY3240MG (διαδίκτυο, χωρίς datasheet): ηρεμία ~5–10 mA, κίνηση 100–300 mA, μπλοκάρισμα ~2.5–4 A.
  Δίοδος γείωσης servo **SS34 → SS54** (5 A, ίδιο SMA footprint, basic part). Προσομοίωση στα 4 A: σήμα 2.85 V, 1.8 W
  στη δίοδο → το firmware πρέπει να κόβει παρατεταμένο μπλοκάρισμα.
- **Footprints project** (`gen/footprints.py`): TPS259827 (TI RGE0024M, 2 thermal pads + vias), TPS259472A
  (TI RPW0010A, γωνιακά pads σε σχήμα L), πηνίο 4×4 (C135262), header Pi ανάποδα (κατοπτρικές στήλες) με περίγραμμα
  Pi 4/5. Έλεγχος με τα land patterns των datasheet και της LCSC.
- **LCSC για όλα τα SMD** (`bom/resolve_passives.py` → `passives.csv`, προτίμηση σε basic parts). LED χαμηλής Vf
  (κιτρινοπράσινο/κίτρινο/κόκκινο ≈ 2 V)· το μπλε LED κατάστασης έγινε κόκκινο (3 V Vf δεν ανάβει από GPIO 3.3 V).
- **Αρχικό PCB** (`gen/pcb.py`): 100×100, 4 στρώσεις, GND στο In1, οπές M3, Pi ανάποδα στο δεξί μισό με θύρες στην
  κάτω άκρη, κεραία ESP32 στην πάνω άκρη, connectors σε 4 στήλες αριστερά. Κανόνες JLC και net classes (`gen/rules.py`).
  CI: DRC με ισοτιμία σχηματικού + εικόνες πλακέτας.
- Διόρθωση: το «κάτω 4 servo / 3 encoders, πάνω 5 servo / 3 encoders + αφή» αφορά τις δύο θέσεις πλακέτας
  (πλάτη / καρπός), όχι πλευρές της πλακέτας.
- DRC (KiCad 9 στο CI) εντόπισε λάθος στο footprint TPS259827: οι σειρές pads είναι 3.825 mm **κέντρο-κέντρο**
  (όχι συνολικό εύρος) → τα pads ακουμπούσαν τα thermal pads. Διορθώθηκε (απόσταση 0.275 mm όπως στο TI)· το PCB
  ξαναπαράχθηκε (δεν είχε γίνει ακόμα χειροκίνητη δουλειά).
- Κάθε πλακέτα καλύπτει **όλο** τον βραχίονα: 9 servo, 6 encoders, 2 αφής (R4, ήδη στο σχηματικό).
- Νέο: **έξοδοι τροφοδοσίας 7.4 V (XT30UPB-F) και 5.1 V (MSTB)** προς την επόμενη πλακέτα, πριν από το eFuse
  (ADR-0015 συμπλήρωμα· επιλογή Φώτη). Το PCB ξαναπαράχθηκε (χωρίς χειροκίνητη δουλειά ακόμα): έξοδοι στην 4η στήλη,
  κοντά στις εισόδους.
- Ο Φώτης άνοιξε/ενημέρωσε το PCB (zones, F8, footprints από βιβλιοθήκη) — αποθηκευμένο με **KiCad 10** (μορφή
  20260206), όχι 9. Το CI πέρασε σε `kicad/kicad:10.0` και πλέον αποτυγχάνει αν δεν φορτώνει η πλακέτα.
  Το KiCad (ανοιχτό κατά το `git pull`) είχε ξαναγράψει το `.kicad_pro` χωρίς net classes/κανόνες → επαναφορά με
  `gen/rules.py`. `.gitignore`: `~*.lck`, `.history/`.
- DRC σε KiCad 10: 0 σφάλματα απόστασης/βραχυκυκλώματος. Ευρήματα: (α) το footprint USB-C της βιβλιοθήκης KiCad 10
  ονομάζει τα pads θωράκισης `SH` ενώ το σύμβολο έχει pin `S1` → θωράκιση ασύνδετη· λύση: αντίγραφο footprint στο
  project (`USB_C_Receptacle_HRO_TYPE-C-31-M-12_S1`). (β) 123 footprints χωρίς πεδίο LCSC μετά το «Update Footprints
  from Library» → ξανά F8 με ενημέρωση πεδίων. (γ) 7 starved thermals στο GND zone — μετά την τοποθέτηση.
