FotisRousogiannis/Master-s-Thesis/hardware/pcb/segment_board/output/segment_board_schematic.pdf

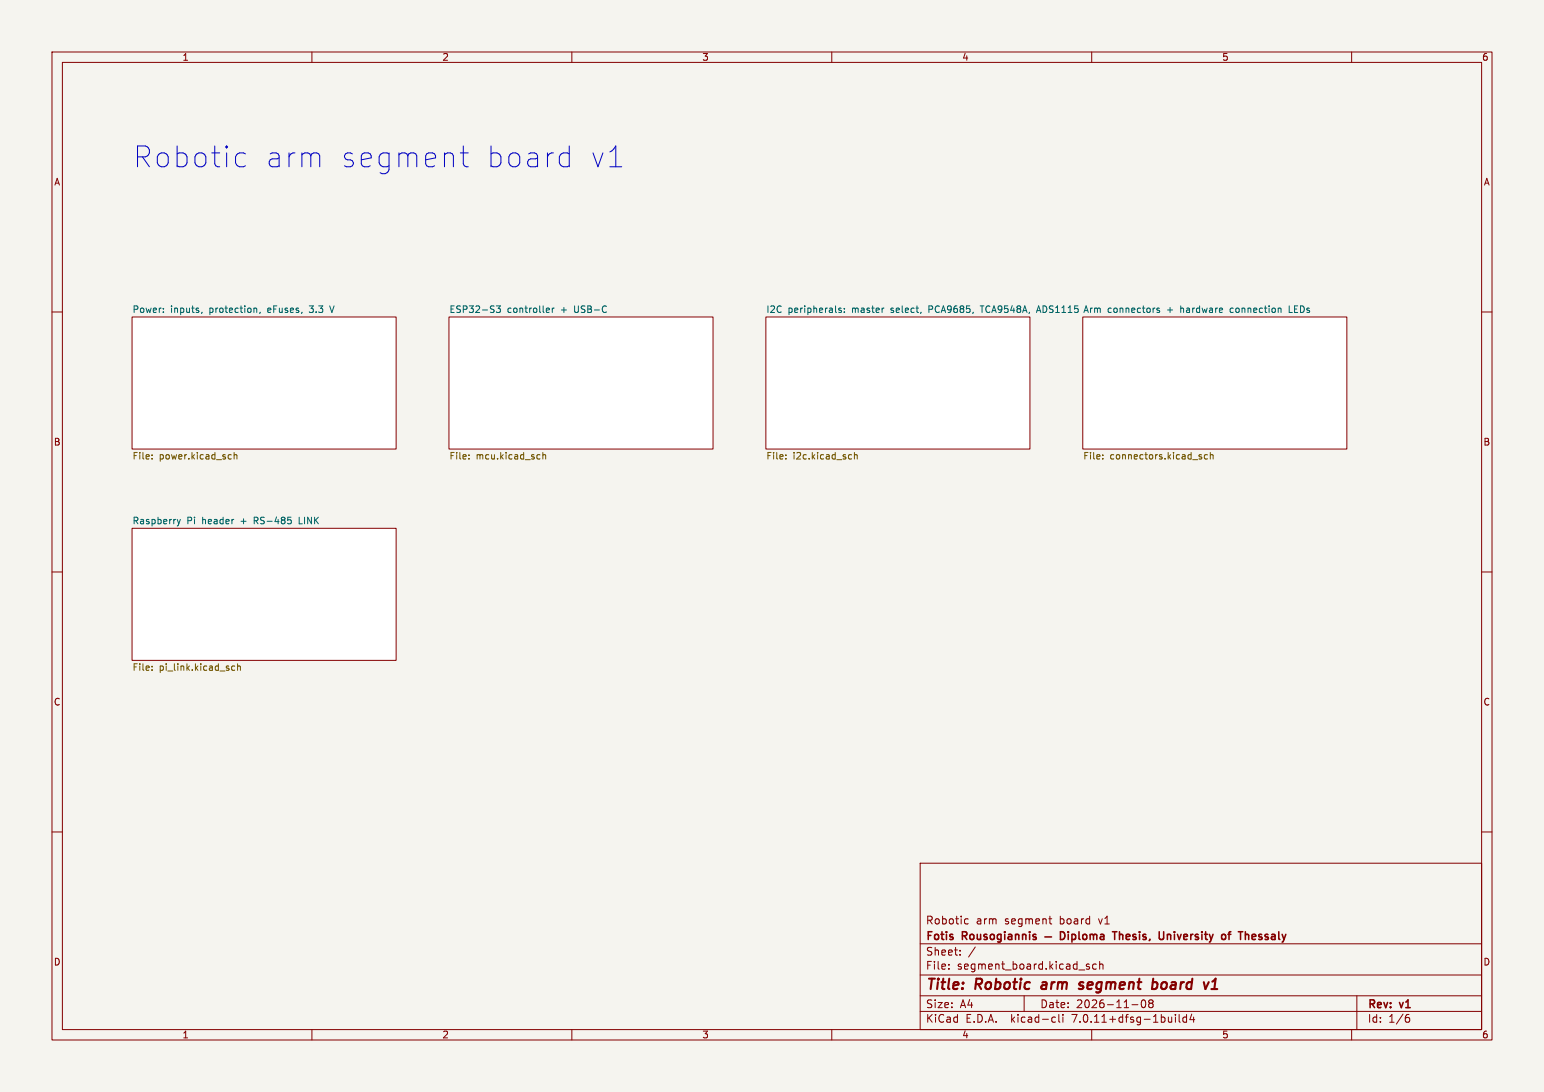
[picture p10: page 1]

Id: 1/6 Title: Robotic arm segment board v1

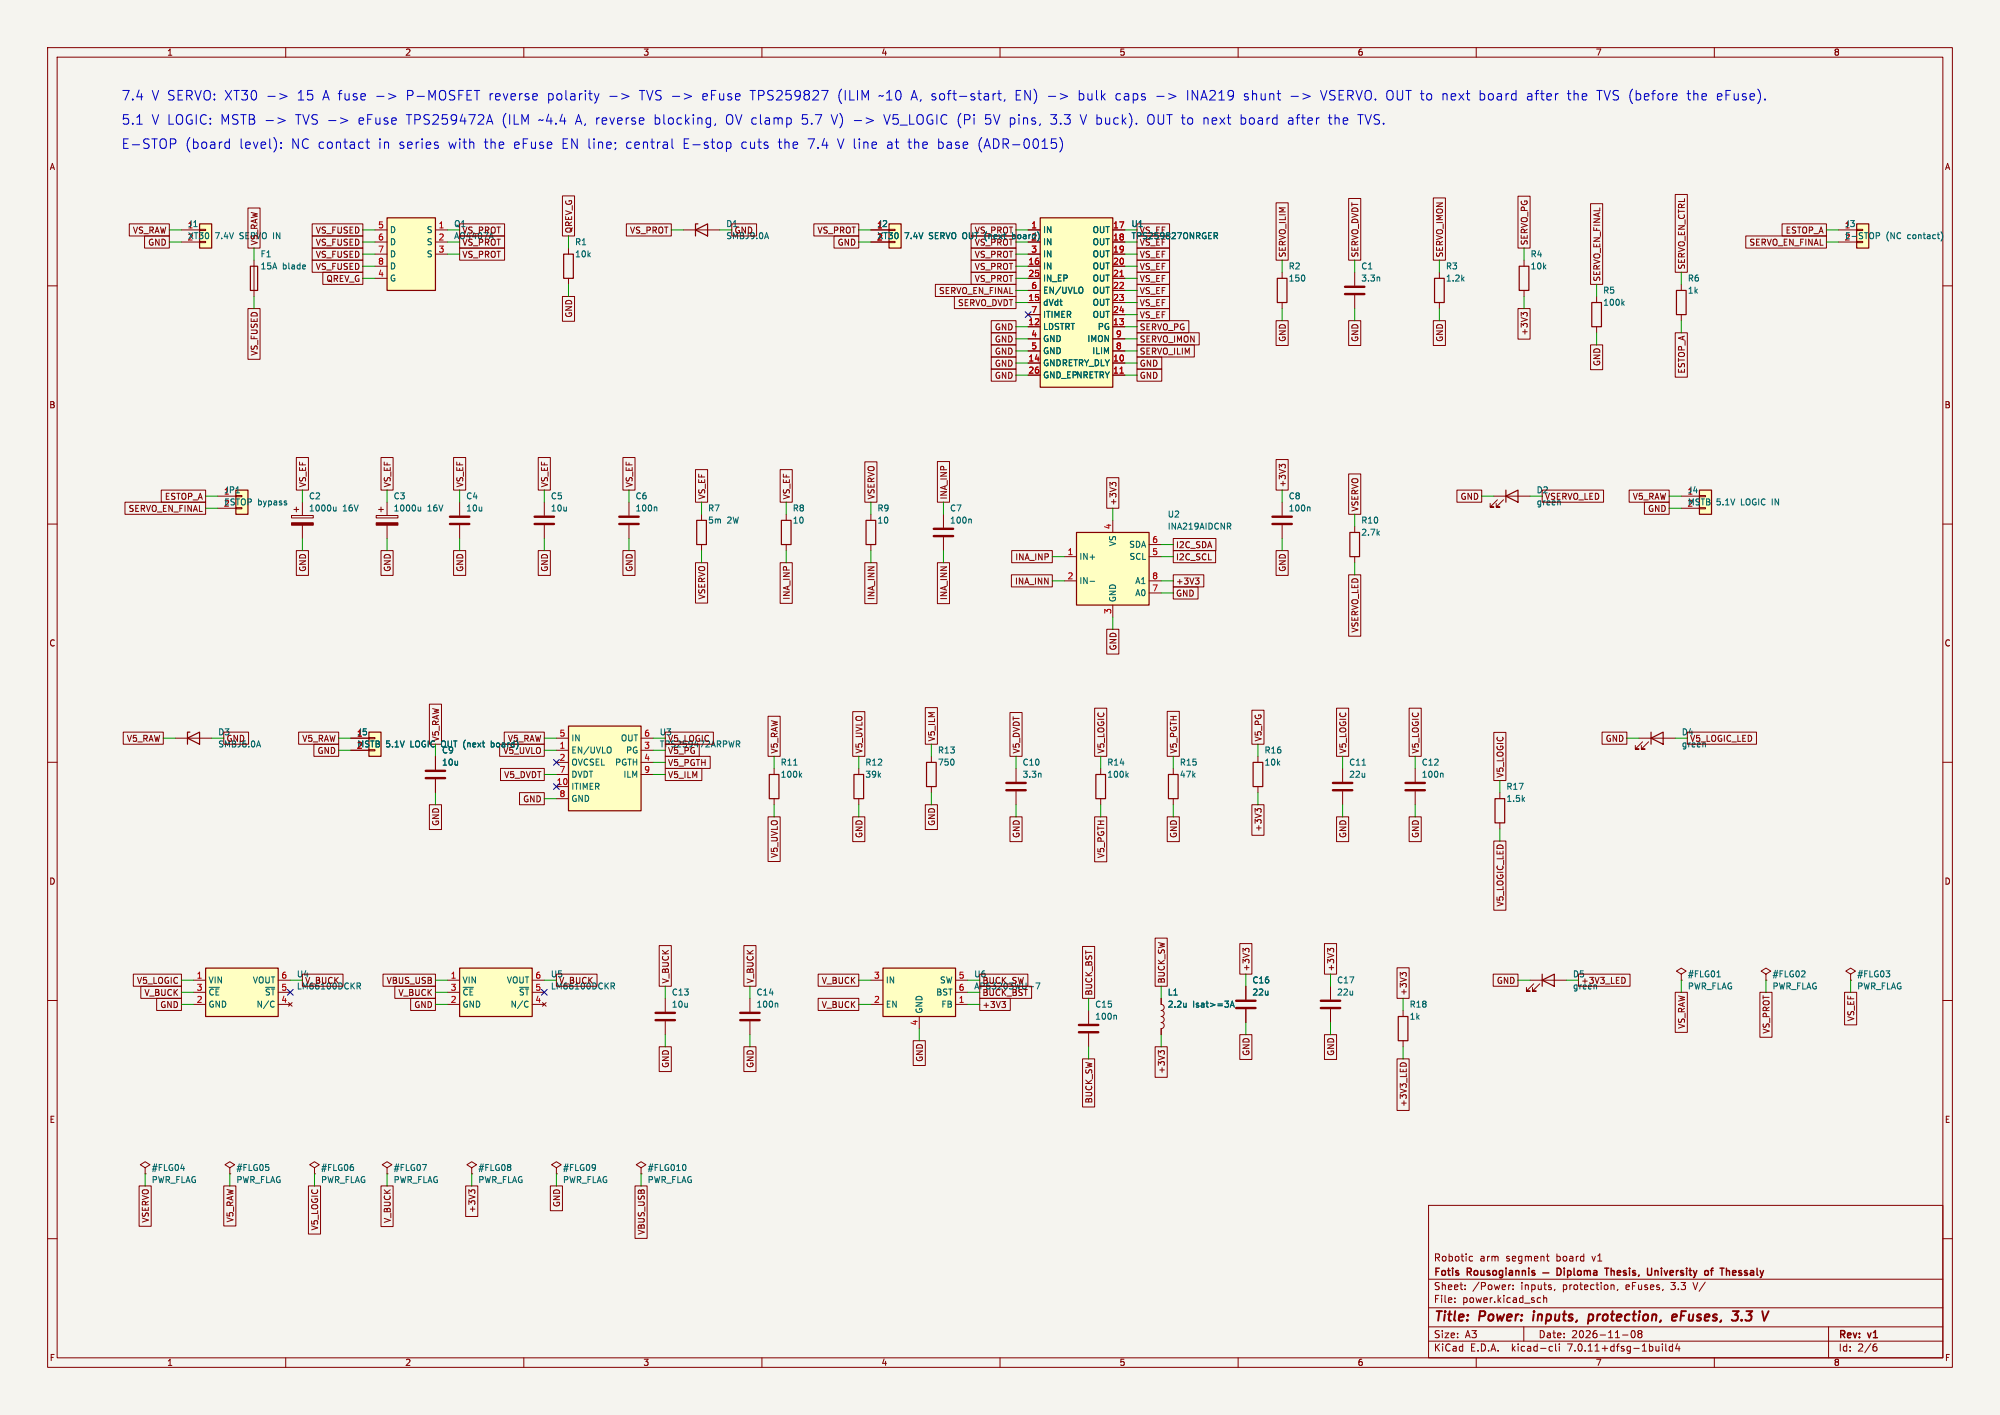
[picture p11: page 2]

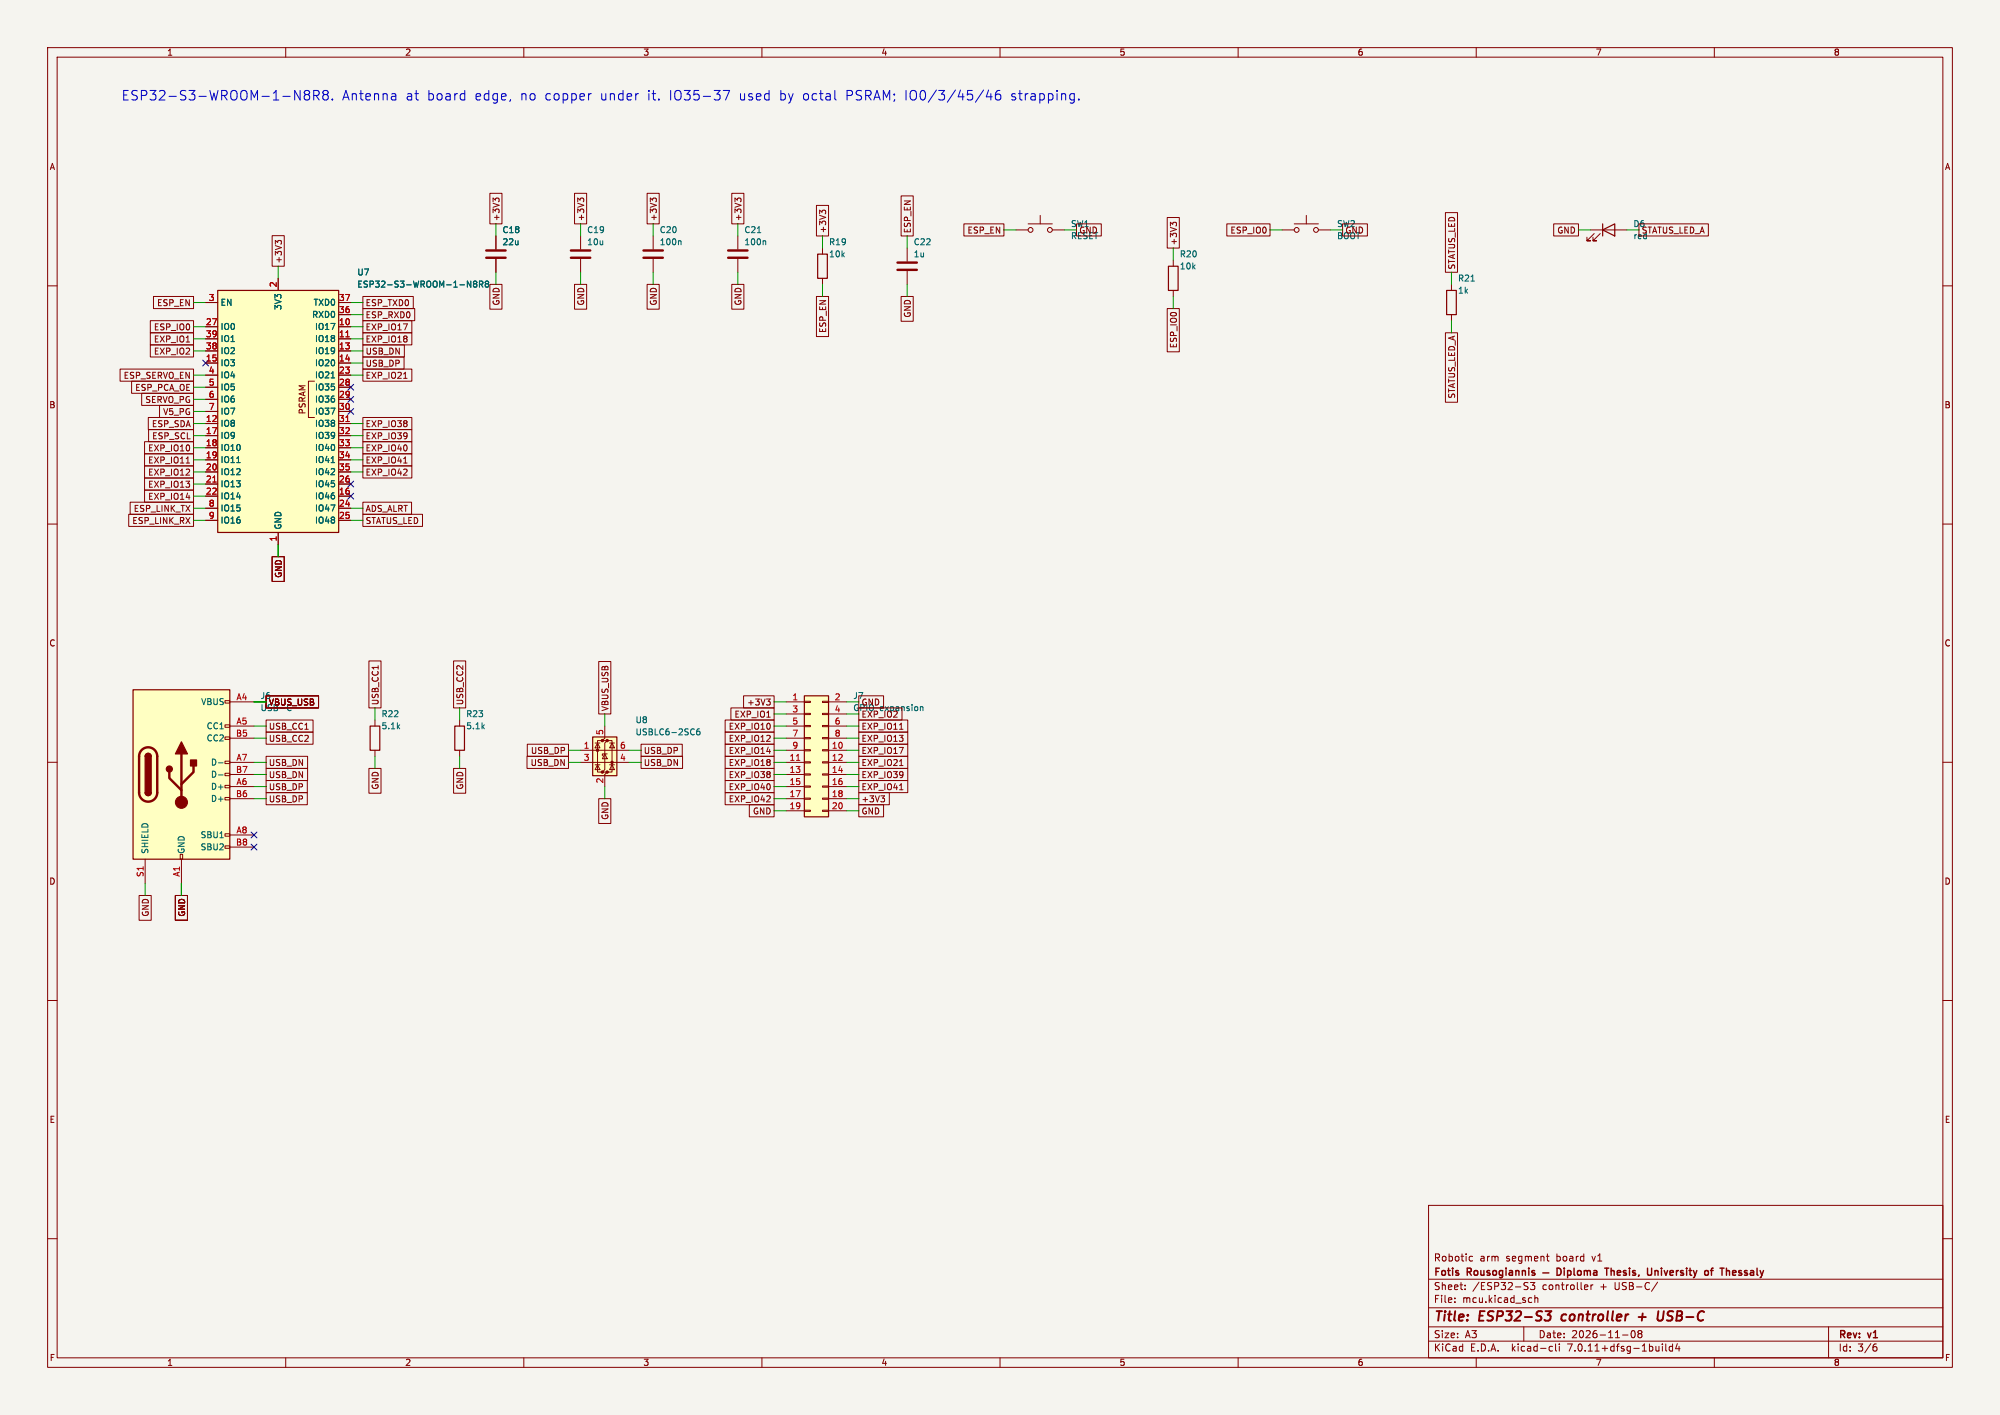
[picture p12: page 3]

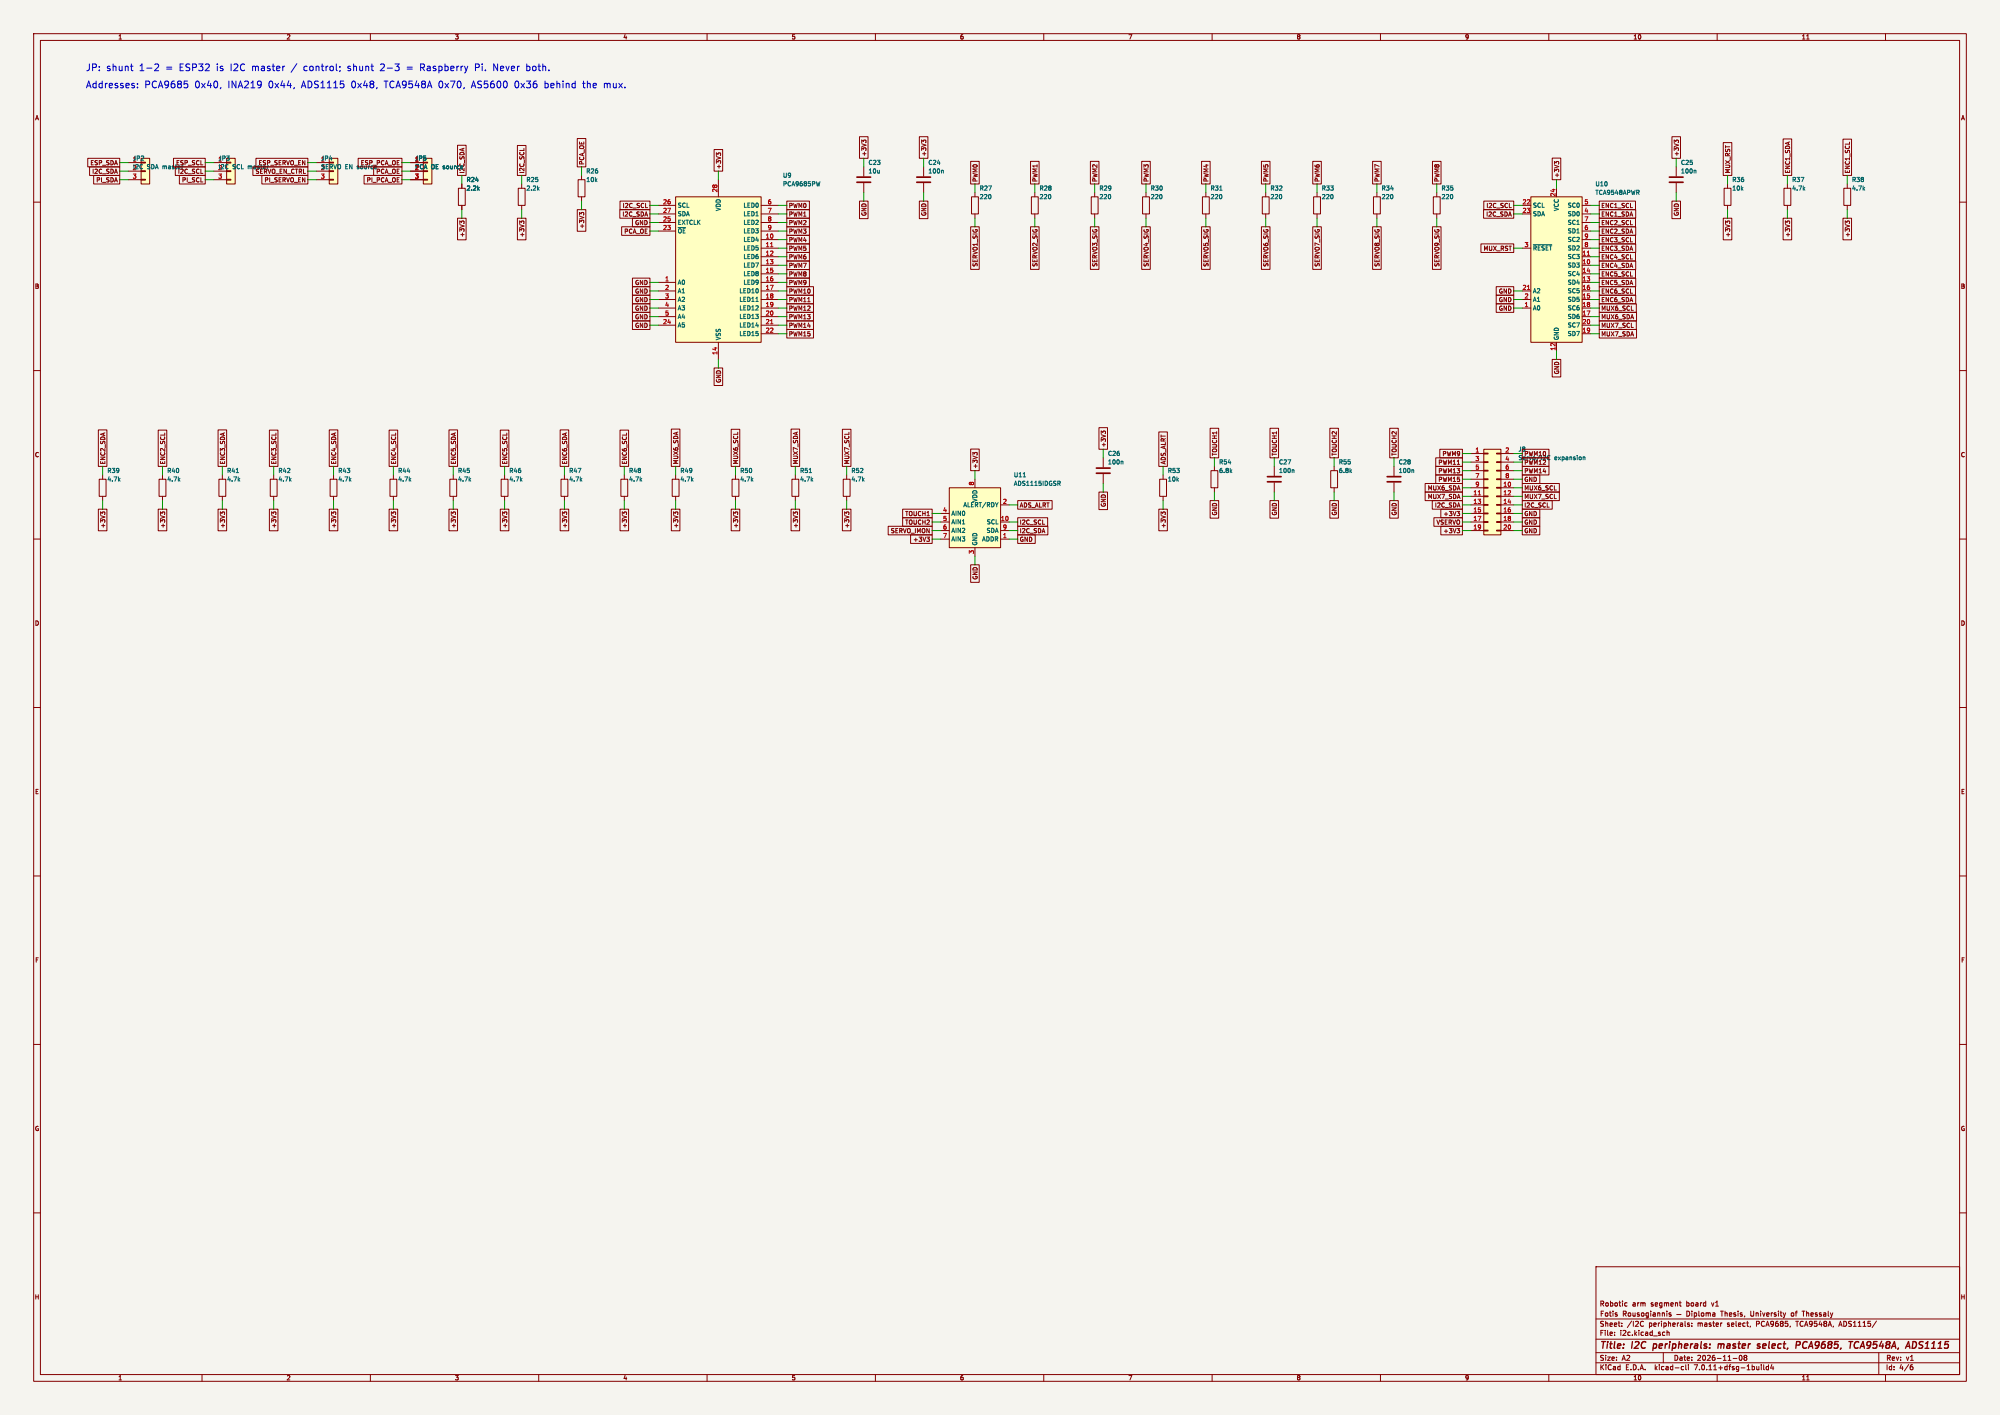
[picture p13: page 4]

Addresses: PCA9685 0x40, INA219 0x44, ADS1115 0x48, TCA9548A 0x70, AS5600 0x36 behind the mux. JP5 PCA OE source

100n ADDR 1 SCL 10 ALERT/RDY 2 GND

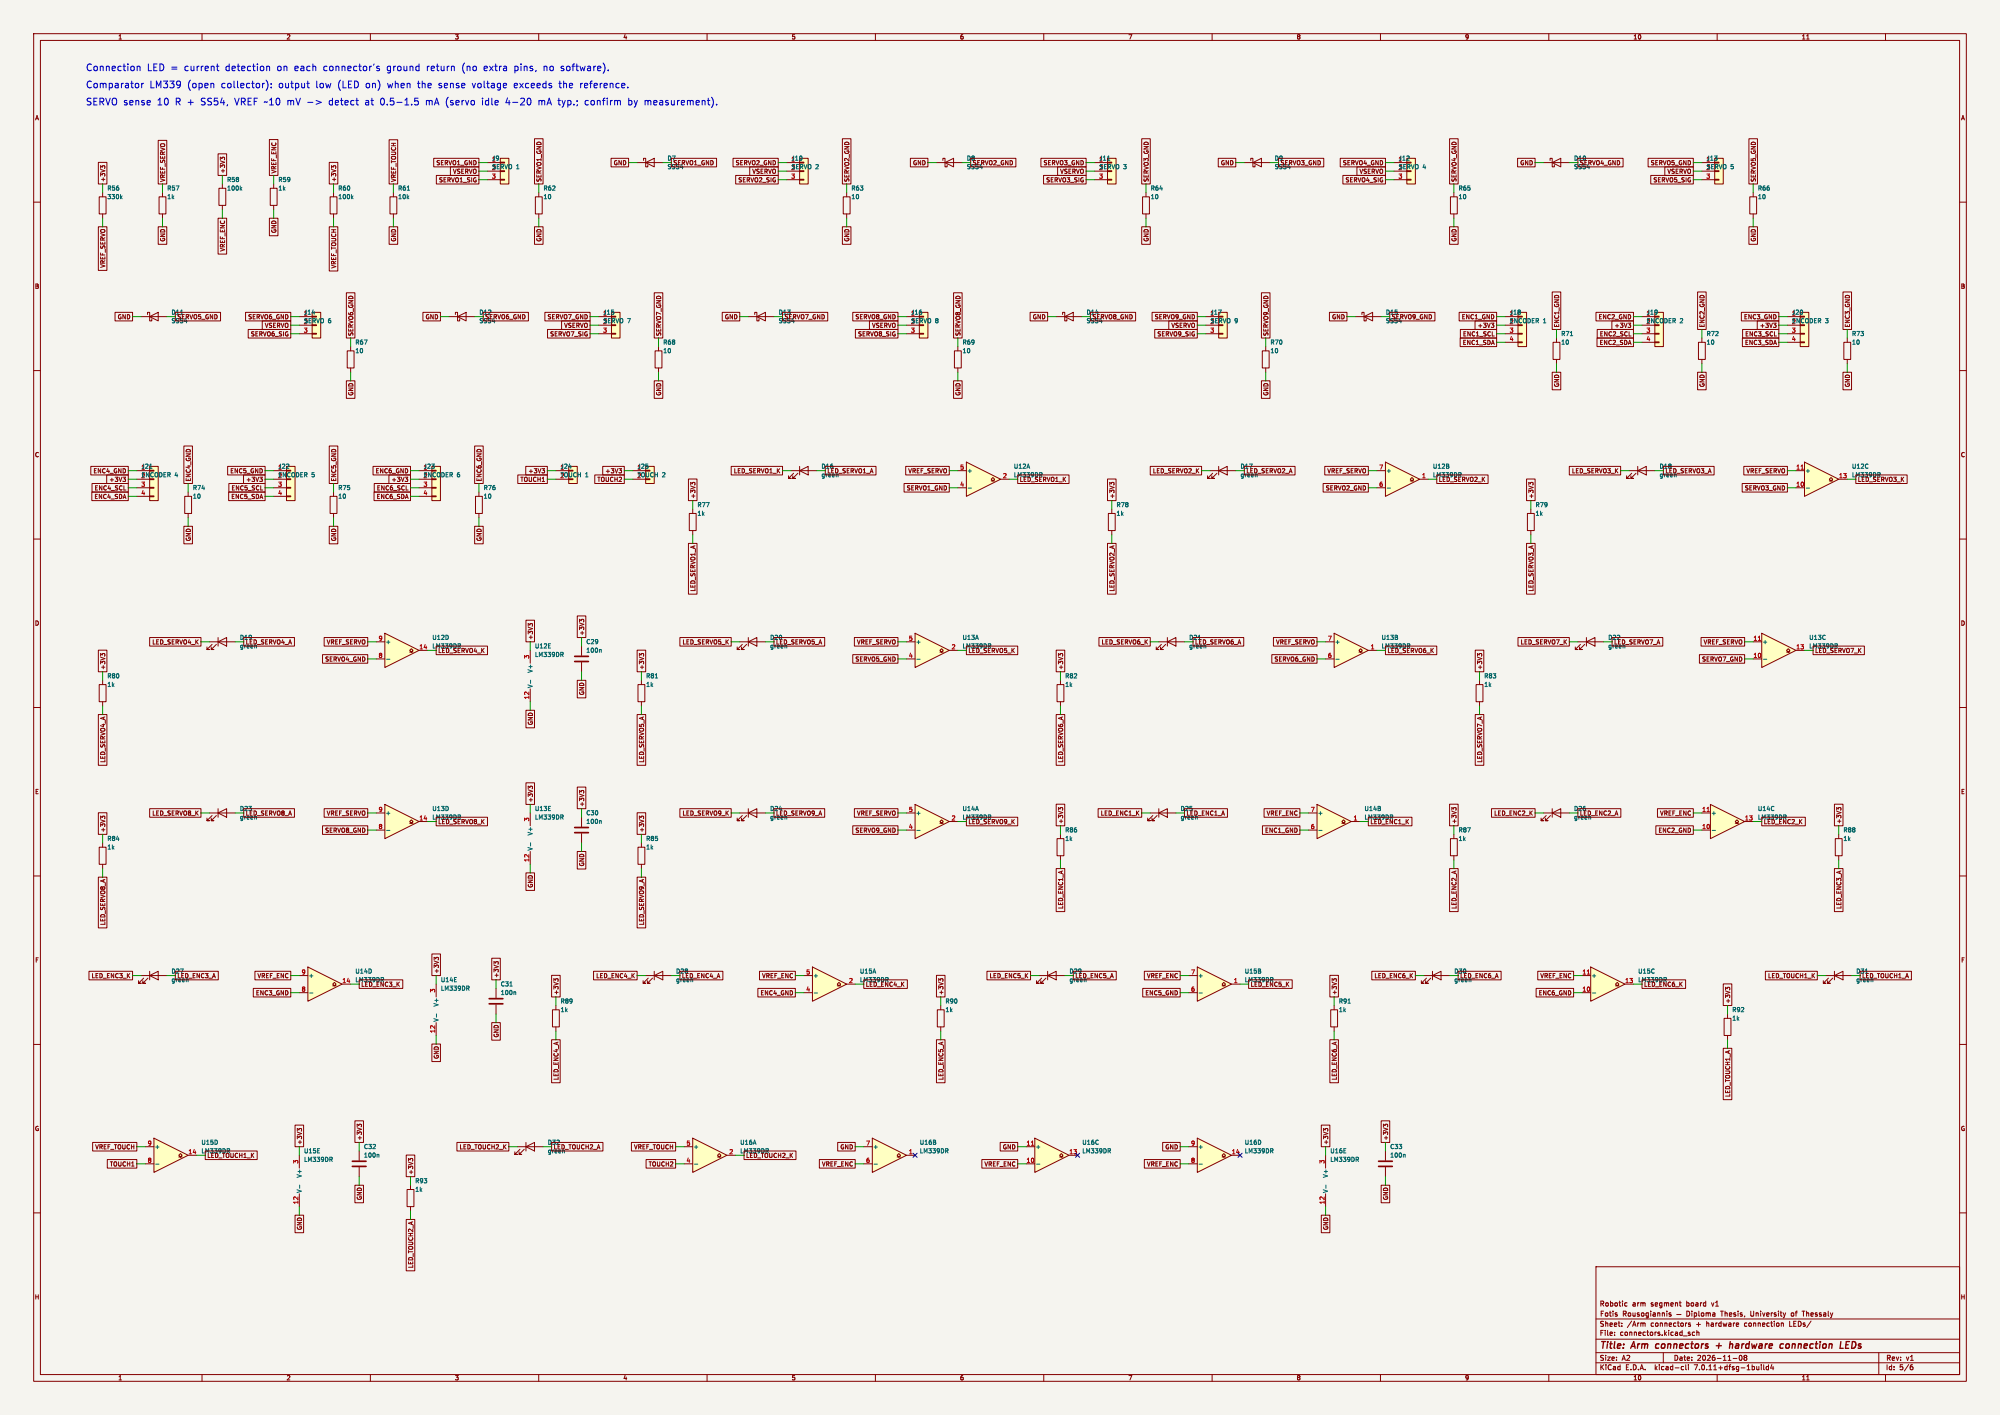
[picture p14: page 5]

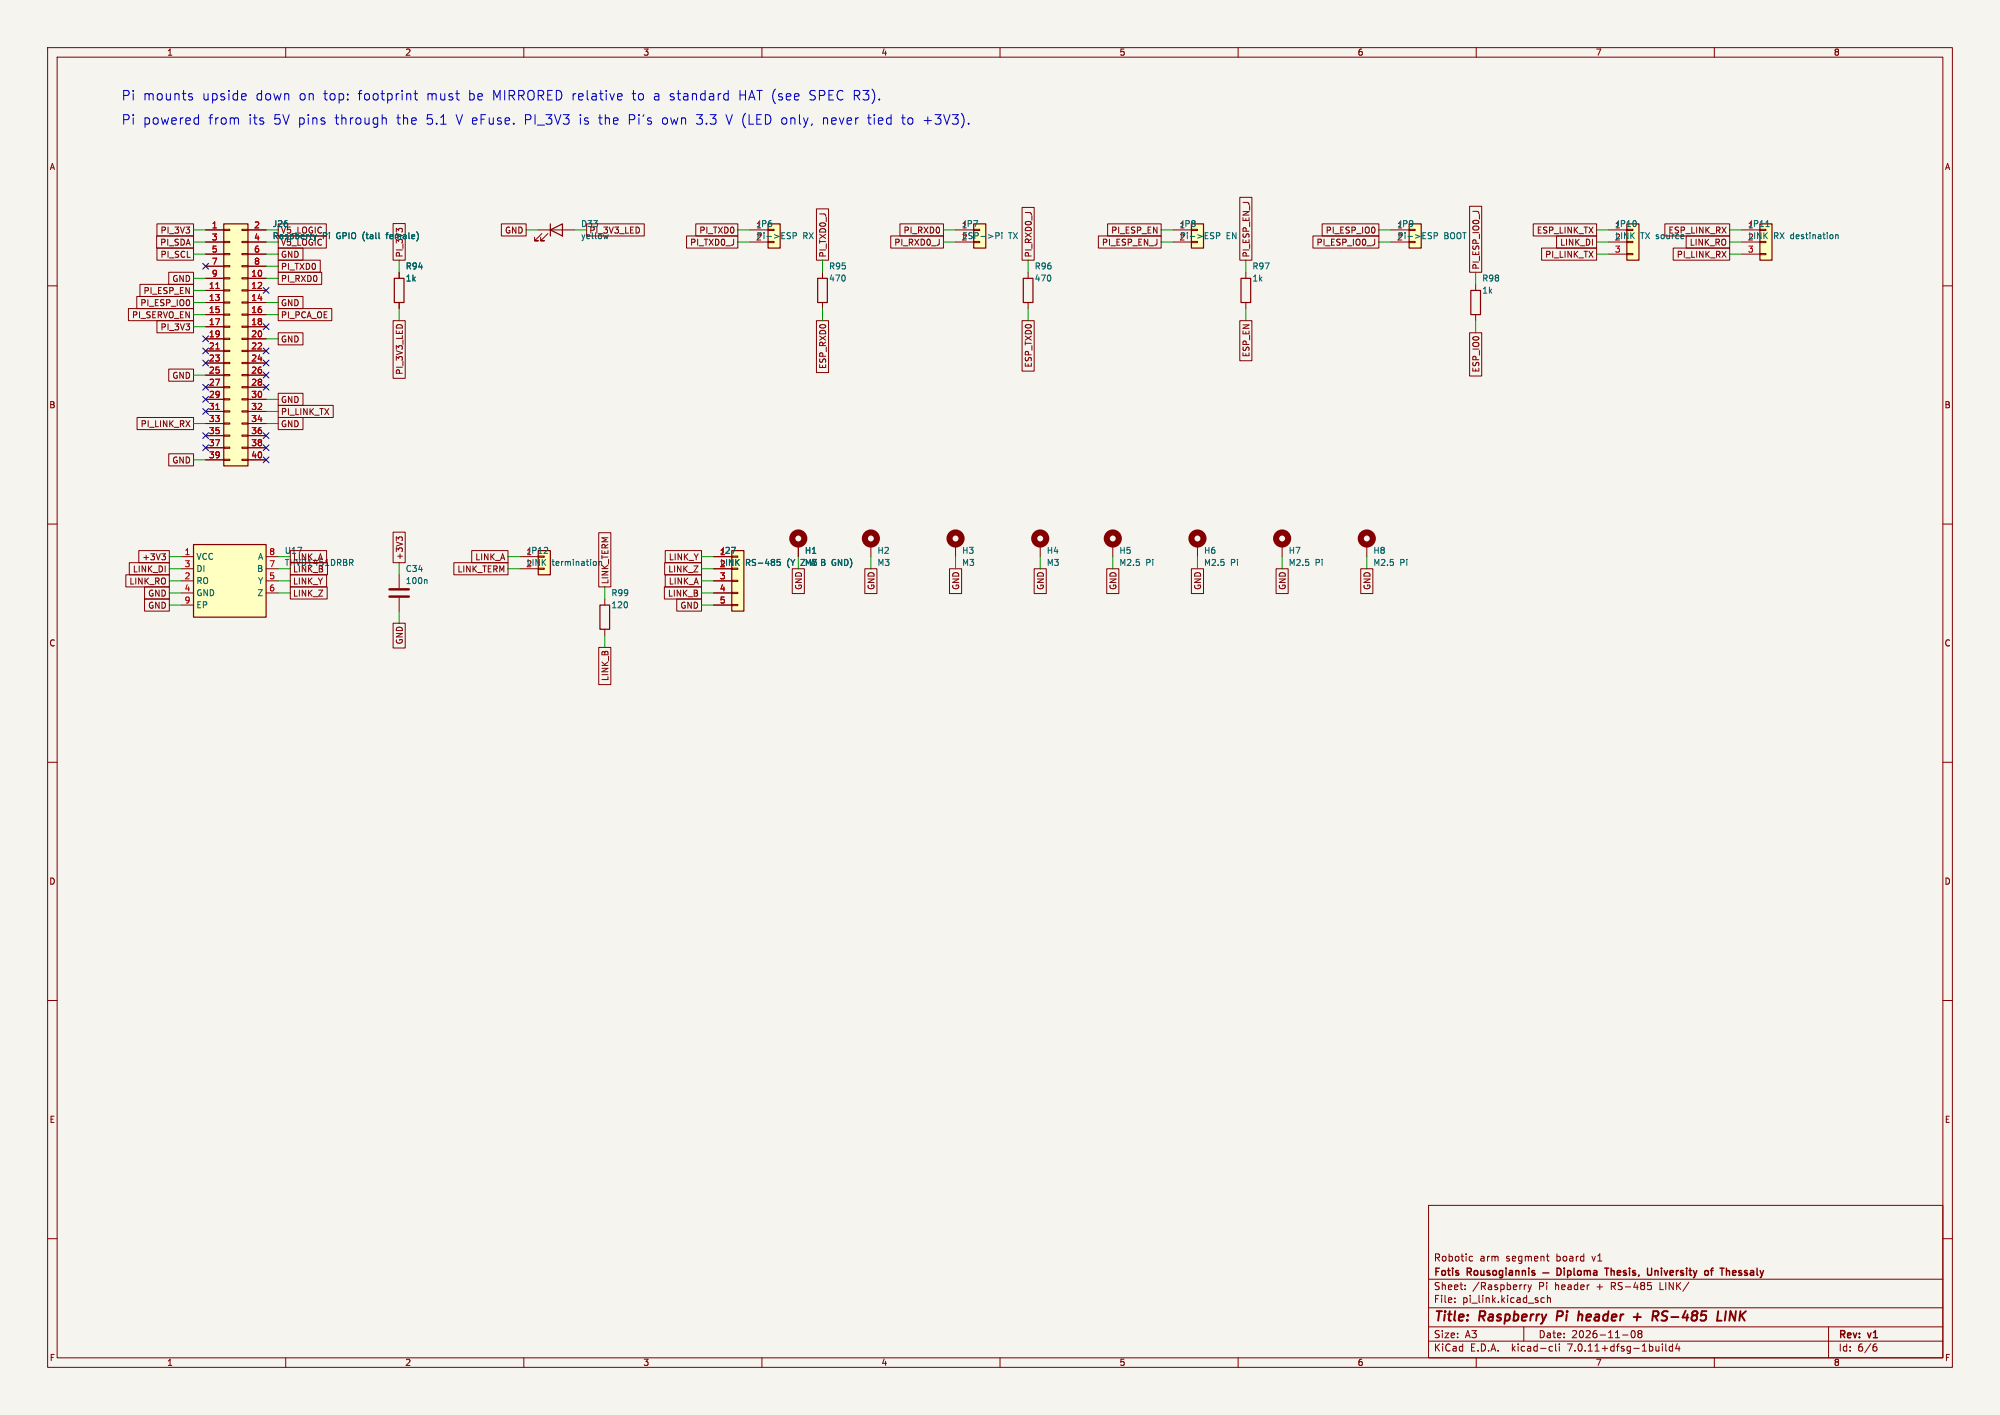
[picture p15: page 6]

V5_LOGIC Pi powered from its 5V pins through the 5.1 V eFuse. PI_3V3 is the Pi's own 3.3 V (LED only, never tied to +3V3).
