FotisRousogiannis/Master-s-Thesis/hardware/pcb/segment_board/sim/cir/touch_step.cir

* touch_step

* SS54 Schottky, 5 A (approx.: ~0.37 V at 0.8 A, ~0.47 V at 4 A)
.model SS54 D(Is=1e-5 N=1.05 Rs=0.025 Cjo=300p)
* 0603 LEDs: InGaN green (~2.6 V @ 1 mA) and AlInGaP yellow-green / yellow (~1.9 V @ 1 mA)
.model LED_GREEN_INGAN D(Is=1e-22 N=2.2 Rs=10)
.model LED_YG D(Is=1e-18 N=2.0 Rs=8)
* open-collector output stage of one LM339 unit: switch on when V(-) > V(+) + offset
.model OC SW(Vt=0 Vh=0.0001 Ron=40 Roff=1e9)


V1 3v3 0 3.3
Vp p 0 PULSE(0 1 1m 1u 1u 20m 40m)
Rsens 3v3 touch 17k
Rp 3v3 x 2.43k
Sp x touch p 0 PSW
.model PSW SW(Vt=0.5 Ron=1 Roff=1e12)
Rdiv touch 0 6.8k
Cf touch 0 100n

.control
set wr_singlescale
set wr_vecnames
tran 10u 40m
wrdata /home/user/master-s-thesis/hardware/pcb/segment_board/sim/results/touch_step.dat v(touch)
quit
.endc
.end
