FotisRousogiannis/Master-s-Thesis/hardware/pcb/segment_board/segment_board.kicad_pcb

## KiCad design hardware/pcb/segment_board/segment_board.kicad_pcb (2026-11-08)

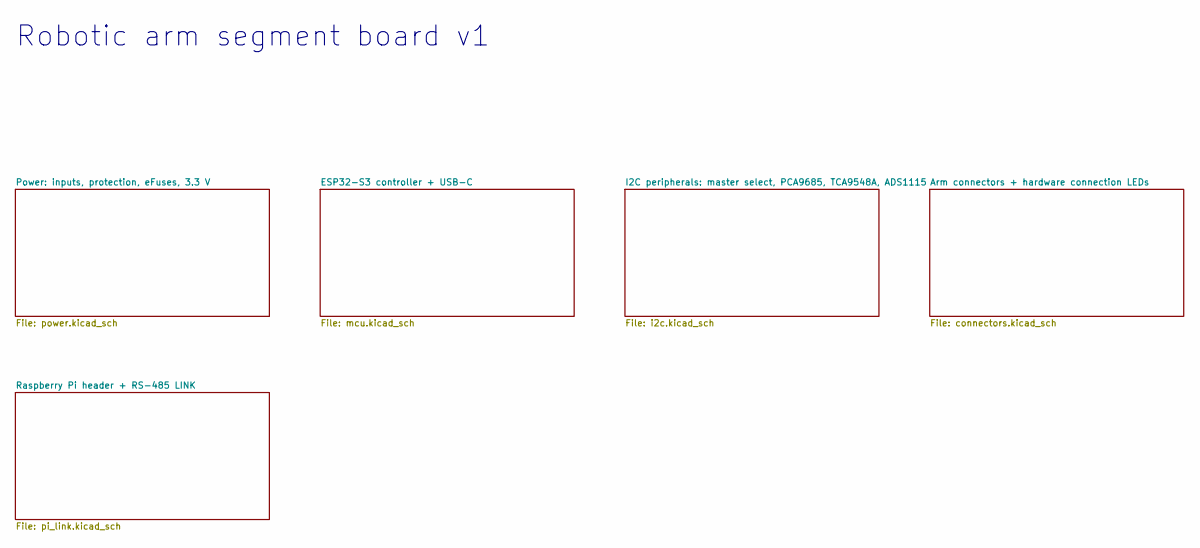
[picture p16: schematic segment_board.kicad_sch, Robotic arm segment board v1]

Notes on the sheet:
Robotic arm segment board v1

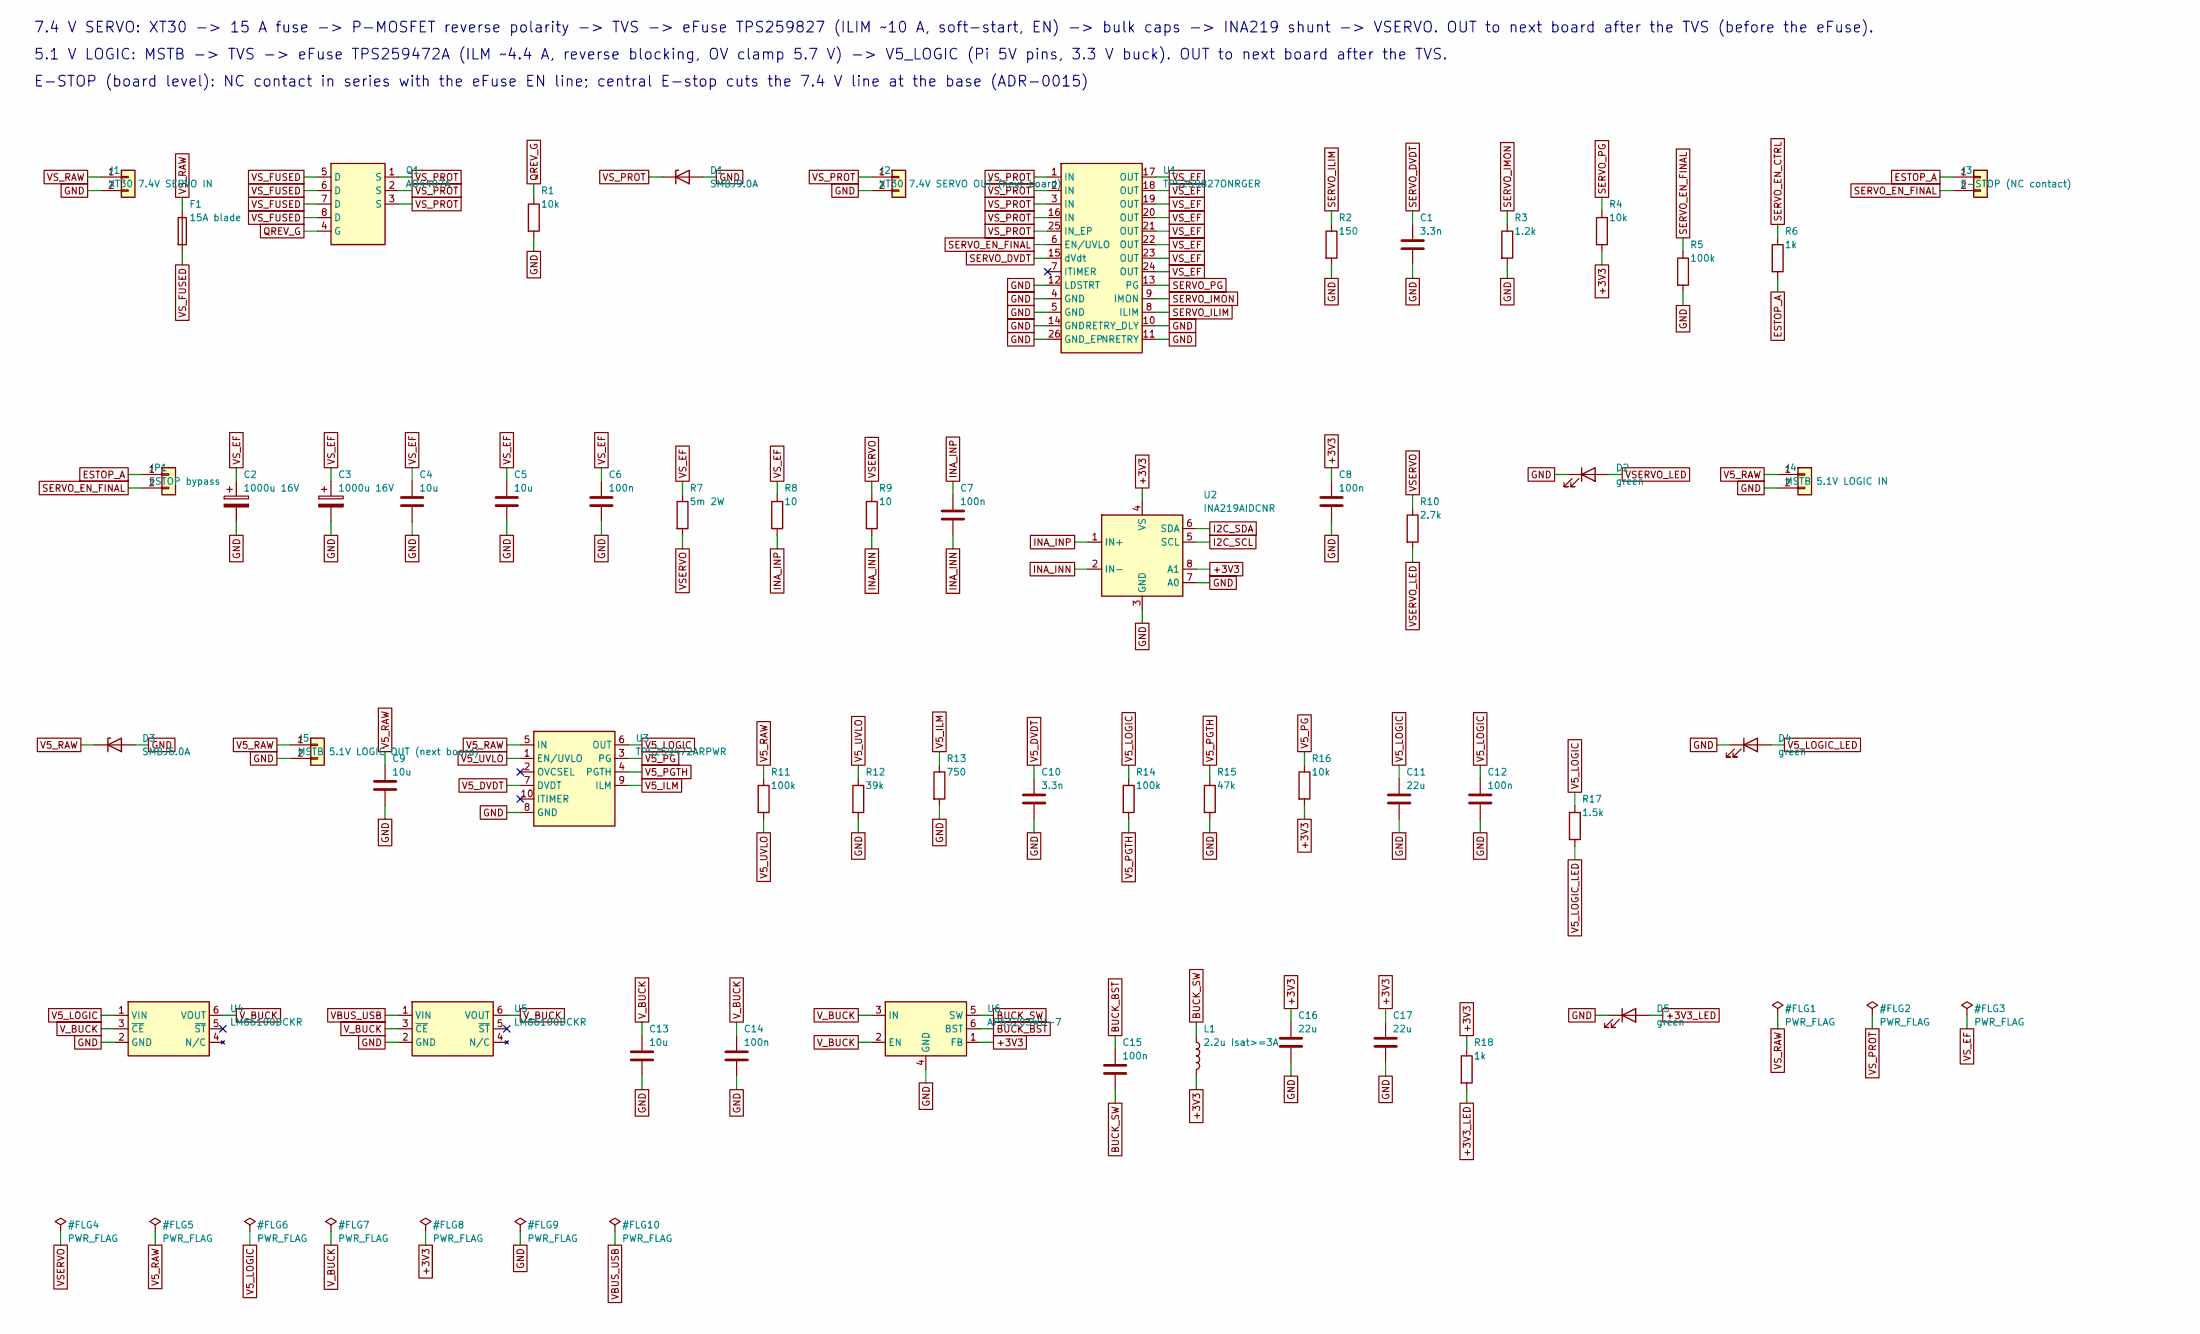
[picture p17: schematic power.kicad_sch, Power: inputs, protection, eFuses, 3.3 V]

Parts:
C1, C10: 3.3n; C_0603_1608Metric; LCSC C1613
C2, C3: 1000u 16V; CP_Radial_D10.0mm_P5.00mm; LCSC C88777
C4, C5, C9, C13: 10u; C_0805_2012Metric; LCSC C15850
C6, C7, C8, C12, C14, C15: 100n; C_0603_1608Metric; LCSC C14663
C11, C16, C17: 22u; C_0805_2012Metric; LCSC C45783
D1: SMBJ9.0A; D_SMB; LCSC C152088
D2, D4, D5: green; LED_0603_1608Metric; LCSC C2986030
D3: SMBJ6.0A; D_SMB; LCSC C19077560
F1: 15A blade; Fuseholder_Blade_Mini_Keystone_3568
J1: XT30 7.4V SERVO IN; AMASS_XT30PW-M_1x02_P2.50mm_Horizontal
J2: XT30 7.4V SERVO OUT (next board); AMASS_XT30UPB-F_1x02_P5.0mm_Vertical
J3: E-STOP (NC contact); PhoenixContact_MCV_1,5_2-G-3.5_1x02_P3.50mm_Vertical
J4: MSTB 5.1V LOGIC IN; PhoenixContact_MSTBVA_2,5_2-G-5,08_1x02_P5.08mm_Vertical
J5: MSTB 5.1V LOGIC OUT (next board); PhoenixContact_MSTBVA_2,5_2-G-5,08_1x02_P5.08mm_Vertical
JP1: ESTOP bypass; PinHeader_1x02_P2.54mm_Vertical
L1: 2.2u Isat>=3A; L_4x4mm_SMNR4020; LCSC C135262
Q1: AO4407A; SOIC-8_3.9x4.9mm_P1.27mm; LCSC C16072
R1, R4, R16: 10k; R_0603_1608Metric; LCSC C25804
R2: 150; R_0603_1608Metric; LCSC C22808
R3: 1.2k; R_0603_1608Metric; LCSC C22765
R5, R11, R14: 100k; R_0603_1608Metric; LCSC C25803
R6, R18: 1k; R_0603_1608Metric; LCSC C21190
R7: 5m 2W; R_2512_6332Metric; LCSC C371096
R8, R9: 10; R_0603_1608Metric; LCSC C22859
R10: 2.7k; R_0603_1608Metric; LCSC C13167
R12: 39k; R_0603_1608Metric; LCSC C23153
R13: 750; R_0603_1608Metric; LCSC C23241
R15: 47k; R_0603_1608Metric; LCSC C25819
R17: 1.5k; R_0603_1608Metric; LCSC C22843
U1: TPS259827ONRGER; TI_RGE0024_2EP; LCSC C2155761
U2: INA219AIDCNR; SOT-23-8; LCSC C87469
U3: TPS259472ARPWR; TI_RPW0010A; LCSC C3662789
U4, U5: LM66100DCKR; SOT-363_SC-70-6; LCSC C2869734
U6: AP63203WU-7; TSOT-23-6; LCSC C780769

Connections:
+3V3: C8.1, C16.1, C17.1, L1.2, R4.2, R16.2, R18.1, U2.4 (VS), U2.8 (A1), U6.1 (FB); also elsewhere on the board
+3V3_LED: D5.2 (A), R18.2
BUCK_BST: C15.1, U6.6 (BST)
BUCK_SW: C15.2, L1.1, U6.5 (SW)
ESTOP_A: J3.1, JP1.1, R6.2
GND: C1.2, C2.2, C3.2, C4.2, C5.2, C6.2, C8.2, C9.2, C10.2, C11.2, C12.2, C13.2, C14.2, C16.2, C17.2, D1.2 (A), D2.1 (K), D3.2 (A), D4.1 (K), D5.1 (K), J1.2, J2.2, J4.2, J5.2, R1.2, R2.2, R3.2, R5.2, R12.2, R13.2, R15.2, U1.4 (GND), U1.5 (GND), U1.10 (RETRY_DLY), U1.11 (NRETRY), U1.12 (LDSTRT), U1.14 (GND), U1.26 (GND_EP), U2.3 (GND), U2.7 (A0), U3.8 (GND), U4.2 (GND), U5.2 (GND), U6.4 (GND); also elsewhere on the board
I2C_SCL: U2.5 (SCL); also elsewhere on the board
I2C_SDA: U2.6 (SDA); also elsewhere on the board
INA_INN: C7.2, R9.2, U2.2 (IN-)
INA_INP: C7.1, R8.2, U2.1 (IN+)
QREV_G: Q1.4 (G), R1.1
SERVO_DVDT: C1.1, U1.15 (dVdt)
SERVO_EN_CTRL: R6.1; also elsewhere on the board
SERVO_EN_FINAL: J3.2, JP1.2, R5.1, U1.6 (EN/UVLO)
SERVO_ILIM: R2.1, U1.8 (ILIM)
SERVO_IMON: R3.1, U1.9 (IMON); also elsewhere on the board
SERVO_PG: R4.1, U1.13 (PG); also elsewhere on the board
V5_DVDT: C10.1, U3.7 (DVDT)
V5_ILM: R13.1, U3.9 (ILM)
V5_LOGIC: C11.1, C12.1, R14.1, R17.1, U3.6 (OUT), U4.1 (VIN); also elsewhere on the board
V5_LOGIC_LED: D4.2 (A), R17.2
V5_PG: R16.1, U3.3 (PG); also elsewhere on the board
V5_PGTH: R14.2, R15.1, U3.4 (PGTH)
V5_RAW: C9.1, D3.1 (K), J4.1, J5.1, R11.1, U3.5 (IN)
V5_UVLO: R11.2, R12.1, U3.1 (EN/UVLO)
VBUS_USB: U5.1 (VIN); also elsewhere on the board
VSERVO: R7.2, R9.1, R10.1; also elsewhere on the board
VSERVO_LED: D2.2 (A), R10.2
VS_EF: C2.1, C3.1, C4.1, C5.1, C6.1, R7.1, R8.1, U1.17 (OUT), U1.18 (OUT), U1.19 (OUT), U1.20 (OUT), U1.21 (OUT), U1.22 (OUT), U1.23 (OUT), U1.24 (OUT)
VS_FUSED: F1.2, Q1.5 (D), Q1.6 (D), Q1.7 (D), Q1.8 (D)
VS_PROT: D1.1 (K), J2.1, Q1.1 (S), Q1.2 (S), Q1.3 (S), U1.1 (IN), U1.2 (IN), U1.3 (IN), U1.16 (IN), U1.25 (IN_EP)
VS_RAW: F1.1, J1.1
V_BUCK: C13.1, C14.1, U4.3 (~CE), U4.6 (VOUT), U5.3 (~CE), U5.6 (VOUT), U6.2 (EN), U6.3 (IN)

Notes on the sheet:
7.4 V SERVO: XT30 -> 15 A fuse -> P-MOSFET reverse polarity -> TVS -> eFuse TPS259827 (ILIM ~10 A, soft-start, EN) -> bulk caps -> INA219 shunt -> VSERVO. OUT to next board after the TVS (before the eFuse).
5.1 V LOGIC: MSTB -> TVS -> eFuse TPS259472A (ILM ~4.4 A, reverse blocking, OV clamp 5.7 V) -> V5_LOGIC (Pi 5V pins, 3.3 V buck). OUT to next board after the TVS.
E-STOP (board level): NC contact in series with the eFuse EN line; central E-stop cuts the 7.4 V line at the base (ADR-0015)

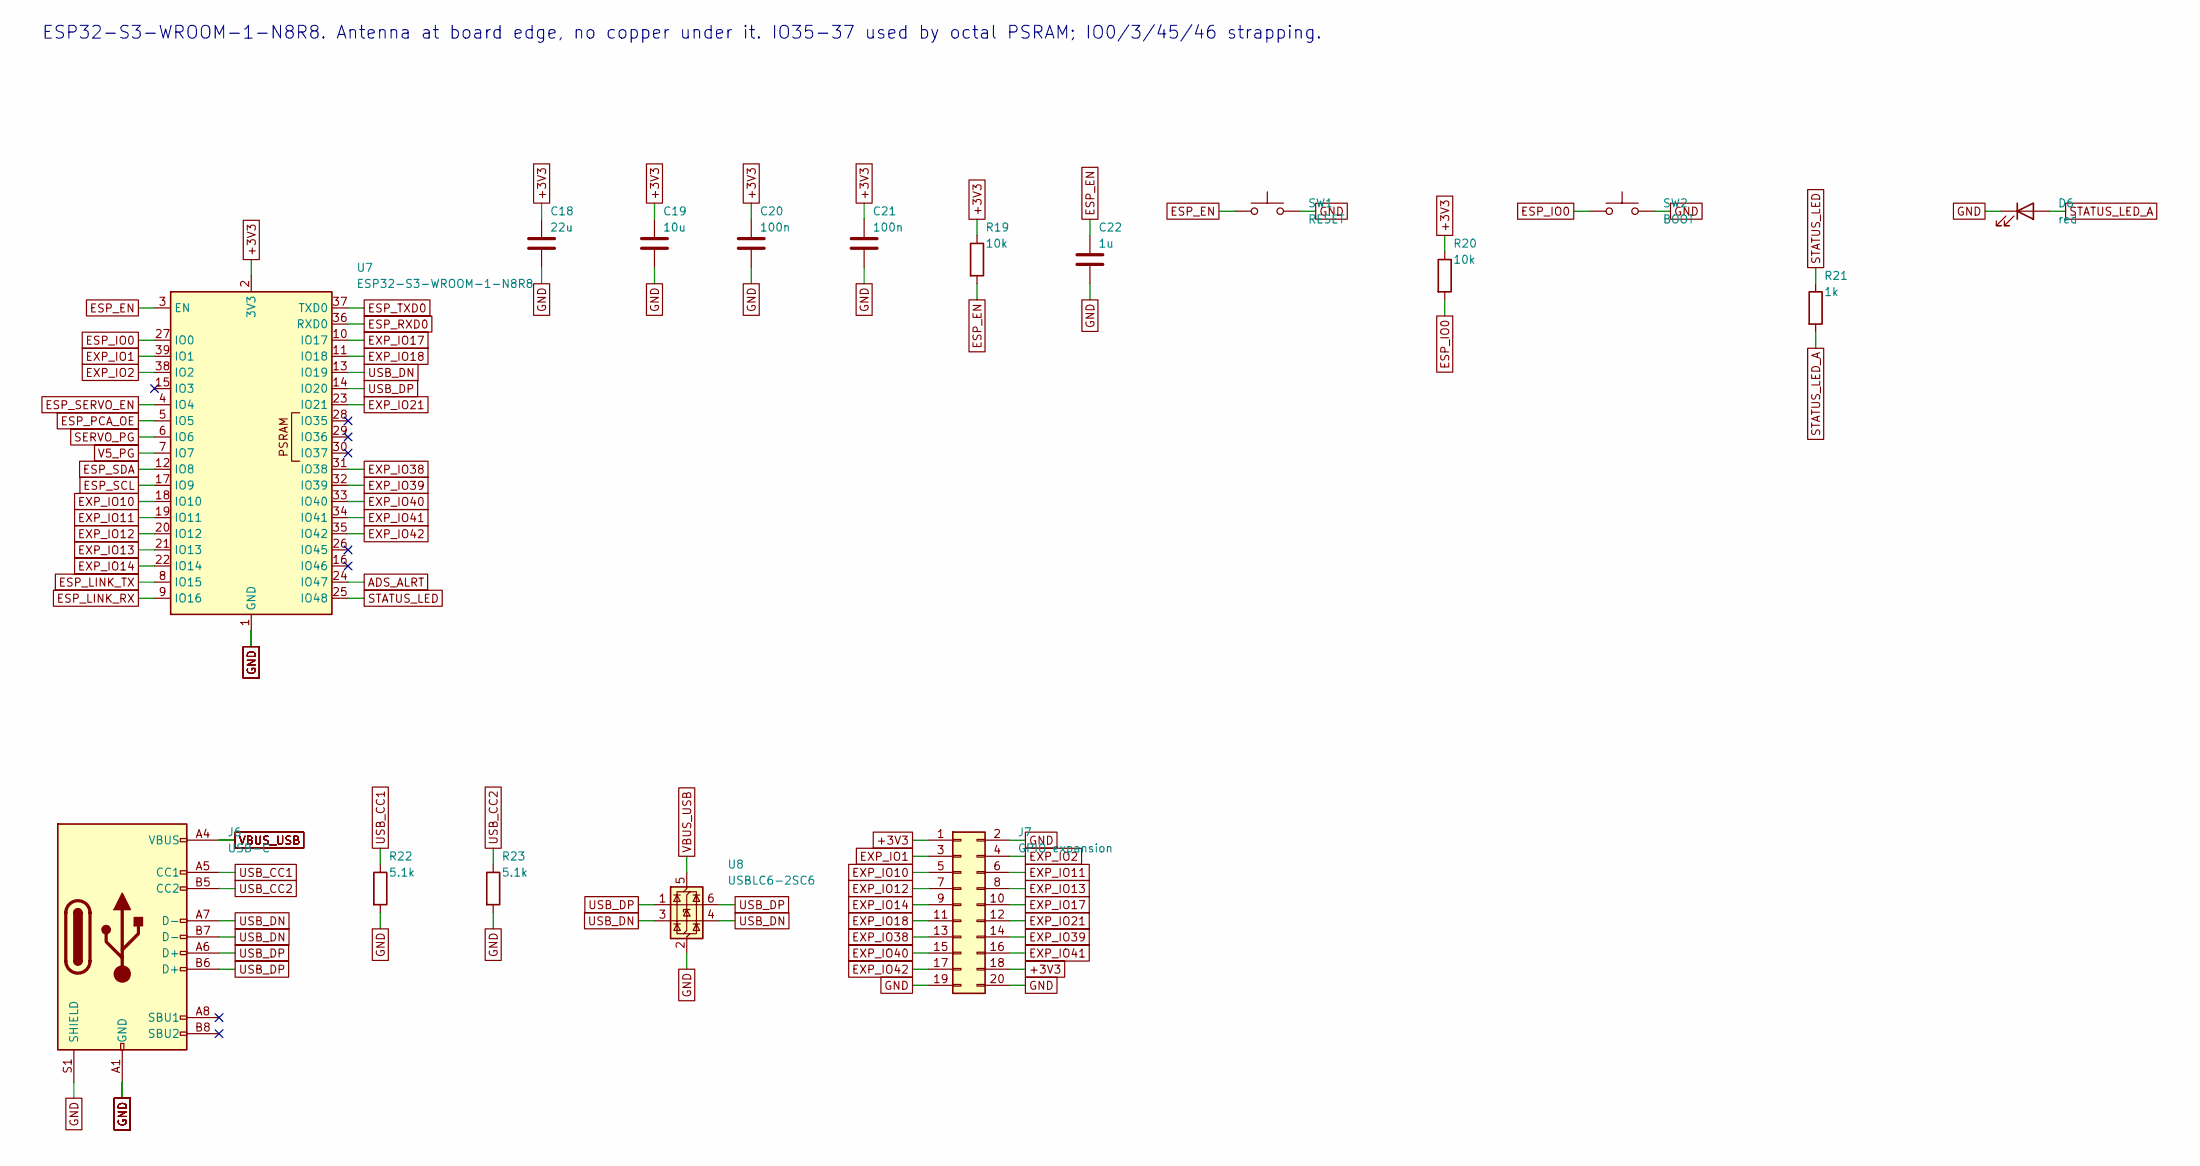
[picture p18: schematic mcu.kicad_sch, ESP32-S3 controller + USB-C]

Parts:
C18: 22u; C_0805_2012Metric; LCSC C45783
C19: 10u; C_0805_2012Metric; LCSC C15850
C20, C21: 100n; C_0603_1608Metric; LCSC C14663
C22: 1u; C_0603_1608Metric; LCSC C15849
D6: red; LED_0603_1608Metric; LCSC C2986060
J6: USB-C; USB_C_Receptacle_HRO_TYPE-C-31-M-12; LCSC C165948
J7: GPIO expansion; PinHeader_2x10_P2.54mm_Vertical
R19, R20: 10k; R_0603_1608Metric; LCSC C25804
R21: 1k; R_0603_1608Metric; LCSC C21190
R22, R23: 5.1k; R_0603_1608Metric; LCSC C23186
SW1: RESET; SW_SPST_TL3342; LCSC C2886897
SW2: BOOT; SW_SPST_TL3342; LCSC C2886897
U7: ESP32-S3-WROOM-1-N8R8; ESP32-S3-WROOM-1; LCSC C2913201
U8: USBLC6-2SC6; SOT-23-6; LCSC C7519

Connections:
+3V3: C18.1, C19.1, C20.1, C21.1, J7.1, J7.18, R19.1, R20.1, U7.2 (3V3); also elsewhere on the board
ADS_ALRT: U7.24 (IO47); also elsewhere on the board
ESP_EN: C22.1, R19.2, SW1.1, U7.3 (EN); also elsewhere on the board
ESP_IO0: R20.2, SW2.1, U7.27 (IO0); also elsewhere on the board
ESP_LINK_RX: U7.9 (IO16); also elsewhere on the board
ESP_LINK_TX: U7.8 (IO15); also elsewhere on the board
ESP_PCA_OE: U7.5 (IO5); also elsewhere on the board
ESP_RXD0: U7.36 (RXD0); also elsewhere on the board
ESP_SCL: U7.17 (IO9); also elsewhere on the board
ESP_SDA: U7.12 (IO8); also elsewhere on the board
ESP_SERVO_EN: U7.4 (IO4); also elsewhere on the board
ESP_TXD0: U7.37 (TXD0); also elsewhere on the board
EXP_IO1: J7.3, U7.39 (IO1)
EXP_IO2: J7.4, U7.38 (IO2)
EXP_IO10: J7.5, U7.18 (IO10)
EXP_IO11: J7.6, U7.19 (IO11)
EXP_IO12: J7.7, U7.20 (IO12)
EXP_IO13: J7.8, U7.21 (IO13)
EXP_IO14: J7.9, U7.22 (IO14)
EXP_IO17: J7.10, U7.10 (IO17)
EXP_IO18: J7.11, U7.11 (IO18)
EXP_IO21: J7.12, U7.23 (IO21)
EXP_IO38: J7.13, U7.31 (IO38)
EXP_IO39: J7.14, U7.32 (IO39)
EXP_IO40: J7.15, U7.33 (IO40)
EXP_IO41: J7.16, U7.34 (IO41)
EXP_IO42: J7.17, U7.35 (IO42)
GND: C18.2, C19.2, C20.2, C21.2, C22.2, D6.1 (K), J6.A1 (GND_A1), J6.A12 (GND_A12), J6.B1 (GND_B1), J6.B12 (GND_B12), J6.S1 (SHIELD), J6.SH (SHIELD_S1), J7.2, J7.19, J7.20, R22.2, R23.2, SW1.2, SW2.2, U7.1 (GND), U7.40 (GND), U7.41 (GND), U8.2 (GND); also elsewhere on the board
SERVO_PG: U7.6 (IO6); also elsewhere on the board
STATUS_LED: R21.1, U7.25 (IO48)
STATUS_LED_A: D6.2 (A), R21.2
USB_CC1: J6.A5 (CC1_A5), R22.1
USB_CC2: J6.B5 (CC2_B5), R23.1
USB_DN: J6.A7 (D-_A7), J6.B7 (D-_B7), U7.13 (IO19), U8.3 (I/O2), U8.4 (I/O2)
USB_DP: J6.A6 (D+_A6), J6.B6 (D+_B6), U7.14 (IO20), U8.1 (I/O1), U8.6 (I/O1)
V5_PG: U7.7 (IO7); also elsewhere on the board
VBUS_USB: J6.A4 (VBUS_A4), J6.A9 (VBUS_A9), J6.B4 (VBUS_B4), J6.B9 (VBUS_B9), U8.5 (VBUS); also elsewhere on the board

Notes on the sheet:
ESP32-S3-WROOM-1-N8R8. Antenna at board edge, no copper under it. IO35-37 used by octal PSRAM; IO0/3/45/46 strapping.

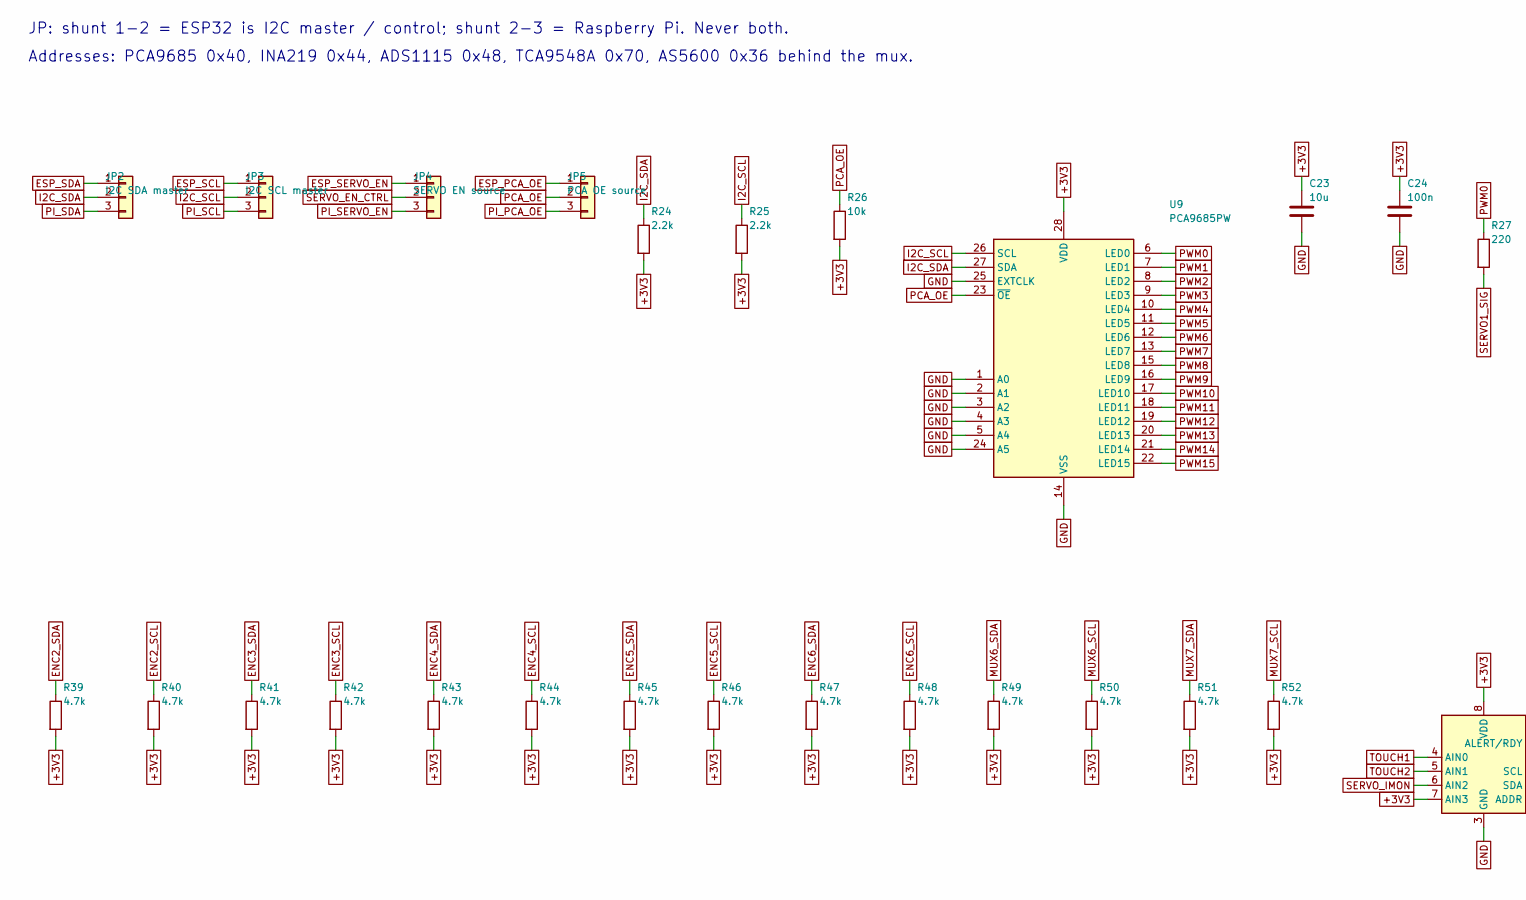
[picture p19: schematic i2c.kicad_sch, I2C peripherals: master select, PCA9685, TCA9548A, ADS1115, part in row 1, column 1]

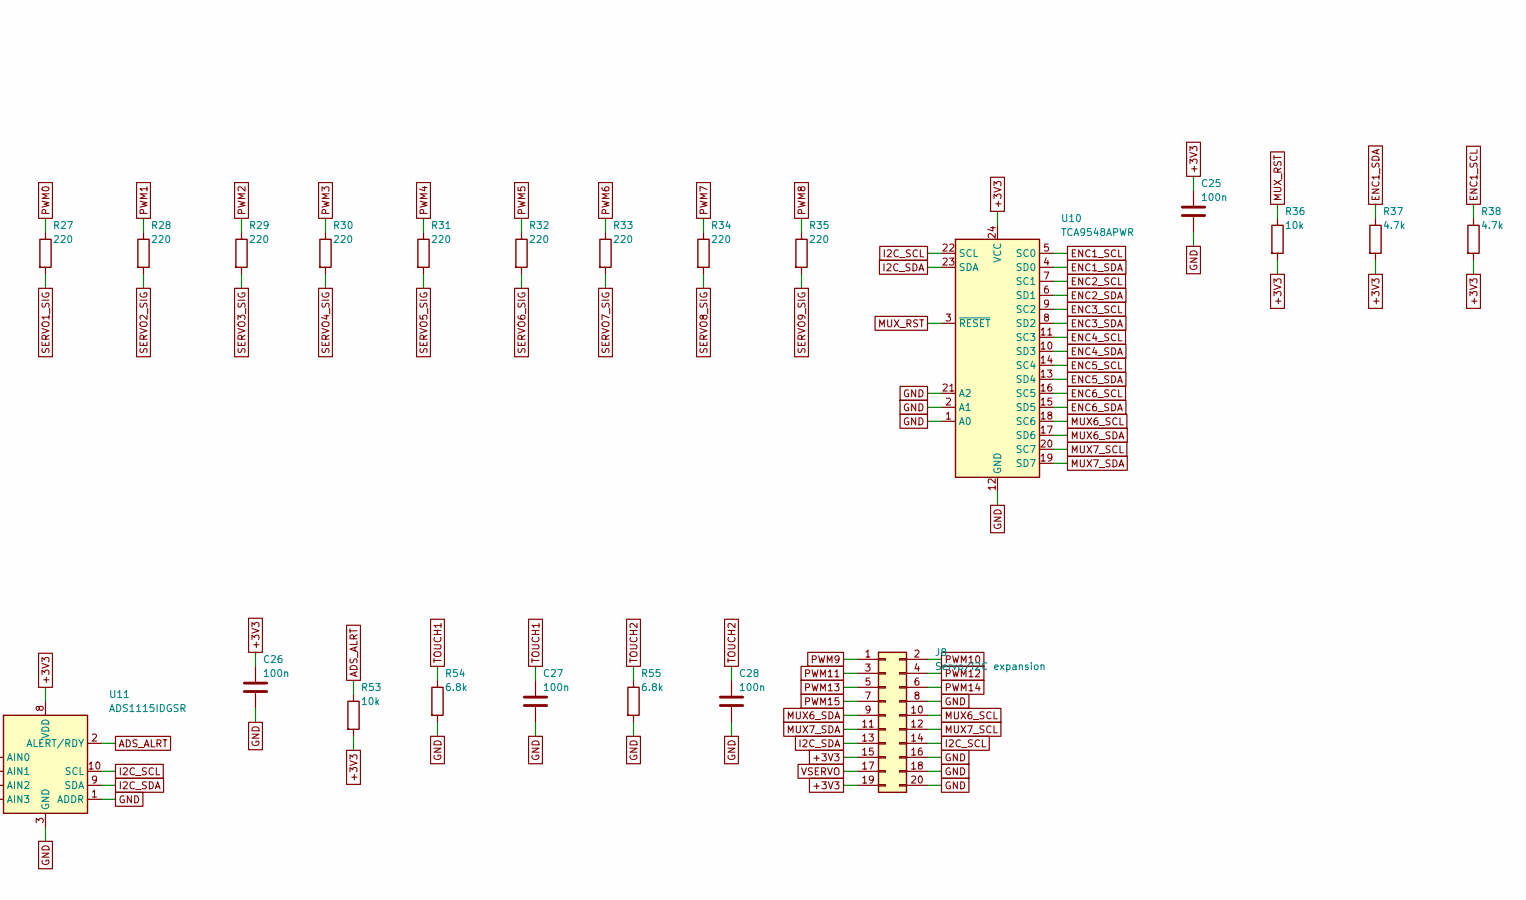
[picture p20: schematic i2c.kicad_sch, I2C peripherals: master select, PCA9685, TCA9548A, ADS1115, part in row 1, column 2]

Parts:
C23: 10u; C_0805_2012Metric; LCSC C15850
C24, C25, C26, C27, C28: 100n; C_0603_1608Metric; LCSC C14663
J8: Servo/I2C expansion; PinHeader_2x10_P2.54mm_Vertical
JP2: I2C SDA master; PinHeader_1x03_P2.54mm_Vertical
JP3: I2C SCL master; PinHeader_1x03_P2.54mm_Vertical
JP4: SERVO EN source; PinHeader_1x03_P2.54mm_Vertical
JP5: PCA OE source; PinHeader_1x03_P2.54mm_Vertical
R24, R25: 2.2k; R_0603_1608Metric; LCSC C4190
R26, R36, R53: 10k; R_0603_1608Metric; LCSC C25804
R27, R28, R29, R30, R31, R32, R33, R34, R35: 220; R_0603_1608Metric; LCSC C22962
R37, R38, R39, R40, R41, R42, R43, R44, R45, R46, R47, R48, R49, R50, R51, R52: 4.7k; R_0603_1608Metric; LCSC C23162
R54, R55: 6.8k; R_0603_1608Metric; LCSC C23212
U9: PCA9685PW; TSSOP-28_4.4x9.7mm_P0.65mm; LCSC C2678753
U10: TCA9548APWR; TSSOP-24_4.4x7.8mm_P0.65mm; LCSC C130026
U11: ADS1115IDGSR; VSSOP-10_3x3mm_P0.5mm; LCSC C37593

Connections:
+3V3: C23.1, C24.1, C25.1, C26.1, J8.15, J8.19, R24.2, R25.2, R26.2, R36.2, R37.2, R38.2, R39.2, R40.2, R41.2, R42.2, R43.2, R44.2, R45.2, R46.2, R47.2, R48.2, R49.2, R50.2, R51.2, R52.2, R53.2, U9.28 (VDD), U10.24 (VCC), U11.7 (AIN3), U11.8 (VDD); also elsewhere on the board
ADS_ALRT: R53.1, U11.2 (ALERT/RDY); also elsewhere on the board
ENC1_SCL: R38.1, U10.5 (SC0); also elsewhere on the board
ENC1_SDA: R37.1, U10.4 (SD0); also elsewhere on the board
ENC2_SCL: R40.1, U10.7 (SC1); also elsewhere on the board
ENC2_SDA: R39.1, U10.6 (SD1); also elsewhere on the board
ENC3_SCL: R42.1, U10.9 (SC2); also elsewhere on the board
ENC3_SDA: R41.1, U10.8 (SD2); also elsewhere on the board
ENC4_SCL: R44.1, U10.11 (SC3); also elsewhere on the board
ENC4_SDA: R43.1, U10.10 (SD3); also elsewhere on the board
ENC5_SCL: R46.1, U10.14 (SC4); also elsewhere on the board
ENC5_SDA: R45.1, U10.13 (SD4); also elsewhere on the board
ENC6_SCL: R48.1, U10.16 (SC5); also elsewhere on the board
ENC6_SDA: R47.1, U10.15 (SD5); also elsewhere on the board
ESP_PCA_OE: JP5.1; also elsewhere on the board
ESP_SCL: JP3.1; also elsewhere on the board
ESP_SDA: JP2.1; also elsewhere on the board
ESP_SERVO_EN: JP4.1; also elsewhere on the board
GND: C23.2, C24.2, C25.2, C26.2, C27.2, C28.2, J8.8, J8.16, J8.18, J8.20, R54.2, R55.2, U9.1 (A0), U9.2 (A1), U9.3 (A2), U9.4 (A3), U9.5 (A4), U9.14 (VSS), U9.24 (A5), U9.25 (EXTCLK), U10.1 (A0), U10.2 (A1), U10.12 (GND), U10.21 (A2), U11.1 (ADDR), U11.3 (GND); also elsewhere on the board
I2C_SCL: J8.14, JP3.2, R25.1, U9.26 (SCL), U10.22 (SCL), U11.10 (SCL); also elsewhere on the board
I2C_SDA: J8.13, JP2.2, R24.1, U9.27 (SDA), U10.23 (SDA), U11.9 (SDA); also elsewhere on the board
MUX6_SCL: J8.10, R50.1, U10.18 (SC6)
MUX6_SDA: J8.9, R49.1, U10.17 (SD6)
MUX7_SCL: J8.12, R52.1, U10.20 (SC7)
MUX7_SDA: J8.11, R51.1, U10.19 (SD7)
MUX_RST: R36.1, U10.3 (~RESET)
PCA_OE: JP5.2, R26.1, U9.23 (~OE)
PI_PCA_OE: JP5.3; also elsewhere on the board
PI_SCL: JP3.3; also elsewhere on the board
PI_SDA: JP2.3; also elsewhere on the board
PI_SERVO_EN: JP4.3; also elsewhere on the board
PWM0: R27.1, U9.6 (LED0)
PWM1: R28.1, U9.7 (LED1)
PWM2: R29.1, U9.8 (LED2)
PWM3: R30.1, U9.9 (LED3)
PWM4: R31.1, U9.10 (LED4)
PWM5: R32.1, U9.11 (LED5)
PWM6: R33.1, U9.12 (LED6)
PWM7: R34.1, U9.13 (LED7)
PWM8: R35.1, U9.15 (LED8)
PWM9: J8.1, U9.16 (LED9)
PWM10: J8.2, U9.17 (LED10)
PWM11: J8.3, U9.18 (LED11)
PWM12: J8.4, U9.19 (LED12)
PWM13: J8.5, U9.20 (LED13)
PWM14: J8.6, U9.21 (LED14)
PWM15: J8.7, U9.22 (LED15)
SERVO1_SIG: R27.2; also elsewhere on the board
SERVO2_SIG: R28.2; also elsewhere on the board
SERVO3_SIG: R29.2; also elsewhere on the board
SERVO4_SIG: R30.2; also elsewhere on the board
SERVO5_SIG: R31.2; also elsewhere on the board
SERVO6_SIG: R32.2; also elsewhere on the board
SERVO7_SIG: R33.2; also elsewhere on the board
SERVO8_SIG: R34.2; also elsewhere on the board
SERVO9_SIG: R35.2; also elsewhere on the board
SERVO_EN_CTRL: JP4.2; also elsewhere on the board
SERVO_IMON: U11.6 (AIN2); also elsewhere on the board
TOUCH1: C27.1, R54.1, U11.4 (AIN0); also elsewhere on the board
TOUCH2: C28.1, R55.1, U11.5 (AIN1); also elsewhere on the board
VSERVO: J8.17; also elsewhere on the board

Notes on the sheet:
JP: shunt 1-2 = ESP32 is I2C master / control; shunt 2-3 = Raspberry Pi. Never both.
Addresses: PCA9685 0x40, INA219 0x44, ADS1115 0x48, TCA9548A 0x70, AS5600 0x36 behind the mux.
