FotisRousogiannis/Master-s-Thesis/hardware/pcb/segment_board/segment_board.kicad_pcb

## KiCad design hardware/pcb/segment_board/segment_board.kicad_pcb (continued)

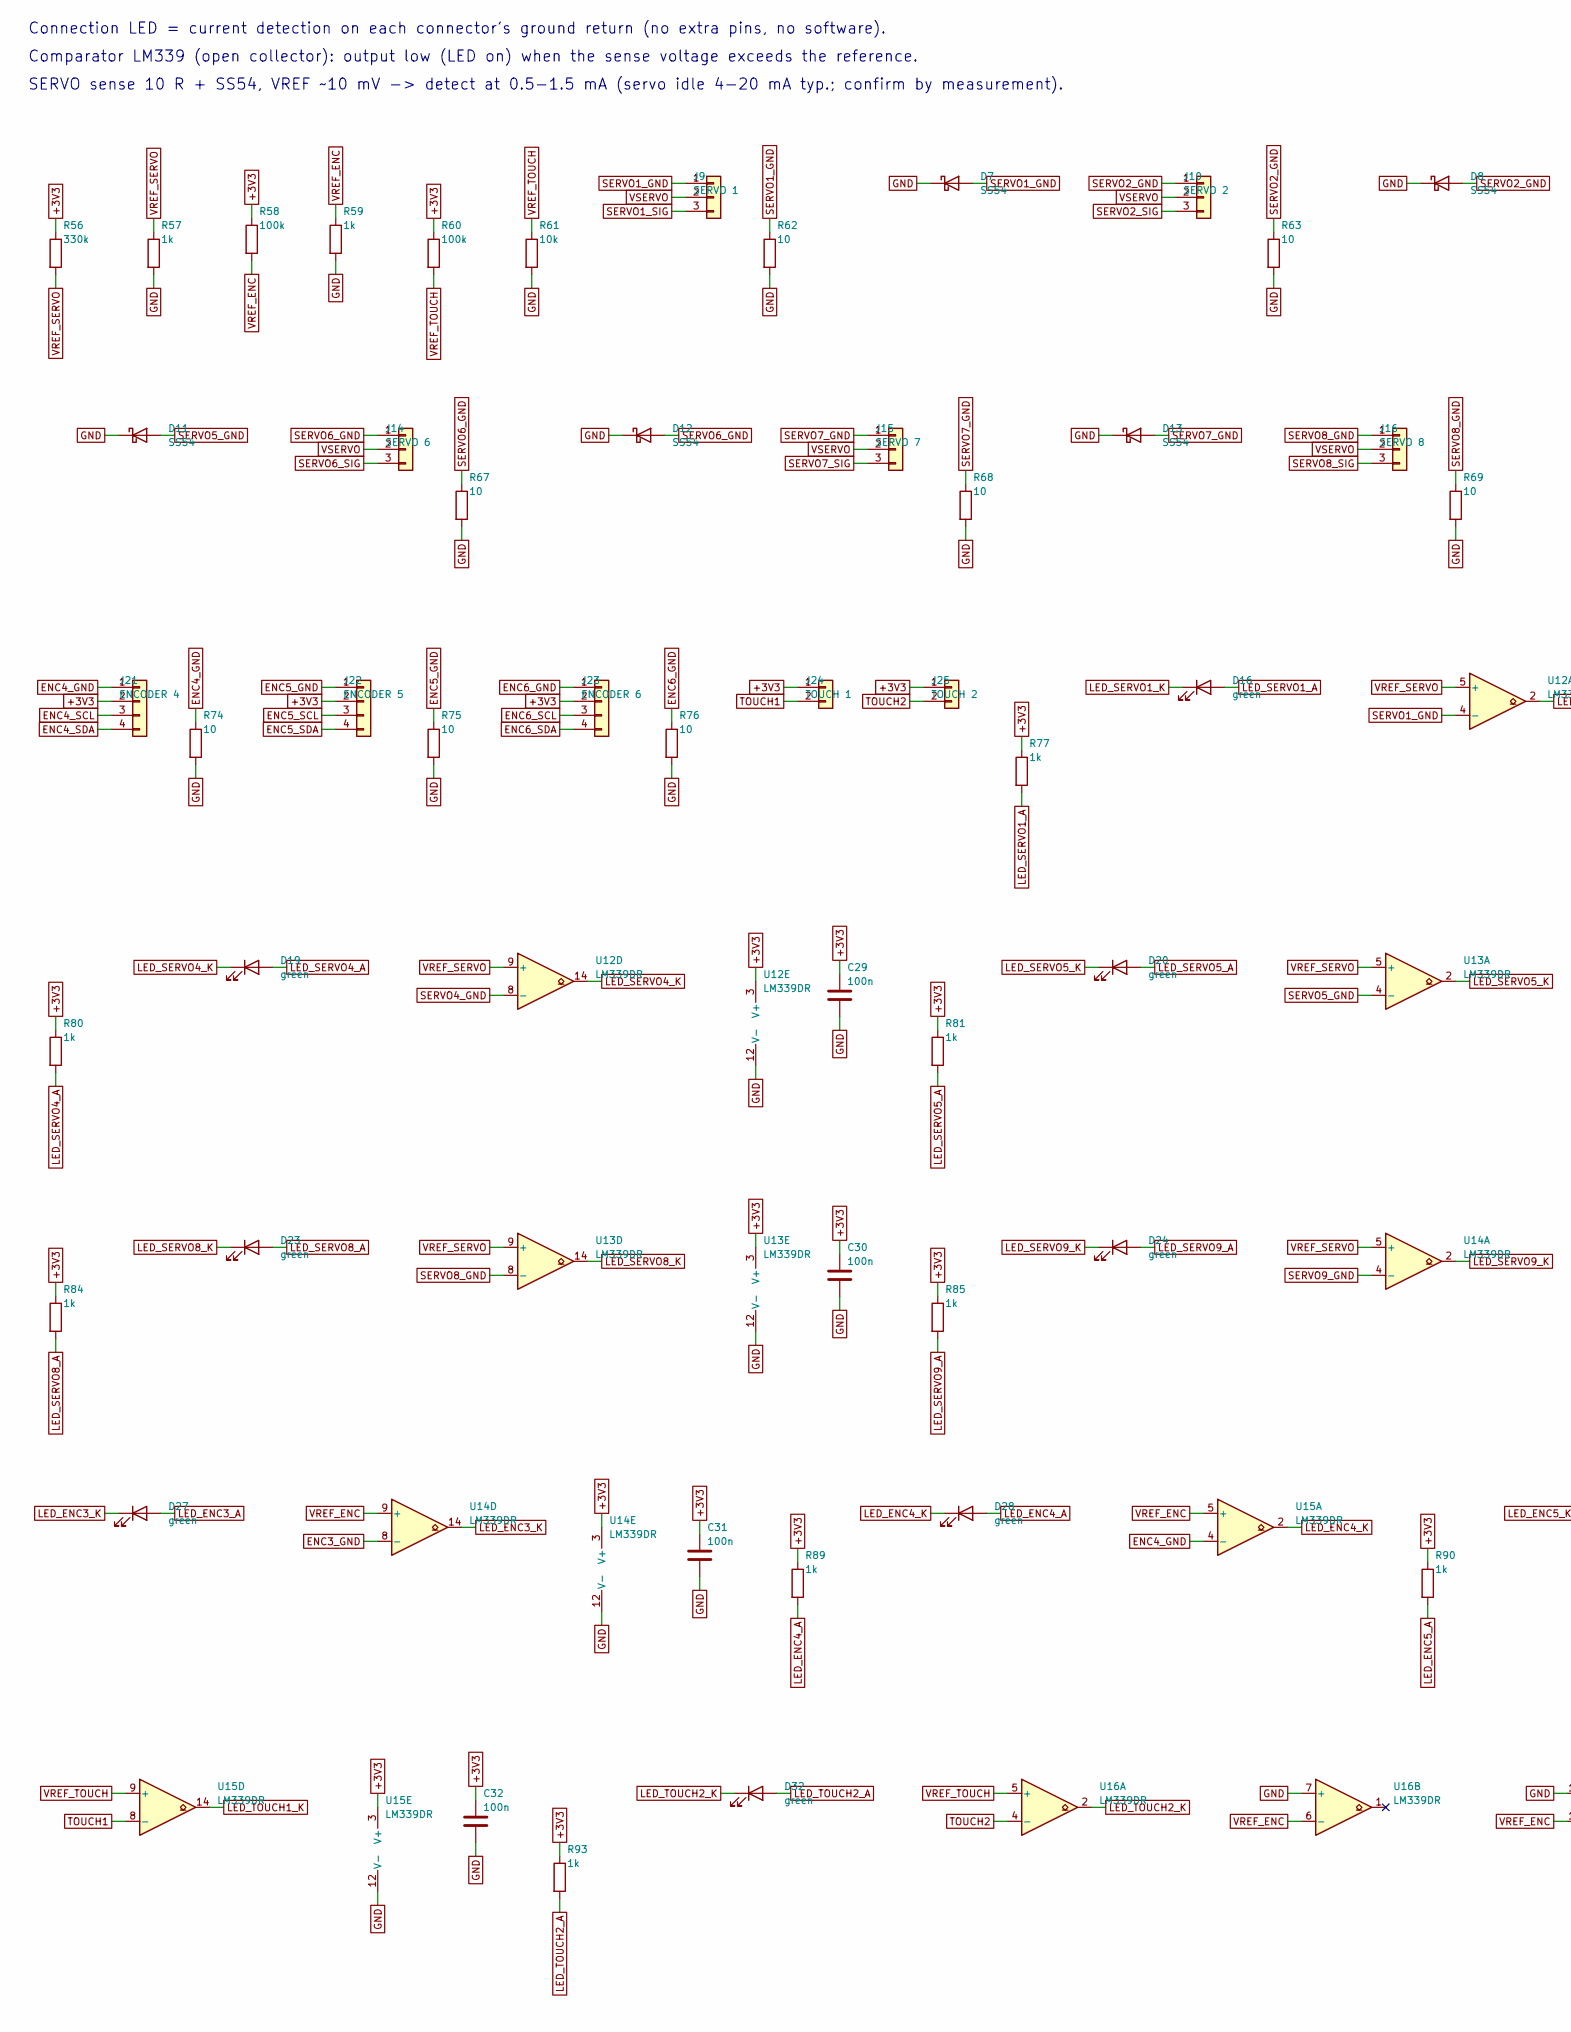
[picture p21: schematic connectors.kicad_sch, Arm connectors + hardware connection LEDs, part in row 1, column 1]

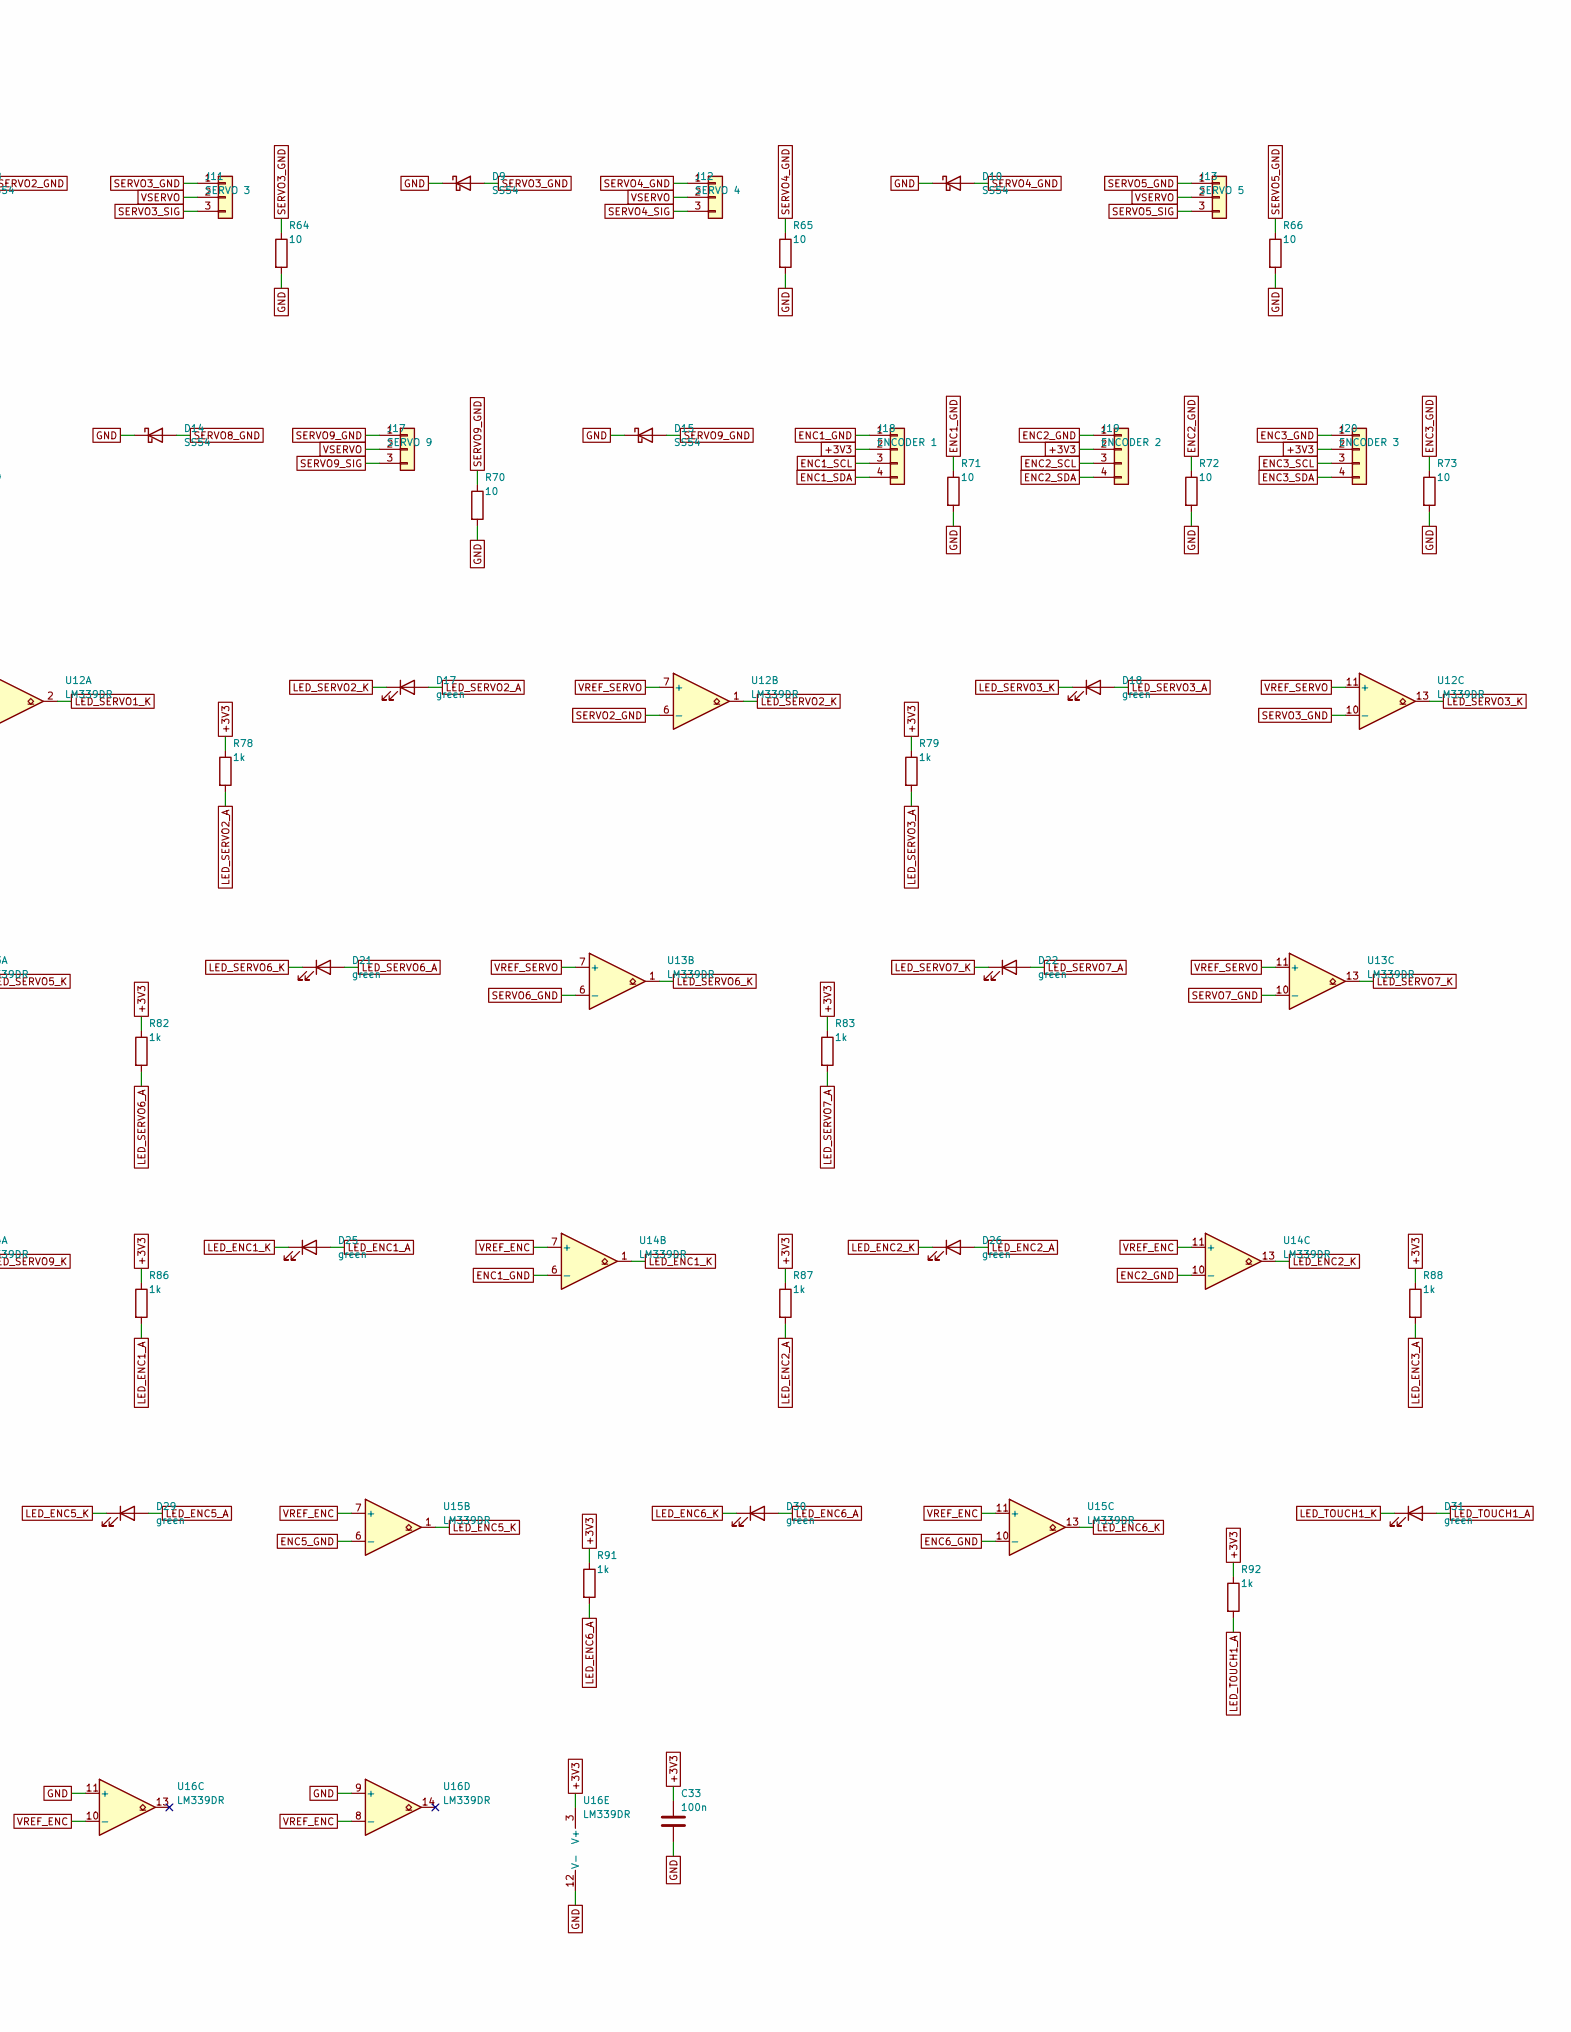
[picture p22: schematic connectors.kicad_sch, Arm connectors + hardware connection LEDs, part in row 1, column 2]

Parts:
C29, C30, C31, C32, C33: 100n; C_0603_1608Metric; LCSC C14663
D7, D8, D9, D10, D11, D12, D13, D14, D15: SS54; D_SMA; LCSC C22452
D16, D17, D18, D19, D20, D21, D22, D23, D24, D25, D26, D27, D28, D29, D30, D31, D32: green; LED_0603_1608Metric; LCSC C2986030
J9: SERVO 1; PhoenixContact_MCV_1,5_3-G-3.5_1x03_P3.50mm_Vertical
J10: SERVO 2; PhoenixContact_MCV_1,5_3-G-3.5_1x03_P3.50mm_Vertical
J11: SERVO 3; PhoenixContact_MCV_1,5_3-G-3.5_1x03_P3.50mm_Vertical
J12: SERVO 4; PhoenixContact_MCV_1,5_3-G-3.5_1x03_P3.50mm_Vertical
J13: SERVO 5; PhoenixContact_MCV_1,5_3-G-3.5_1x03_P3.50mm_Vertical
J14: SERVO 6; PhoenixContact_MCV_1,5_3-G-3.5_1x03_P3.50mm_Vertical
J15: SERVO 7; PhoenixContact_MCV_1,5_3-G-3.5_1x03_P3.50mm_Vertical
J16: SERVO 8; PhoenixContact_MCV_1,5_3-G-3.5_1x03_P3.50mm_Vertical
J17: SERVO 9; PhoenixContact_MCV_1,5_3-G-3.5_1x03_P3.50mm_Vertical
J18: ENCODER 1; PhoenixContact_MCV_1,5_4-G-3.5_1x04_P3.50mm_Vertical
J19: ENCODER 2; PhoenixContact_MCV_1,5_4-G-3.5_1x04_P3.50mm_Vertical
J20: ENCODER 3; PhoenixContact_MCV_1,5_4-G-3.5_1x04_P3.50mm_Vertical
J21: ENCODER 4; PhoenixContact_MCV_1,5_4-G-3.5_1x04_P3.50mm_Vertical
J22: ENCODER 5; PhoenixContact_MCV_1,5_4-G-3.5_1x04_P3.50mm_Vertical
J23: ENCODER 6; PhoenixContact_MCV_1,5_4-G-3.5_1x04_P3.50mm_Vertical
J24: TOUCH 1; PhoenixContact_MCV_1,5_2-G-3.5_1x02_P3.50mm_Vertical
J25: TOUCH 2; PhoenixContact_MCV_1,5_2-G-3.5_1x02_P3.50mm_Vertical
R56: 330k; R_0603_1608Metric; LCSC C23137
R57, R59, R77, R78, R79, R80, R81, R82, R83, R84, R85, R86, R87, R88, R89, R90, R91, R92, R93: 1k; R_0603_1608Metric; LCSC C21190
R58, R60: 100k; R_0603_1608Metric; LCSC C25803
R61: 10k; R_0603_1608Metric; LCSC C25804
R62, R63, R64, R65, R66, R67, R68, R69, R70, R71, R72, R73, R74, R75, R76: 10; R_0603_1608Metric; LCSC C22859
U12, U13, U14, U15, U16: LM339DR; SOIC-14_3.9x8.7mm_P1.27mm; LCSC C7948

Connections:
+3V3: C29.1, C30.1, C31.1, C32.1, C33.1, J18.2, J19.2, J20.2, J21.2, J22.2, J23.2, J24.1, J25.1, R56.1, R58.1, R60.1, R77.1, R78.1, R79.1, R80.1, R81.1, R82.1, R83.1, R84.1, R85.1, R86.1, R87.1, R88.1, R89.1, R90.1, R91.1, R92.1, R93.1, U12.3 (V+), U13.3 (V+), U14.3 (V+), U15.3 (V+), U16.3 (V+); also elsewhere on the board
ENC1_GND: J18.1, R71.1, U14.6 (-)
ENC1_SCL: J18.3; also elsewhere on the board
ENC1_SDA: J18.4; also elsewhere on the board
ENC2_GND: J19.1, R72.1, U14.10 (-)
ENC2_SCL: J19.3; also elsewhere on the board
ENC2_SDA: J19.4; also elsewhere on the board
ENC3_GND: J20.1, R73.1, U14.8 (-)
ENC3_SCL: J20.3; also elsewhere on the board
ENC3_SDA: J20.4; also elsewhere on the board
ENC4_GND: J21.1, R74.1, U15.4 (-)
ENC4_SCL: J21.3; also elsewhere on the board
ENC4_SDA: J21.4; also elsewhere on the board
ENC5_GND: J22.1, R75.1, U15.6 (-)
ENC5_SCL: J22.3; also elsewhere on the board
ENC5_SDA: J22.4; also elsewhere on the board
ENC6_GND: J23.1, R76.1, U15.10 (-)
ENC6_SCL: J23.3; also elsewhere on the board
ENC6_SDA: J23.4; also elsewhere on the board
GND: C29.2, C30.2, C31.2, C32.2, C33.2, D7.1 (K), D8.1 (K), D9.1 (K), D10.1 (K), D11.1 (K), D12.1 (K), D13.1 (K), D14.1 (K), D15.1 (K), R57.2, R59.2, R61.2, R62.2, R63.2, R64.2, R65.2, R66.2, R67.2, R68.2, R69.2, R70.2, R71.2, R72.2, R73.2, R74.2, R75.2, R76.2, U12.12 (V-), U13.12 (V-), U14.12 (V-), U15.12 (V-), U16.7 (+), U16.9 (+), U16.11 (+), U16.12 (V-); also elsewhere on the board
LED_ENC1_A: D25.2 (A), R86.2
LED_ENC1_K: D25.1 (K), U14.1
LED_ENC2_A: D26.2 (A), R87.2
LED_ENC2_K: D26.1 (K), U14.13
LED_ENC3_A: D27.2 (A), R88.2
LED_ENC3_K: D27.1 (K), U14.14
LED_ENC4_A: D28.2 (A), R89.2
LED_ENC4_K: D28.1 (K), U15.2
LED_ENC5_A: D29.2 (A), R90.2
LED_ENC5_K: D29.1 (K), U15.1
LED_ENC6_A: D30.2 (A), R91.2
LED_ENC6_K: D30.1 (K), U15.13
LED_SERVO1_A: D16.2 (A), R77.2
LED_SERVO1_K: D16.1 (K), U12.2
LED_SERVO2_A: D17.2 (A), R78.2
LED_SERVO2_K: D17.1 (K), U12.1
LED_SERVO3_A: D18.2 (A), R79.2
LED_SERVO3_K: D18.1 (K), U12.13
LED_SERVO4_A: D19.2 (A), R80.2
LED_SERVO4_K: D19.1 (K), U12.14
LED_SERVO5_A: D20.2 (A), R81.2
LED_SERVO5_K: D20.1 (K), U13.2
LED_SERVO6_A: D21.2 (A), R82.2
LED_SERVO6_K: D21.1 (K), U13.1
LED_SERVO7_A: D22.2 (A), R83.2
LED_SERVO7_K: D22.1 (K), U13.13
LED_SERVO8_A: D23.2 (A), R84.2
LED_SERVO8_K: D23.1 (K), U13.14
LED_SERVO9_A: D24.2 (A), R85.2
LED_SERVO9_K: D24.1 (K), U14.2
LED_TOUCH1_A: D31.2 (A), R92.2
LED_TOUCH1_K: D31.1 (K), U15.14
LED_TOUCH2_A: D32.2 (A), R93.2
LED_TOUCH2_K: D32.1 (K), U16.2
SERVO1_GND: D7.2 (A), J9.1, R62.1, U12.4 (-)
SERVO1_SIG: J9.3; also elsewhere on the board
SERVO2_GND: D8.2 (A), J10.1, R63.1, U12.6 (-)
SERVO2_SIG: J10.3; also elsewhere on the board
SERVO3_GND: D9.2 (A), J11.1, R64.1, U12.10 (-)
SERVO3_SIG: J11.3; also elsewhere on the board
SERVO4_GND: D10.2 (A), J12.1, R65.1, U12.8 (-)
SERVO4_SIG: J12.3; also elsewhere on the board
SERVO5_GND: D11.2 (A), J13.1, R66.1, U13.4 (-)
SERVO5_SIG: J13.3; also elsewhere on the board
SERVO6_GND: D12.2 (A), J14.1, R67.1, U13.6 (-)
SERVO6_SIG: J14.3; also elsewhere on the board
SERVO7_GND: D13.2 (A), J15.1, R68.1, U13.10 (-)
SERVO7_SIG: J15.3; also elsewhere on the board
SERVO8_GND: D14.2 (A), J16.1, R69.1, U13.8 (-)
SERVO8_SIG: J16.3; also elsewhere on the board
SERVO9_GND: D15.2 (A), J17.1, R70.1, U14.4 (-)
SERVO9_SIG: J17.3; also elsewhere on the board
TOUCH1: J24.2, U15.8 (-); also elsewhere on the board
TOUCH2: J25.2, U16.4 (-); also elsewhere on the board
VREF_ENC: R58.2, R59.1, U14.7 (+), U14.9 (+), U14.11 (+), U15.5 (+), U15.7 (+), U15.11 (+), U16.6 (-), U16.8 (-), U16.10 (-)
VREF_SERVO: R56.2, R57.1, U12.5 (+), U12.7 (+), U12.9 (+), U12.11 (+), U13.5 (+), U13.7 (+), U13.9 (+), U13.11 (+), U14.5 (+)
VREF_TOUCH: R60.2, R61.1, U15.9 (+), U16.5 (+)
VSERVO: J9.2, J10.2, J11.2, J12.2, J13.2, J14.2, J15.2, J16.2, J17.2; also elsewhere on the board

Notes on the sheet:
Connection LED = current detection on each connector's ground return (no extra pins, no software).
Comparator LM339 (open collector): output low (LED on) when the sense voltage exceeds the reference.
SERVO sense 10 R + SS54, VREF ~10 mV -> detect at 0.5-1.5 mA (servo idle 4-20 mA typ.; confirm by measurement).

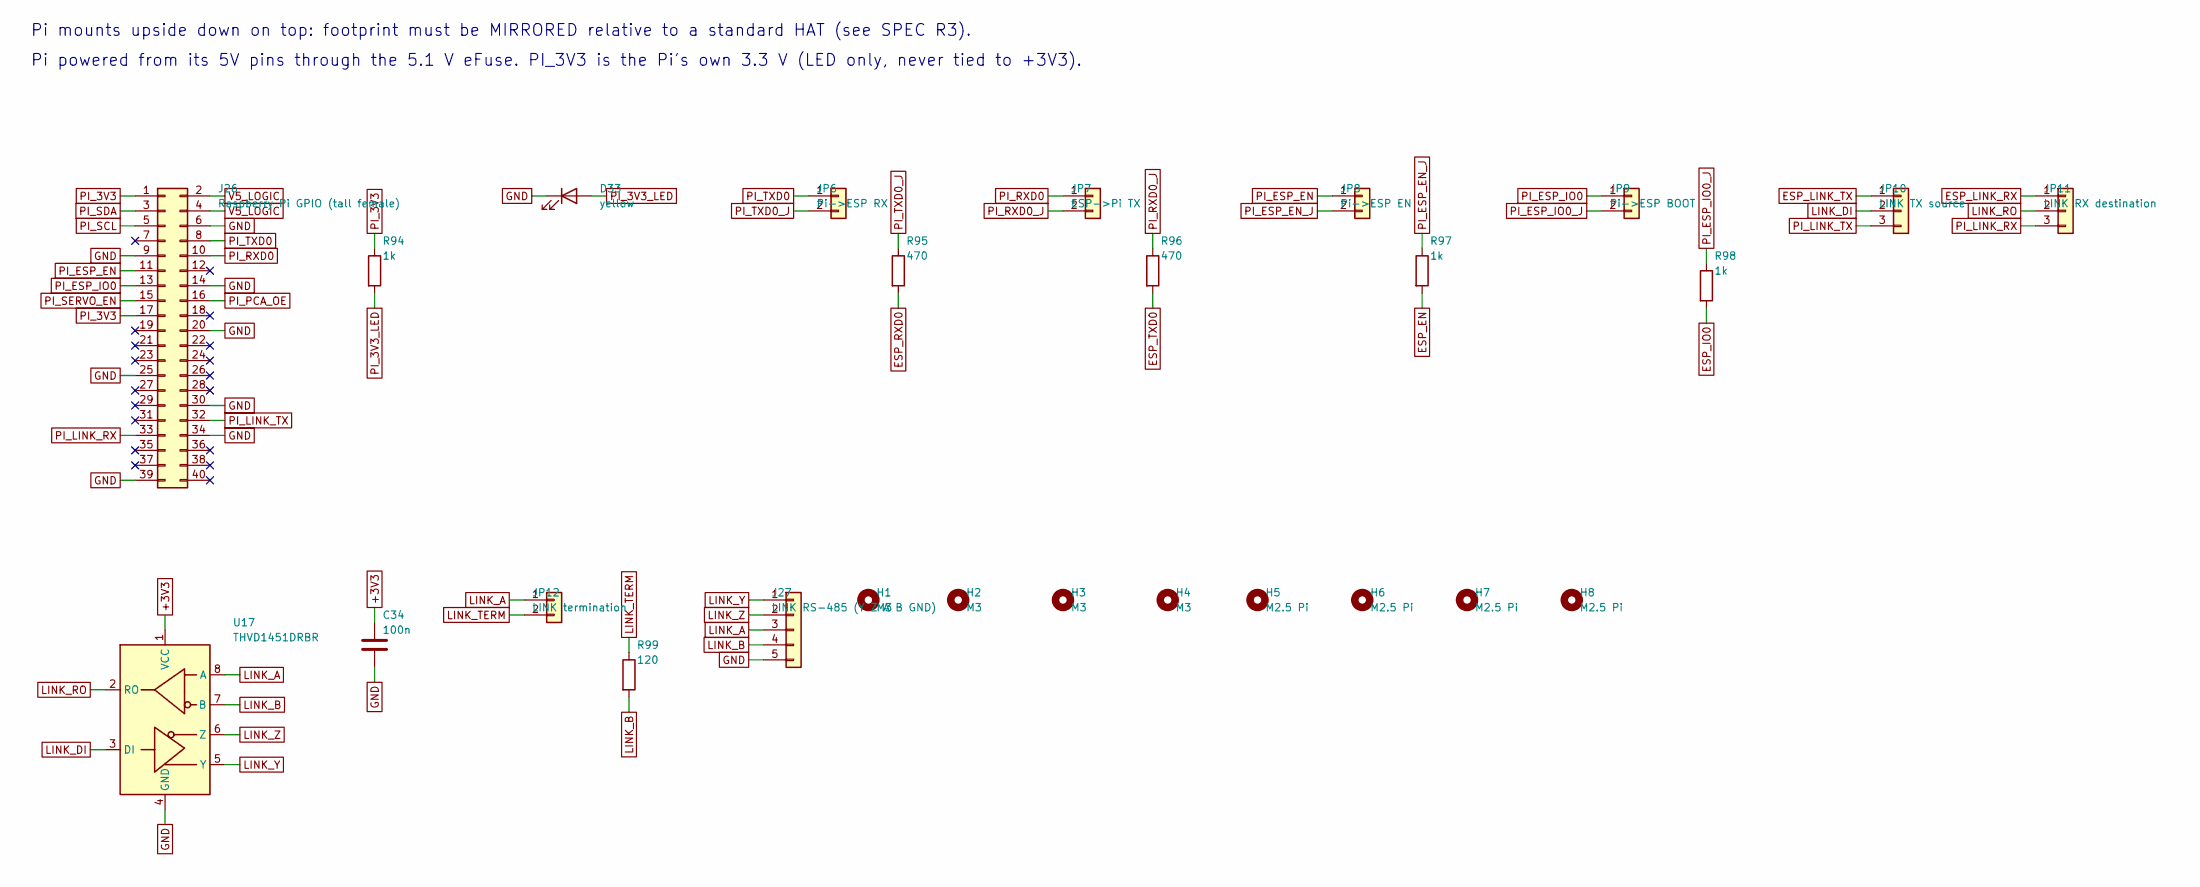
[picture p23: schematic pi_link.kicad_sch, Raspberry Pi header + RS-485 LINK]

Parts:
C34: 100n; C_0603_1608Metric; LCSC C14663
D33: yellow; LED_0603_1608Metric; LCSC C2986063
H1, H2, H3, H4: M3; MountingHole_3.2mm_M3_Pad_Via
H5, H6, H7, H8: M2.5 Pi; MountingHole_2.7mm_M2.5_Pad_Via
J26: Raspberry Pi GPIO (tall female); RPi_Socket_2x20_FaceDown
J27: LINK RS-485 (Y Z A B GND); PhoenixContact_MCV_1,5_5-G-3.5_1x05_P3.50mm_Vertical
JP6: Pi->ESP RX; PinHeader_1x02_P2.54mm_Vertical
JP7: ESP->Pi TX; PinHeader_1x02_P2.54mm_Vertical
JP8: Pi->ESP EN; PinHeader_1x02_P2.54mm_Vertical
JP9: Pi->ESP BOOT; PinHeader_1x02_P2.54mm_Vertical
JP10: LINK TX source; PinHeader_1x03_P2.54mm_Vertical
JP11: LINK RX destination; PinHeader_1x03_P2.54mm_Vertical
JP12: LINK termination; PinHeader_1x02_P2.54mm_Vertical
R94, R97, R98: 1k; R_0603_1608Metric; LCSC C21190
R95, R96: 470; R_0603_1608Metric; LCSC C23179
R99: 120; R_0603_1608Metric; LCSC C22787
U17: THVD1451DRBR; HVSON-8-1EP_3x3mm_P0.65mm_EP1.6x2.4mm; LCSC C2671344

Connections:
+3V3: C34.1, U17.1 (VCC); also elsewhere on the board
ESP_EN: R97.2; also elsewhere on the board
ESP_IO0: R98.2; also elsewhere on the board
ESP_LINK_RX: JP11.1; also elsewhere on the board
ESP_LINK_TX: JP10.1; also elsewhere on the board
ESP_RXD0: R95.2; also elsewhere on the board
ESP_TXD0: R96.2; also elsewhere on the board
GND: C34.2, D33.1 (K), J26.6, J26.9, J26.14, J26.20, J26.25, J26.30, J26.34, J26.39, J27.5, U17.4 (GND); also elsewhere on the board
LINK_A: J27.3, JP12.1, U17.8 (A)
LINK_B: J27.4, R99.2, U17.7 (B)
LINK_DI: JP10.2, U17.3 (DI)
LINK_RO: JP11.2, U17.2 (RO)
LINK_TERM: JP12.2, R99.1
LINK_Y: J27.1, U17.5 (Y)
LINK_Z: J27.2, U17.6 (Z)
PI_3V3: J26.1, J26.17, R94.1
PI_3V3_LED: D33.2 (A), R94.2
PI_ESP_EN: J26.11, JP8.1
PI_ESP_EN_J: JP8.2, R97.1
PI_ESP_IO0: J26.13, JP9.1
PI_ESP_IO0_J: JP9.2, R98.1
PI_LINK_RX: J26.33, JP11.3
PI_LINK_TX: J26.32, JP10.3
PI_PCA_OE: J26.16; also elsewhere on the board
PI_RXD0: J26.10, JP7.1
PI_RXD0_J: JP7.2, R96.1
PI_SCL: J26.5; also elsewhere on the board
PI_SDA: J26.3; also elsewhere on the board
PI_SERVO_EN: J26.15; also elsewhere on the board
PI_TXD0: J26.8, JP6.1
PI_TXD0_J: JP6.2, R95.1
V5_LOGIC: J26.2, J26.4; also elsewhere on the board

Notes on the sheet:
Pi mounts upside down on top: footprint must be MIRRORED relative to a standard HAT (see SPEC R3).
Pi powered from its 5V pins through the 5.1 V eFuse. PI_3V3 is the Pi's own 3.3 V (LED only, never tied to +3V3).

Board: 4 copper layers, 235 parts (0 on the bottom side), 185 nets, no tracks yet.
