FotisRousogiannis/Master-s-Thesis/(commit log)

2026-10-15 ΔΗΜΙΟΥΡΓΙΑ WORD, συγγραφη εισαγωγης και σκοπου
2026-10-20 Προσθήκη σημειώσεων εργασίας (NOTES.md)
2026-10-20 chore: scaffold dev environment and provisional arm_description
    - move thesis .docx to thesis/
    - add Docker (ROS 2 Jazzy + Gazebo Harmonic) and devcontainer
    - add arm_description with provisional 6-DOF URDF, RViz launch and tests
    Work in progress: architecture still under discussion.
2026-10-20 docs: record system architecture decisions (ADR-0001..0009)
    - add ADR index and template
    - add architecture overview and development log
    - update NOTES.md with repo layout, branch flow and architecture summary
2026-11-01 test(wrist): record first I2C scan, PCA9685 behind mux channel 0
2026-11-01 test(wrist): map AS5600 encoders to mux channels 1, 6, 7
2026-11-01 feat(wrist): add probe command to map PCA channels to servos and encoders
2026-11-01 feat(wrist): add keyboard jog (hold-to-run W/S, A/D speed, live encoders)
2026-11-01 feat(wrist): allow jog without encoders
2026-11-01 fix(wrist): raise pulse limits to match servo spec (500-2500 us, neutral 1600)
2026-11-01 fix(wrist): full speed range and mirrored differential motor from old calibration
2026-11-01 fix(wrist): probe uses jog start speed by default, prints progress
2026-11-05 docs(hardware): add bench wiring and ADS1115 + FSR402 gripper sensor wiring
2026-11-05 docs(hardware): gripper touch sensors are ZD10, adjust divider
2026-11-05 docs(hardware): ZD10 divider resistor 5.6 kOhm from measured sensor range
2026-11-06 docs(hardware): ZD10 divider uses measured 6.1 kOhm resistor
2026-11-06 docs(hardware): verify ZD10 divider output at max pressure (2.5 V)
2026-11-06 docs(hardware): ZD10 divider resistor is 6.8 kOhm
2026-11-07 docs: update notes and devlog with bench, touch sensors and PCB status
2026-11-07 docs(pcb): propose common segment board with ESP32 and Pi HAT (ADR-0013, spec)
2026-11-07 docs(pcb): switch segment board to SMD with factory assembly
2026-11-07 docs(pcb): accept segment board spec (4 layers, 5 pcs, servo/encoder split)
2026-11-07 docs(pcb): decide controller links (UART, RS-485) and ESP32-S3-WROOM-1 module (ADR-0014)
2026-11-07 docs(pcb): use Phoenix MC 1,5 3.5 mm connectors to match arm wiring
2026-11-07 docs(pcb): record existing arm wiring, encoder pinout and board locations
2026-11-07 docs(pcb): each board supports the whole arm (9 servo, 6 encoders, 2 touch), corner M3 mounts
2026-11-07 docs(pcb): Pi mounted upside down on top via tall header, powered from GPIO 5V pins
2026-11-07 docs(pcb): per-connector resettable fuse with indicator LED
2026-11-08 docs(pcb): v1 uses software-driven connection LEDs; list v2 ideas
2026-11-08 docs: power architecture v1 (ADR-0015)
2026-11-08 feat(pcb): JLCPCB availability BOM and stock check script
2026-11-08 docs(pcb): eFuses on 7.4 V and 5.1 V inputs
2026-11-08 feat(pcb): segment board v1 schematic generated from code
    - gen/build.py defines the whole circuit (5 sheets, 233 parts)
    - project symbols for TPS259827, TPS259472A, LM66100, AO4407A from datasheets
    - netlist checker, PDF export, spec/BOM updates (hardware connection LEDs, THVD1451)
2026-11-08 ci: KiCad 9 ERC, netlist check and schematic PDF for the segment board
2026-11-08 fix(pcb): leave LM66100 status outputs unconnected (ERC); CI loads default KiCad libraries
2026-11-08 pcb(sim): SPICE checks of touch divider, connection detectors and LED current
2026-11-08 pcb: servo connection sense resistor 4.7 -> 10 ohm (detect at 0.5-1.5 mA)
2026-11-08 pcb: servo ground clamp SS34 -> SS54 for stall current; sim up to 4 A
2026-11-08 pcb: project footprints, LCSC codes for all SMD parts, initial board with JLC rules and net classes; CI DRC
2026-11-08 pcb: fix RGE0024 pad rows (3.825 mm centre-to-centre), regenerate initial board; CI lists DRC errors
2026-11-08 pcb: 7.4 V and 5.1 V outputs to the next board (before the eFuse); regenerate initial board
2026-11-08 βηματα 3 και 4
    Πήγαινε στο Tools → Update PCB from Schematic (F8). Πρέπει να δείξει μόνο μικρές αλλαγές. Πάτα «Update PCB».
    Πήγαινε στο Tools → Update Footprints from Library, διάλεξε όλα τα footprints και πάτα «Update».
2026-11-08 pcb: CI on KiCad 10, restore net classes and rules, ignore KiCad lock files and local history
2026-11-08 pcb: project copy of the HRO USB-C footprint (shield pads S1, KiCad 10 renamed them)
2026-11-08 pcb: mounting holes to GND, THVD1451 symbol with thermal pad to GND
